Kyklas/projet-plury-4eii-2012/Rapports/MCSE.tex

% !TEX TS-program = pdflatex
% !TEX encoding = UTF-8 Unicode

%%% DOCUMENT DEFINITION
\documentclass[11pt,french]{article} % use larger type; default would be 10pt
\usepackage[utf8]{inputenc} % set input encoding (not needed with XeLaTeX)

%%% PAGE DIMENSIONS
\usepackage{geometry} % to change the page dimensions
\geometry{a4paper} % or letterpaper (US) or a5paper or....
\geometry{margin=1in} % for example, change the margins to 2 inches all round

%%% PACKAGES
\usepackage{graphicx} % support the \includegraphics command and options
\usepackage{booktabs} % for much better looking tables
\usepackage{array} % for better arrays (eg matrices) in maths
\usepackage{paralist} % very flexible & customisable lists (eg. enumerate/itemize, etc.)
\usepackage{verbatim} % adds environment for commenting out blocks of text & for better verbatim
\usepackage{subfig} % make it possible to include more than one captioned figure/table in a single float
\usepackage[frenchb]{babel}
\usepackage{pdflscape}
\usepackage{rotating}

% Package pour schémas MCSE
\usepackage{tikz}
\usetikzlibrary{calc,backgrounds}
\usetikzlibrary{arrows,positioning} 
\usetikzlibrary{decorations,decorations.pathmorphing} 
\usetikzlibrary{shapes,snakes,fit}

% Schémas individuels MCSE
\graphicspath{{../MCSE/}}

%%% HEADERS & FOOTERS
%\usepackage{fancyhdr} % This should be set AFTER setting up the page geometry
%\pagestyle{fancy} % options: empty , plain , fancy

% Rapport projet pluridisciplinaire
% : Xavier Galzin, Stanislas Bertrand, Romain Desille, Frédéric Meslin

\title{Projet pluridisciplinaire : sustentation magnétique}
\author{ Xavier GALZIN, Stan BERTRAND, Romain DESILLE, Fred MESLIN}
\date{30/01/2012}

\begin{document}
\maketitle
\pagebreak

\section*{Introduction}

Dans le cadre du projet pluridisciplinaire, le système étudié est assez complexe et comprend un certain nombre de fonctions parmi lesquelles on peut compter : 

\vspace{0.1cm}

\begin{itemize}
\item{la communication série}
\item{la gestion de la PWM}
\item{la gestion de la conversion analogique-numérique}
\end{itemize}

\vspace{0.3cm}

Afin d'éviter l'écueil fréquent qui consiste à concevoir la solution au même moment que la programmation et à aboutir à des solutions non fonctionnelles qui font finalement perdre du temps, nous allons mener une démarche de conception type Méthodologie et Conception de Systèmes Electroniques. 

\vspace{0.3cm}

Cette démarche s'articulera en deux parties principales. En premier lieu, nous définirons la spécification fonctionnelle qui comprend l'analyse de l'environnement, la délimitation des entrées-sorties du système ainsi que la spécifications fonctionnelle du système. Enfin, nous n'étudierons que la décomposition fonctionnelle de la partie de conception fonctionnelle. 

\pagebreak

\input{MCSE/Styles}
\part{Spécification fonctionnelle}

\setcounter{section}{0}

\section{Analyse de l'environnement}

\paragraph{} Dans cette partie, nous allons expliciter la décomposition en entités que nous avons retenu.
\vspace{0.2in}

\begin{minipage}[t]{9cm}
\hspace{0.2in}
\underline{Convertisseur Analogique-Numérique}
\begin{description}
\item[Sortie :] Sample, information, entier
\item[Sortie :] S\_Available, évènement
\item[Entrée :] S\_Query, évènement
\end{description}

\input{MCSE/Convertisseur.tex}
\end{minipage}
~
\begin{minipage}[t]{8cm}
\hspace{0.2in}
\underline{Pilotage Bobine (PWM)}
\begin{description}
\item[Entrée : ] Out, donnée permanente, entier
\end{description}

\input{MCSE/Pilotage.tex}
\end{minipage}

\begin{minipage}[h]{20cm}
\vspace{-1cm}
\hspace{0.2in}
\underline{Utilisateur}   
\begin{description}
\item[Sortie : ] Rx, donnée permanente, bit
\item[Entrée : ] Tx, donnée permanente, bit
\end{description}

 Pour des raisons de simplicité et d'uniformisation de l'envoi-réception de données, nous avons choisi d'envoyer et de recevoir trois octets à chaque transfert quelque soit la donnée transmise : un octet de commande et deux octets de donnée. Les bits non utilisées seront simplement mis à 0. 

\input{MCSE/Ordinateur.tex}
\vspace{-2cm}
\end{minipage}

\newpage

Les fonctions de Transmission/Réception, sont respectivement representées avec $T_x$ et $R_x$, or les deux péripheriques de communication série sont reliés via un cable croisé. Le $T_x$ de l'utilisateur est donc en realité le $R_x$ du système et inversement.

\begin{minipage}[t, h]{5cm}
\hspace{0.2in}
\underline{Fonction Transmission}
\end{minipage}
~
\begin{minipage}[t, h]{9cm}
\input{MCSE/Transmition.tex}
\end{minipage}

\begin{minipage}[t, h]{5cm}
\hspace{0.2in}
\underline{Fonction Réception}
\end{minipage}
~
\begin{minipage}[t, h]{9cm}
\input{MCSE/Reception.tex}
\end{minipage}

\section{Délimitation des E/S du système}

\input{MCSE/Systeme.tex}

\section{Spécification fonctionnelle du système}

Le système sera décomposé en trois blocs :
\vspace{0.1in}
\begin{description}
\item[Correction - Asservissement : ] Acquisition des données, Correction et Pilotage du PWM.
\item[Horloge : ] Gestion des différents temps et envoi des événements appropriés.
\item[Gestion Communication : ] Gestion de la communication avec l'utilisateur.
\end{description}

\vspace{0.2in}
\underline{Correction - Asservissement}

\begin{center}
\input{MCSE/CorrectionAsservissement.tex}
\end{center}

\vspace{0.2in}
\underline{Horloge}

\begin{minipage}[t, h]{8cm}
\input{MCSE/HorlogueIclk.tex}
\end{minipage}
~
\begin{minipage}[t, h]{8cm}
\input{MCSE/HorlogueTe.tex}
\end{minipage}

\underline{Gestion Communication}
\vspace{0.2in}

La partie Gestion Communication avec l'utilisateur est séparée en trois fonctions. La fonction de \textbf{gestion} lance les fonctions d'\textbf{écriture} ou de \textbf{lecture} suivant la valeur de RW.

%\vspace{0.2in}
%\hspace{0.2in}
%\underline{Modification}
%
%\begin{center}
%\input{MCSE/Modif.tex}
%\end{center}

\vspace{0.2in}
\hspace{0.2in}
\underline{Gestion Communication (Principale)}

\begin{center}
\input{MCSE/Communication.tex}
\end{center}

\pagebreak
\begin{landscape}

\hspace{0.2in}
\underline{Mode Lecture}

\hspace{-0.7in}
\input{MCSE/CommunicationRead.tex}

\vspace{0.5in}

\hspace{0.2in}
\underline{Mode Ecriture}

\hspace{-0.7in}
\input{MCSE/CommunicationWrite.tex}

\end{landscape}

\part{Conception fonctionnelle}

\setcounter{section}{0}

\section{Décomposition fonctionnelle}

\begin{center}
\begin{turn}{90}
\input{MCSE/ConceptFonct.tex}
\end{turn}
\end{center}

\pagebreak

\setcounter{section}{0}

\section*{Conclusion}

Grâce à l'étude type MCSE que nous avons mené, nous avons pu décomposer notre système en fonctions élémentaires. Cela facilitera la programmation en la rendant plus modulaire et donc plus facilement débuggable.  

\vspace{0.2cm}

En outre, en ce qui concerne la communication, nous avons pu envisager les problèmes possibles à l'avance et donc concevoir un protocole robuste permettant de les gérer. Cela sera très certainement bénéfique pour la phase de développement afin d'éviter une majorité des difficultés et de pouvoir résoudre rapidement celles qui subsisteraient.  
\end{document}
