Kyklas/projet-plury-4eii-2012/Rapports/MCSE/ConceptFonct.tex

\tikzset{
VPH/.style={inner sep=0,minimum width=0.4cm,minimum height=0.2cm,
path picture={\draw[-,black] (path picture bounding box.west) -- (path picture bounding box.east);
\draw[-,black] (path picture bounding box.north west) -- (path picture bounding box.south west);
\draw[-,black] (path picture bounding box.north east) -- (path picture bounding box.south east);}},
VPV/.style={inner sep=0,minimum height=0.4cm,minimum width=0.2cm,
path picture={\draw[-,black] (path picture bounding box.north) -- (path picture bounding box.south);
\draw[-,black] (path picture bounding box.north west) -- (path picture bounding box.north east);
\draw[-,black] (path picture bounding box.south west) -- (path picture bounding box.south east);}}}

\shorthandoff{:}
\begin{tikzpicture}[font=\small]

\node[draw,align=center,inner sep=10pt] (CORR) {Correction\\Asservissement};

\foreach \id in {1,...,3}
{
\coordinate (CORR-N\id) at ($(CORR.north)+(\id*0.7cm-1.4cm,0)$);
}

\foreach \id in {1,...,4}
{
\coordinate (CORR-E\id) at ($(CORR.north east)+(0,-\id*0.3cm)$);
}

\node at ($(CORR)+(5,-2.4)$) [draw,align=center,inner sep=10pt] (COMM) {Gestion\\Communication};
\foreach \id in {-1,1}
{
\coordinate (COMM-S\id) at ($(COMM.south)+(\id*0.3cm,0)$);
}
\foreach \id in {1,...,4}
{
\coordinate (COMM-N\id) at ($(COMM.north east)+(-\id*0.7cm,0)$);
}

\foreach \id in {1,...,2}
{
\coordinate (COMM-E\id) at ($(COMM.east)+(0,-\id*0.6cm+0.9cm)$);
}

\node at ($(CORR)+(0,-4)$) [draw,align=center,inner sep=10pt] (CLK) {Clock};

\foreach \id in {-1,1}
{
\coordinate (CLK-E\id) at ($(CLK.east)+(0,\id*0.2cm)$);
}

\node[draw,inner sep=20pt,fit=(CORR) (COMM) (CLK)](SYS) {};

\node at ($(CORR.north)+(0,2.5)$) [ellipse,decoration={bumps,mirror},decorate,draw,align=center] 
(CONV)
{Convertisseur \\ Analogique-Numérique};

\foreach \id in {1,...,3}
{
\coordinate (CONV-S\id) at ($(CONV.south)+(\id*0.7cm-1.4cm,0)$);
}

\node at ($(CORR.west)+(-5,0)$) [ellipse,decoration={bumps,mirror},decorate,align=center,draw] 
(BOB)
{Pilotage Bobine \\ Pulse Width Modulation};

\node at ($(COMM)+(5,0)$) [ellipse,decoration={bumps,mirror},inner sep=0.3cm,decorate,draw]
(USER)
{Utilisateur};

\foreach \id in {1,...,2}
{
\coordinate (USER-W\id) at ($(USER.west)+(0,-\id*0.6cm+0.9cm)$);
}

\path (USER-W1) -- node[VPV,label={[label distance = 0.1cm]above right:Rx}] (mid) {} (COMM-E1);
\draw[->] (USER-W1) -- (mid.center);
\draw[->] (mid.center) -- (COMM-E1);

\path (USER-W2) -- node[VPV,label={[label distance = 0.1cm]above right:Tx}] (mid) {} (COMM-E2);
\draw[<-] (USER-W2) -- (mid.center);
\draw[<-] (mid.center) -- (COMM-E2);

\path (CORR) -- node[VPV,label={[label distance = 0.2cm]above left:Out}] (mid) {} (BOB);
\draw[->] (CORR) -- (mid.center);
\draw[->] (mid.center) -- (BOB);

\path (COMM-N1) |- node[VPV,label={[label distance = 0.1cm,pos=0.6]above left:Consigne},pos=0.6] (mid) {} (CORR-E1);
\draw[->] (COMM-N1) |- (mid.center);
\draw[->] (mid.center) -- (CORR-E1);

\path (COMM-N2) |- node[VPH,label={[label distance = 0.05cm,pos=0.1]above left:Kp},pos=0.1] (mid) {} (CORR-E2);
\draw[->] (COMM-N2) -- (mid.center);
\draw[->] (mid.center) |- (CORR-E2);
\path (COMM-N3) |- node[VPH,label={[label distance = 0.05cm,pos=0.1]above left:Td},pos=0.1] (mid) {} (CORR-E3);
\draw[->] (COMM-N3) -- (mid.center);
\draw[->] (mid.center) |- (CORR-E3);
\path (COMM-N4) |- node[VPH,label={[label distance = 0.1cm,pos=0.1]above left:Nb acquisition},pos=0.1] (mid) {} (CORR-E4);
\draw[->] (COMM-N4) -- (mid.center);
\draw[->] (mid.center) |- (CORR-E4);

\path (COMM-S-1) |- node[VPH,label={[label distance = 0.1cm,pos=0.3] left:Te},pos=0.3] (mid) {} (CLK-E1);
\draw[->] (COMM-S-1) -- (mid.center);
\draw[->] (mid.center) |- (CLK-E1);

\draw[dashed] (CLK) -- node[solid,isosceles triangle,draw,pos=0.5,rotate=90,fill=white,minimum size=3mm,inner sep=0,label={[label distance = 0.2cm,pos=0.5]below:$Te_{clk}$}] {} (CORR);

\draw[dashed] (CLK-E-1) -| node[solid,isosceles triangle,draw,pos=0.3,fill=white,minimum size=3mm,inner sep=0,label={[label distance = 0.2cm,pos=0.3]below:$Te_{clk}$}] {} (COMM-S1);

\draw[dashed] (CONV-S1) -- node[solid,isosceles triangle,draw,pos=0.5,rotate=90,fill=white,minimum size=3mm,inner sep=0,
		label={[label distance = 0.1cm,pos=0.5]above right:S\_Querry}] {} (CORR-N1);

\path (CONV-S2) -- node[VPH,label={[label distance = 0.1cm,pos=0.5,rotate=-90] above:Sample},pos=0.5] (mid) {} (CORR-N2);
\draw[->] (CONV-S2) -- (mid.center);
\draw[->] (mid.center) -- (CORR-N2);

\draw[dashed] (CONV-S3) -- node[solid,isosceles triangle,draw,pos=0.5,rotate=-90,fill=white,minimum size=3mm,inner sep=0,
		label={[label distance = 0.1cm,pos=0.5]above left:S\_available}] {} (CORR-N3);

\end{tikzpicture}
