Kyklas/projet-plury-4eii-2012/Rapports/MCSE/Ordinateur.tex

\vspace{-2cm}
\hspace{-4cm}
\begin{tikzpicture}%[every node/.style={font=\tiny}]

\Etape{T}{}

\draw (T) -- ($(T)+(-4,0)$) node[inner sep=0,outer sep=0] (E3) {};

\TransLink{T1}{Volonté Ecriture}{E3}

\EtapeLink{E1}{$T_{Data}:=Commande$, /Volonté d'envoyer}{T1}

\TransLink{T2}{Fin Transmition}{E1}

\EtapeLink{E2}{$T_{Data}:=Donnee_{[15,8]}$, /Volonté d'envoyer}{T2}

\TransLink{T3}{Fin Transmition}{E2}

\EtapeLink{E2}{$T_{Data}:=Donnee_{[7,0]}$, /Volonté d'envoyer}{T3}

\TransLink{T3}{Fin Transmition}{E2}

\draw[->] (T3) edge [out=-90, in=160,out distance=4cm,in distance=9cm] node[inner sep=0,outer sep=0,minimum width=0cm,pos=0.2] (RET){} (T);

\draw (T) -- ($(T)+(4,0)$) node[inner sep=0,outer sep=0] (E1) {};

\TransLink{T1}{Volonté Lecture}{E1}

\EtapeLink{E1}{$T_{Data}:=Commande$, /Volonté d'envoyer}{T1}

\TransLink{T2}{Fin Transmition}{E1}

\EtapeLink{E2}{Lecture}{T2}

\TransActionLink{T3}{Fin Réception \\ $Donnee_{[15,8]}=R_{Data}$}{E2}

\EtapeLink{E2}{Lecture}{T3}

\TransActionLink{T3}{Fin Réception \\ $Donnee_{[7,0]}=R_{Data}$}{E2}

\draw[->] (T3) edge [out=-90,in=-48,out distance=1cm] (RET.center);

\end{tikzpicture}
\vspace{-2cm}
