Kyklas/projet-plury-4eii-2012/Rapports/MCSE/Modif.tex

\begin{tikzpicture}\shorthandoff{:}

\node[Etape,double,label={[align=left]right:Modif}] (I) {};

\TransActionLink{T1}{$Cmd.AP = 1$\\ }{I}

\node[align=left,anchor=north west,at =(T1.south east),xshift=10pt] {$K_p := SK_p$\\$T_dT_d$\\$T_e := ST_e$\\$Consigne := SConsigne$\\$Nb_{Acq} := SNb_{Acq}$};

\node[Trans,node distance = 1.1cm, align=center,left of=T1,label=left:{$Cmd.AP = 0$}] (T2) {};

\node[Etape,double,below of=I,node distance=4.5cm,label={[align=left]right:Modif End}] (E) {};

\draw[->] (I) edge [in=90,out=200] (T2);
\draw[->] (T2) edge[out=-90] (E);

\draw[->] (T1) edge (E);

\end{tikzpicture}
