Kyklas/projet-plury-4eii-2012/Rapports/MCSE/Styles.tex

\shorthandoff{:}
\newcommand{\Etape}[2]{
\node[Etape,label={right:#2}] (#1) {};
}
\newcommand{\EtapeLink}[3]{
\node[Etape,below of=#3,label={[align=left]right:#2}] (#1) {};
\draw[->] (#3) -- (#1);
}

\newcommand{\EtapeMacroLink}[3]{
\node[Etape,double,below of=#3,label={[align=left]right:#2}] (#1) {};
\draw[->] (#3) -- (#1);
}

\newcommand{\TransLink}[3]{
\node[Trans,align=center,below of=#3] (#1) {};
\node[align=center,anchor=west,at =(#1.east),xshift=10pt] {#2};
\draw[->] (#3) -- (#1);
}
\newcommand{\TransActionLink}[3]{
\node[Trans,align=center,below of=#3] (#1) {};
\node[Line,align=center,anchor=west,at =(#1.east),xshift=10pt] {#2};
\draw[->] (#3) -- (#1);
}

%	\tikzset{every node/.style={font=\small, node distance =  0.6cm}}
	\tikzset{Etape/.style={draw,black,minimum size=0.6cm,inner sep=0pt,circle,font=\tiny}}
	\tikzset{Trans/.style={draw,black,minimum width=0.6cm,minimum height=0.0cm,inner sep=0pt,outer sep=0pt,rectangle,font=\tiny}}
	
	%\tikzset{Line/.style={path picture={\draw[black] (path picture bounding box.north west) -- (path picture bounding box.north east);}}}
	\tikzset{Line/.style={path picture={\draw[black] (path picture bounding box.west) -- (path picture bounding box.east);}}}
