Kyklas/projet-plury-4eii-2012/Automatique/Constantes.tex

\hspace{1mm} \\ 
\hspace{1mm}\textcolor{green}{\% Paramètres du Système }\\ 
\hspace{1mm} \\ 
\hspace{1mm}\textcolor{green}{\% Modèle Electrique de la Bobine }\\ 
\hspace{1mm}R=2.24; \textcolor{green}{\%Ohm }\\ 
\hspace{1mm}L=1.49e-2; \textcolor{green}{\%H }\\ 
\hspace{1mm} \\ 
\hspace{1mm}\textcolor{green}{\% Modèle d'interaction mécanique de la bobine }\\ 
\hspace{1mm}m=0.1414; \textcolor{green}{\%Kg }\\ 
\hspace{1mm}ki=0.446; \textcolor{green}{\%N.A-1 }\\ 
\hspace{1mm}kx=131.54; \textcolor{green}{\%N.m-1 }\\ 
\hspace{1mm} \\ 
\hspace{1mm}\textcolor{green}{\% Modèle capteur effet Hall }\\ 
\hspace{1mm}Kc\_Hall=36.5;  \\ 
\hspace{1mm} \\
