Kyklas/projet-plury-4eii-2012/Rapports/MCSE/Transmition.tex

\begin{tikzpicture}[every node/.style={font=\footnotesize, node distance =  0.7cm}]
\Etape{I}{$T_x:=Bit_{Stop}$}
\TransLink{T1}{Volonté d'envoyer}{I}
\EtapeLink{S}{$T_x:=Bit_{Start}$}{T1}
\TransActionLink{T2}{$\uparrow$ I$_{clk}$ \\ $i:=8$}{S}
\EtapeLink{D}{\emph{Bit de donnée}}{T2}
%\tikzstyle{every label}={draw,red,font=\tiny}

\node[Trans,node distance = 1cm,left of=D] (T) {};
\node[Line,align=center,anchor=east,at =(T.west),xshift=-10pt] (V) {$\uparrow$ I$_{clk}$ $\cdot$ $i>0$\\[1em]$T_x:=T_{Data}[i]$, $i$-\,- };
\draw[->] (D) edge [out=225,in=-90] (T);
\draw[->] (T) edge [out=90,in=135] (D);

\TransLink{T3}{$\uparrow$ I$_{clk}$ $\cdot$ $i=0$}{D}
\EtapeLink{S}{$T_x:=Bit_{Stop}$}{T3}
\TransActionLink{T4}{$\uparrow$ I$_{clk}$ \\ /Fin Transmission}{S}

\draw[-] (T4) edge [out=-90,in=-90] ($(V.west)-(10pt,0)$);
\draw[->] ($(V.west)-(10pt,0)$) edge [out=90] (I);
\end{tikzpicture}
