Kyklas/projet-plury-4eii-2012/Rapports/MCSE/CommunicationWrite.tex

\vspace{-1cm}
\begin{tikzpicture}[every node/.style={font=\footnotesize, node distance =  0.9cm}]
\shorthandoff{:}

\node[Etape,double,label=right:Mode Ecriture] (I) {};
%\Etape{I}{Mode Ecriture}
\TransActionLink{T}{Fin Réception \\ $Donnee_{[15,8]} = R_{Data} $ }{I}
\EtapeLink{I2}{Réception deuxieme octet}{T}

\TransActionLink{T}{Fin Réception \\ $Donnee_{[7,0]} = R_{Data} $ }{I2}
\EtapeLink{I2}{}{T}

\node[Etape,double,below of=I2,node distance=2.5cm,label={[align=left]below right:Mode Ecriture End}] (MODIF) {};
%\TransLink{T21}{1}{MODIF}
%\EtapeLink{E22}{Attente\\Commande}{T21}

\draw (I2) -- ($(I2)+(-11,0)$) node[inner sep=0,outer sep=0] (E10) {};
\TransLink{T10}{$Cmd.P_{[3..0]} = 0 (Aucun)$\\$ + $\\$P_{[3..0]} > 5 (Aucun)$}{E10}

\draw[->] (T10) |- (MODIF);

%\EtapeMacroLink{E11}{Modif}{T10}
%\TransLink{T11}{1}{E11}
%\EtapeLink{E12}{Attente\\Commande}{T11}

\draw (I2) -- ($(I2)+(-6,0)$) node[inner sep=0,outer sep=0] (E20) {};
\TransActionLink{T20}{$Cmd.P_{[3..0]} = 1 $ $(K_p)$ \\ $SK_p$ := $Donnee$ }{E20}
\draw[->] (T20) |- (MODIF);
%\EtapeMacroLink{E21}{Modif}{T20}
%\TransLink{T21}{1}{E21}
%\EtapeLink{E22}{Attente\\Commande}{T21}

\draw (I2) -- ($(I2)+(-1.7,0)$) node[inner sep=0,outer sep=0] (E30) {};
\TransActionLink{T30}{$Cmd.P_{[3..0]} = 2 $ $(T_d$) \\ $ST_d$ := $Donnee$}{E30}
\draw[->] (T30) |- (MODIF);
%\EtapeLink{E31}{}{T30}
%\TransActionLink{T31}{Fin Réception\\$ST_d$ := $R_{Data}$}{E31}
%\EtapeLink{E32}{Attente\\Commande}{T31}
%\TransLink{T32}{/Modif}{E32}
%\EtapeLink{E33}{Attente\\Commande}{T32}

\draw (I2) -- ($(I2)+(+2.6,0)$) node[inner sep=0,outer sep=0] (E40) {};
\TransActionLink{T40}{$Cmd.P_{[3..0]} = 3 $ $(T_e)$ \\$ST_e$ := $Donnee$}{E40}
\draw[->] (T40) |- (MODIF);
%\EtapeLink{E41}{}{T40}
%\TransActionLink{T41}{Fin Réception\\$ST_e$ := $R_{Data}$}{E41}
%\EtapeLink{E42}{Attente\\Commande}{T41}
%\TransLink{T42}{/Modif}{E42}
%\EtapeLink{E43}{Attente\\Commande}{T42}

\draw (I2) -- ($(I2)+(+6.9,0)$) node[inner sep=0,outer sep=0] (E50) {};
\TransActionLink{T50}{$Cmd.P_{[3..0]} = 4 $ $(Consigne)$\\$SConsigne$ := $Donnee_{[9,0]}$}{E50}
\draw[->] (T50) |- (MODIF);
%\EtapeLink{E51}{}{T50}
%\TransActionLink{T51}{Fin Réception\\$SConsigne$ := $R_{Data}$}{E51}
%\EtapeLink{E52}{Attente\\Commande}{T51}
%\TransLink{T52}{/Modif}{E52}
%\EtapeLink{E53}{Attente\\Commande}{T52}

\draw (I2) -- ($(I2)+(+12,0)$) node[inner sep=0,outer sep=0] (E60) {};
\TransActionLink{T60}{$Cmd.P_{[3..0]} = 5 $ $(Nb_{Acq})$\\$SNb_{Acq}$ := $Donnee_{[7,0]}$}{E60}
\draw[->] (T60) |- (MODIF);
%\EtapeLink{E61}{}{T60}
%\TransActionLink{T61}{Fin Réception\\$SNb_{Acq}$ := $R_{Data}$}{E61}
%\EtapeLink{E62}{Attente\\Commande}{T61}
%\TransLink{T62}{/Modif}{E62}
%\EtapeLink{E63}{Attente\\Commande}{T62}
\end{tikzpicture}
