Kyklas/projet-plury-4eii-2012/Rapports/Automatique/SchemaBlocNum.tex

\begin{tikzpicture}\shorthandoff{:}
\sbEntree{Vxc}
\sbComp{Comp}{Vxc}
	\sbRelier[$Vx_C$]{Vxc}{Comp}
\sbBloc{C}{$K_{p}$}{Comp}
	\sbRelier[$\epsilon_x$]{Comp}{C}
\sbBlocL{B}{$BOZ$}{C}	
\sbBlocL{E}{$Sys_{Elec + M\acute{e}ca}$}{B}
\sbBlocL{H}{$K_{Hall}$}{E} 
\sbDecaleNoeudx[3]{H}{Ec}
\node[font=\tiny,label={[font=\tiny]below:$T_e$}] at(Ec)  {};
\draw (H) -- (Ec);
\draw (Ec.north west) -- (Ec.east);

\sbSortie[3]{Vxr}{Ec} 
	\sbRelier{Ec}{Vxr}
	\sbNomLien[0.8]{Vxr}{$Vx_R$} 
\sbDecaleNoeudy{E}{A}
\sbBlocr[0]{A}{$H_{correcteur}$}{A}
\sbRelieryx{Ec-Vxr}{A}
\sbRelierxy{A}{Comp}

\node[draw,dotted,inner sep=8pt,fit=(B) (Ec),label={[font=\small]above:$H_{syst\grave{e}me}$}] {};

\end{tikzpicture}
