Kyklas/projet-plury-4eii-2012/Carte/PCB/descriptif des versions de la puissance 2.txt

puissance2 :   ++ respecte la taille de la carte prévue initialement
               -- des connexions passent entre les pattes du pont en H

puissance2_2 : ++ pas de connexions qui passent entre les pattes du pont en H
               -- agrandissement de la carte (léger) en x et en y

puissance2_3 : ++ pas de connexions qui passent entre les pattes du pont en H, pas d'agrandissement requis
               -- piste de masse longue et torteuse pour relier Vref->C2->Masse
