Kyklas/projet-plury-4eii-2012/Rapports/Presentation.odp

## Projet Pluridisciplinaire


## Plan

- Objectif de la réalisation
  - Etude Analogique
  - Etude Numérique
- Réalisation des cartes
  - Conditionnement et correction analogique
  - Micro-contrôleur
  - Liaison USB
  - Gestion de la puissance
- Résultats de la lévitation
- IHM & communication
- Gimmicks

## Stabilisation Analogique

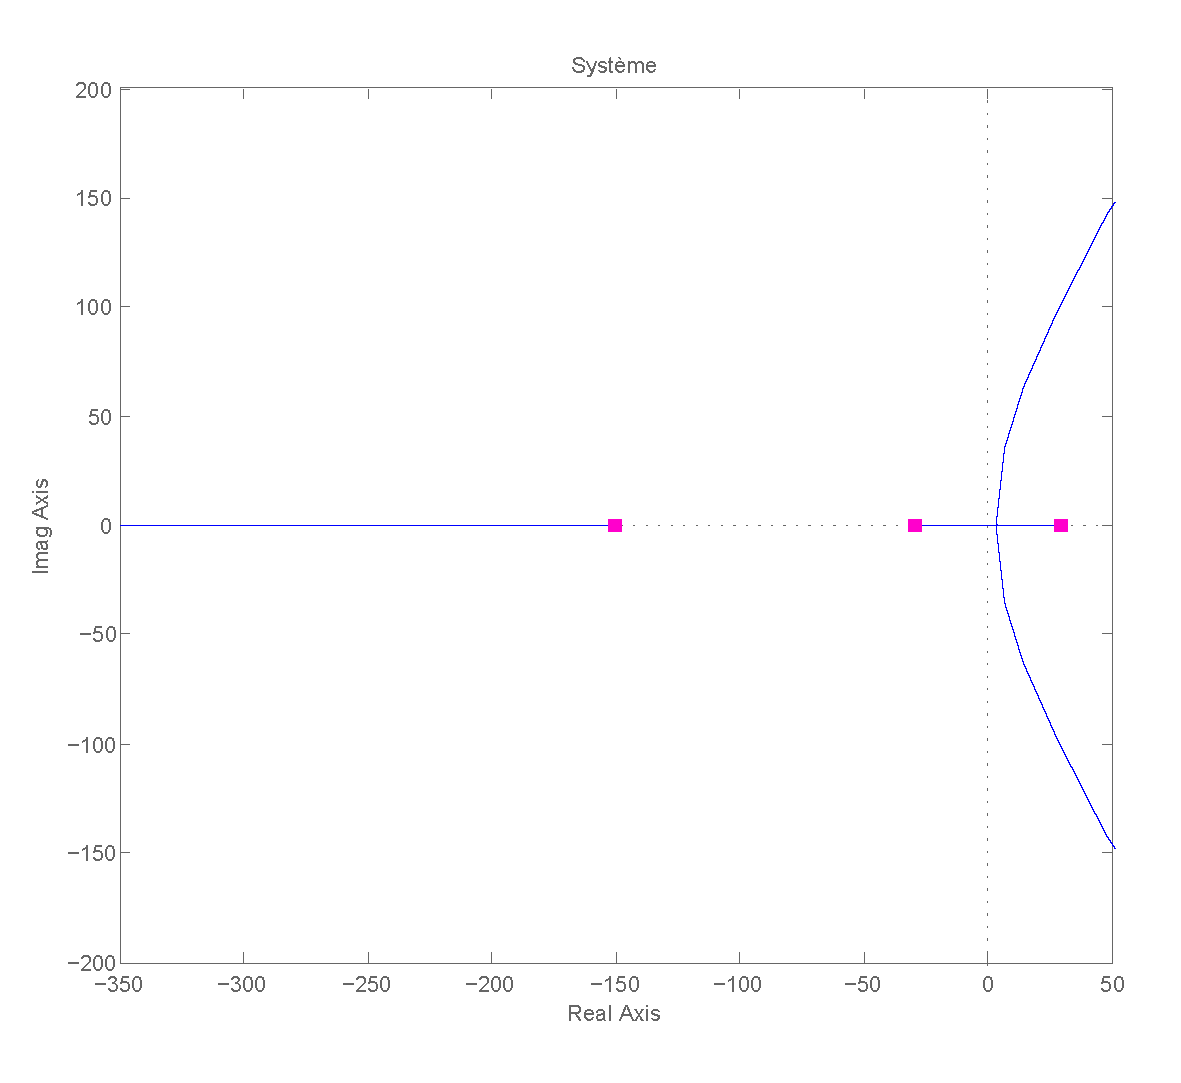
[picture p33: figure]
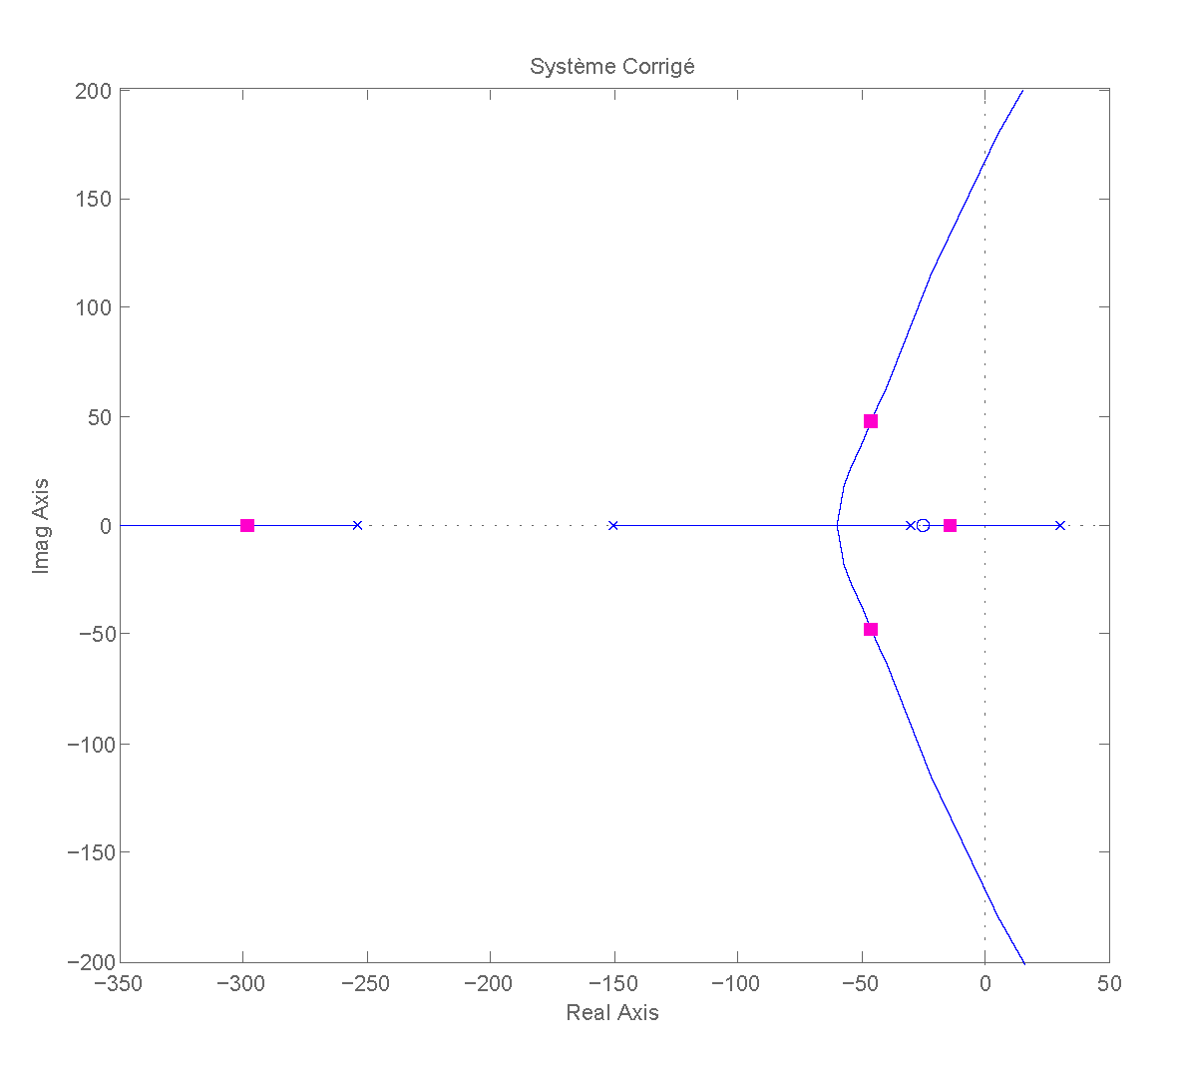
[picture p34: figure]

- Système naturellement instable
- Correction du système par un avance de phase (1 Pôle et 1 Zéro)
  - Position du zéro importante, avant le premier pôle négatif
  - Gain minimum nécessaire : 20

## Stabilisation Numérique

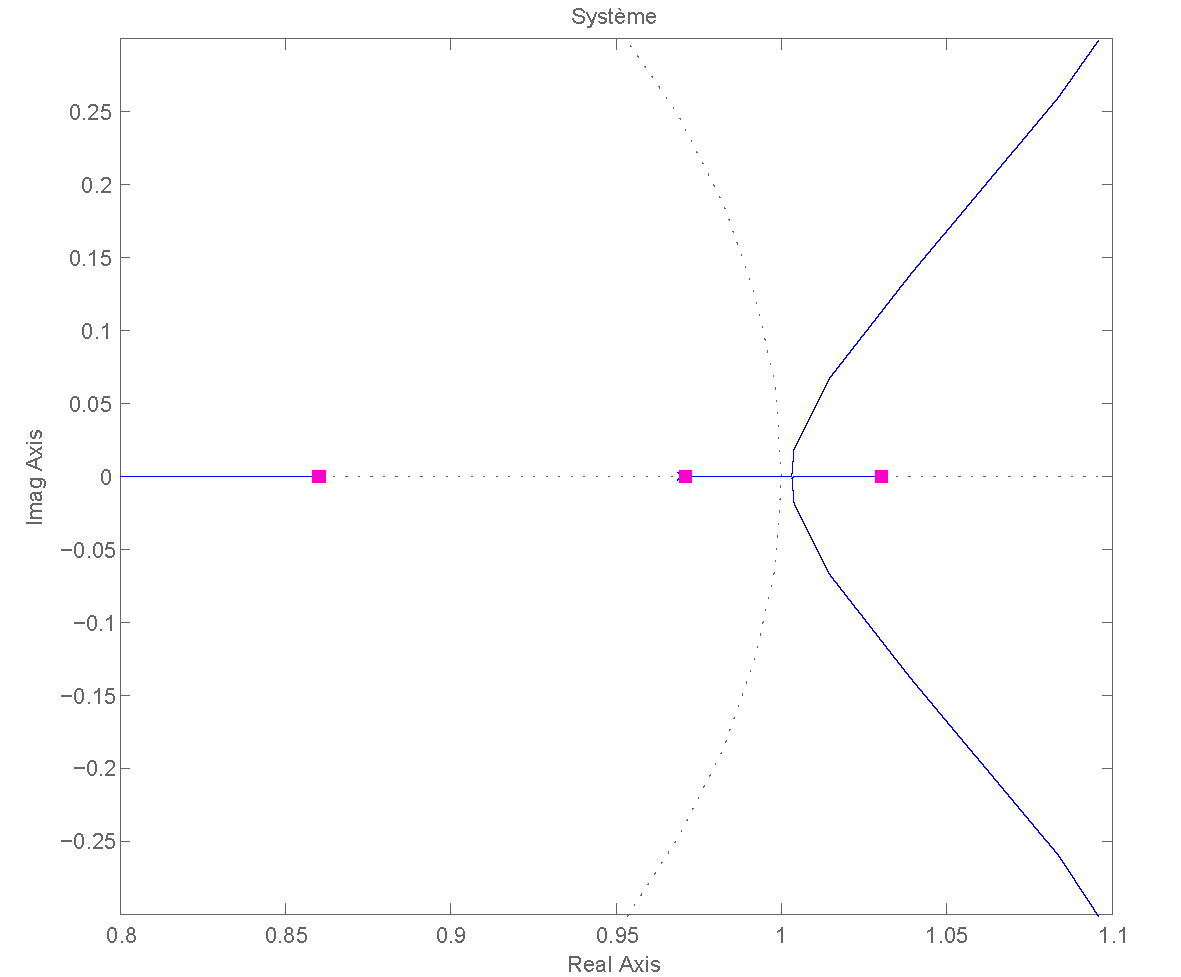
[picture p35: figure]

- Correction du système par un avance de phase (1 Pôle et 1 Zéro)
  - Position du zéro importante, avant le premier pôle négatif
  - Gain minimum nécessaire : 18.5
  - Période d’actualisation : 1 ms

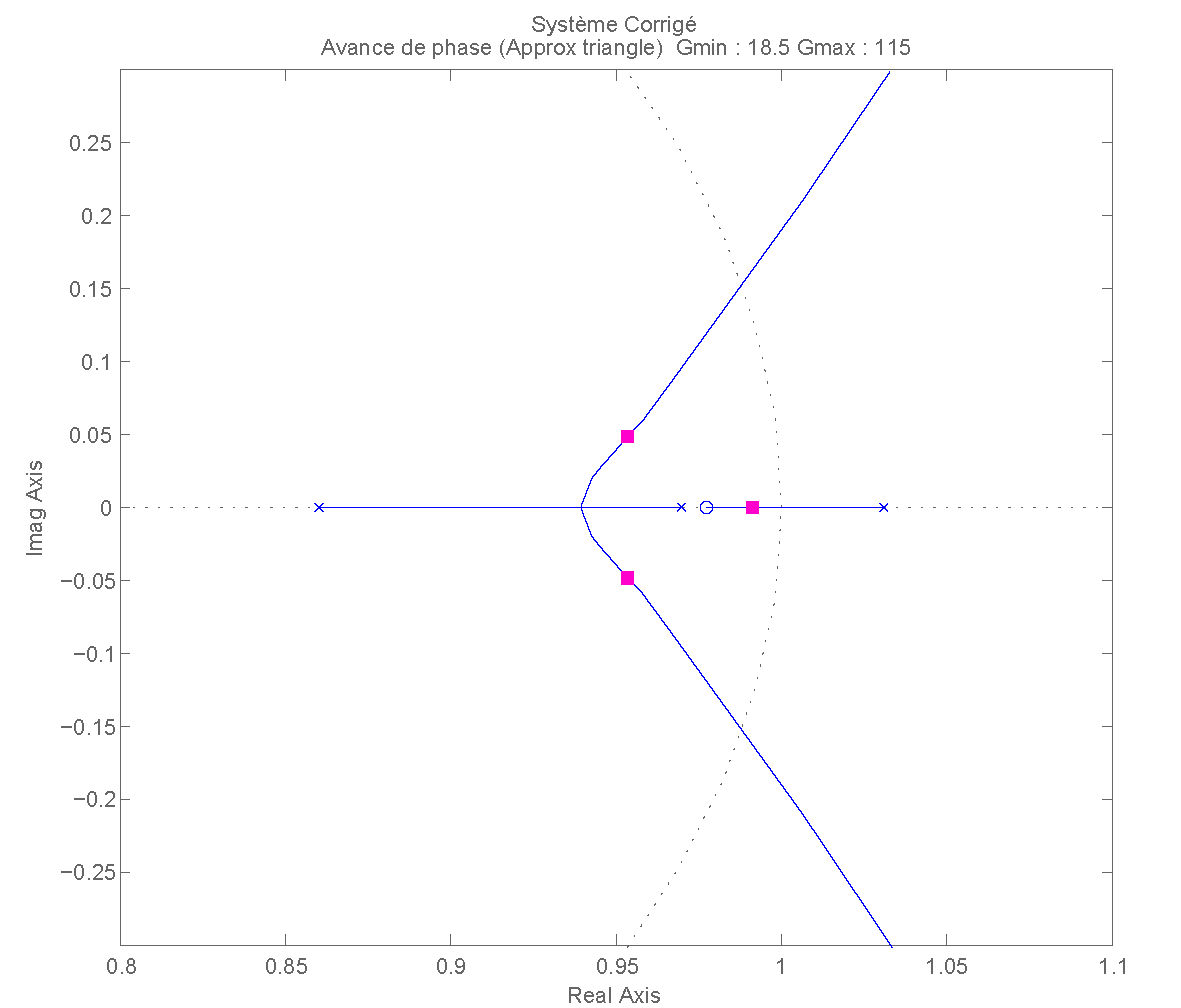
[picture p36: figure]

## Réalisation de la carte Carte mère projet

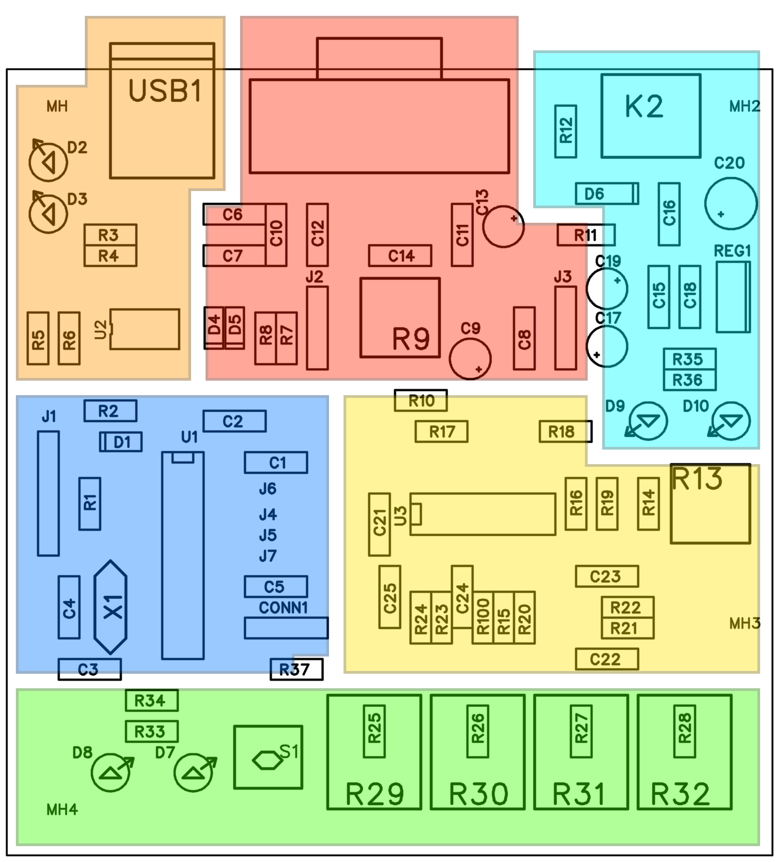
[picture p37: figure]

Interface de
puissance

Alimentation
régulée

Liaison série

Micro-contrôleur

Correcteur
analogique

IHM

## Conditionnement et correction analogique

- Amplificateur d'instrumentation (LM324 - 3 AOPs)
- Correcteur à avance de phase (LM324 - 1 AOPs)


- Forte impédance d'entrée
- Fort rejection du mode commun
- Gain règlable par une résistance
- Adapté pour gains élevés

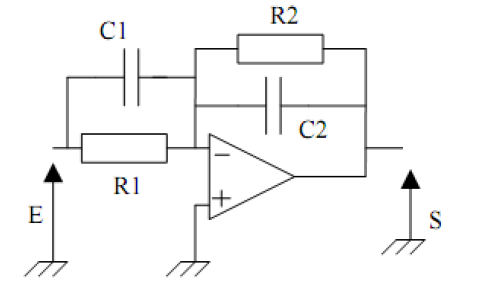
[picture p38: figure]

H(s) = {{R_2} over {R_1}} times {{1 + R_1*C_1*s} over {1 + R_2*C_2*s}}

## Micro-contrôleur

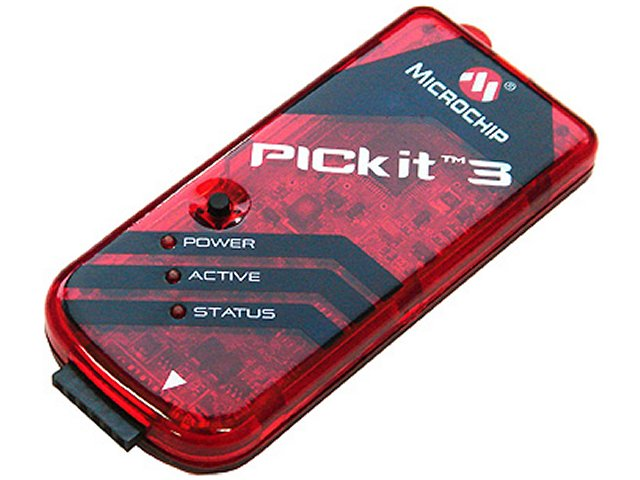
[picture p39: figure]

Sonde de programmation PICKit3

- Microcontrôleur PIC 24FV32KA301 de Microchip
- Architecture 16-bits 32 MHz
- Mémoire programme : 4 ko
- Mémoire données : 2 ko
- Tension de travail : 1.8 to 5.5
- 2-UART, 2-SPI, 2-I2C

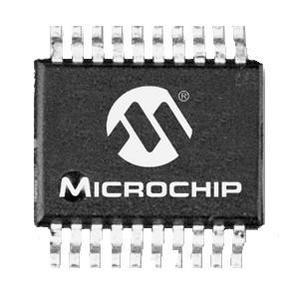
[picture p40: figure]

- 1-A/D 16x12-bit @ 100 ksps
- 3-modules PWM 16 bits
- 5-timers 16 bits
- Multiplicateur hardware
- Semi-diviseur hardware

## Conditionnement et correction analogique


Architecture du FTDI232R

- Contrôleur FT232R de FTDI
- Contrôleur USB 2.0 vers RS232
- De 300 à 3 Mbauds
- Niveaux compatibles TTL
- Périphérique standard COM
- Configuration automatique

## Gestion de la puissance


Ancien pont en fusion

- Pont L6203 de ST- Microelectronics


- Alimentation : 48 V max
- Courant de pointe : 5 A max
- Courant de travail : 4 A
- RDSon : 0.3 Ω @ 25 °C
- Compatible niveaux TTL
- Fréquence : 100 KHz max
- Protection thermique

## Lévitation analogique

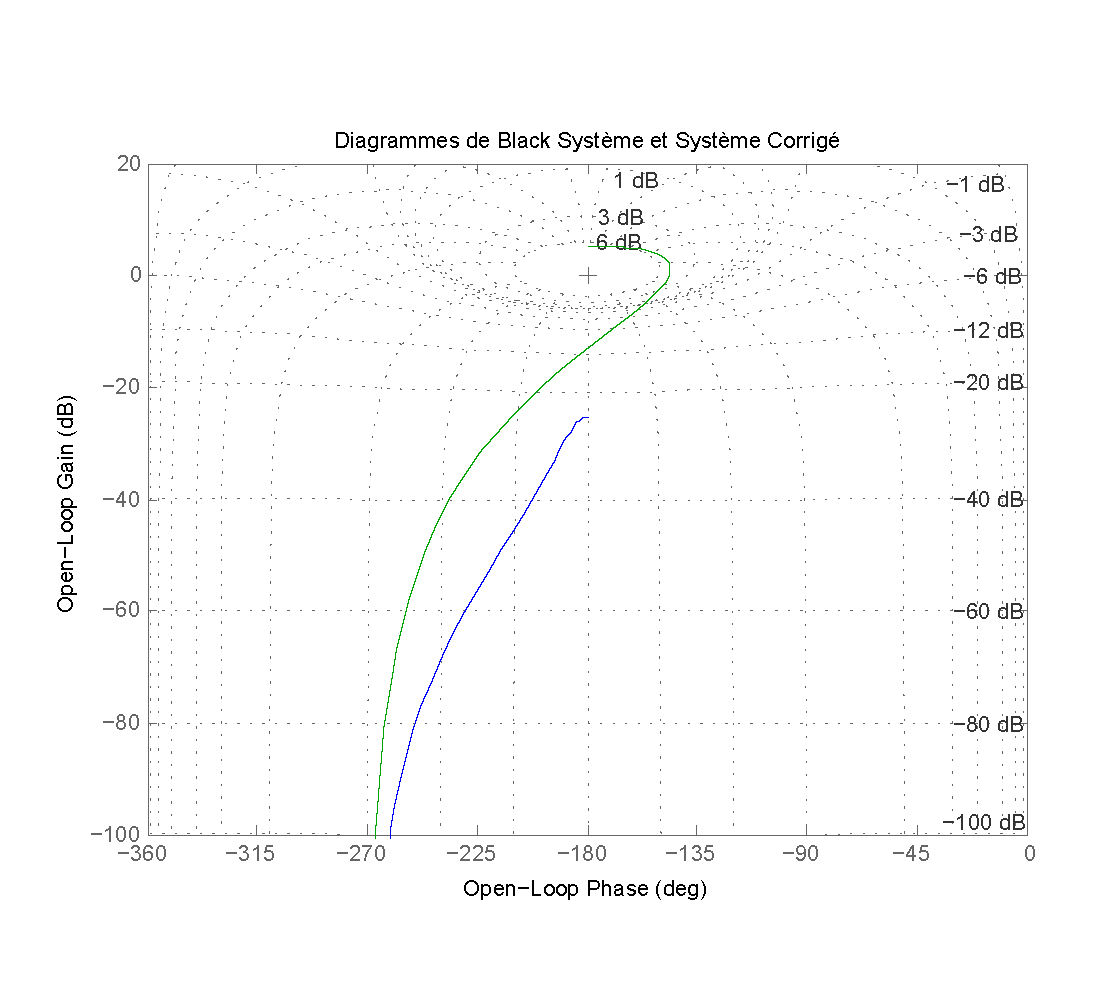
[picture p41: figure]

- Le mobile lévite avec de légères oscillations
- Gain de boucle présent : 33.6

## Lévitation numérique

Première correction fonctionnelle

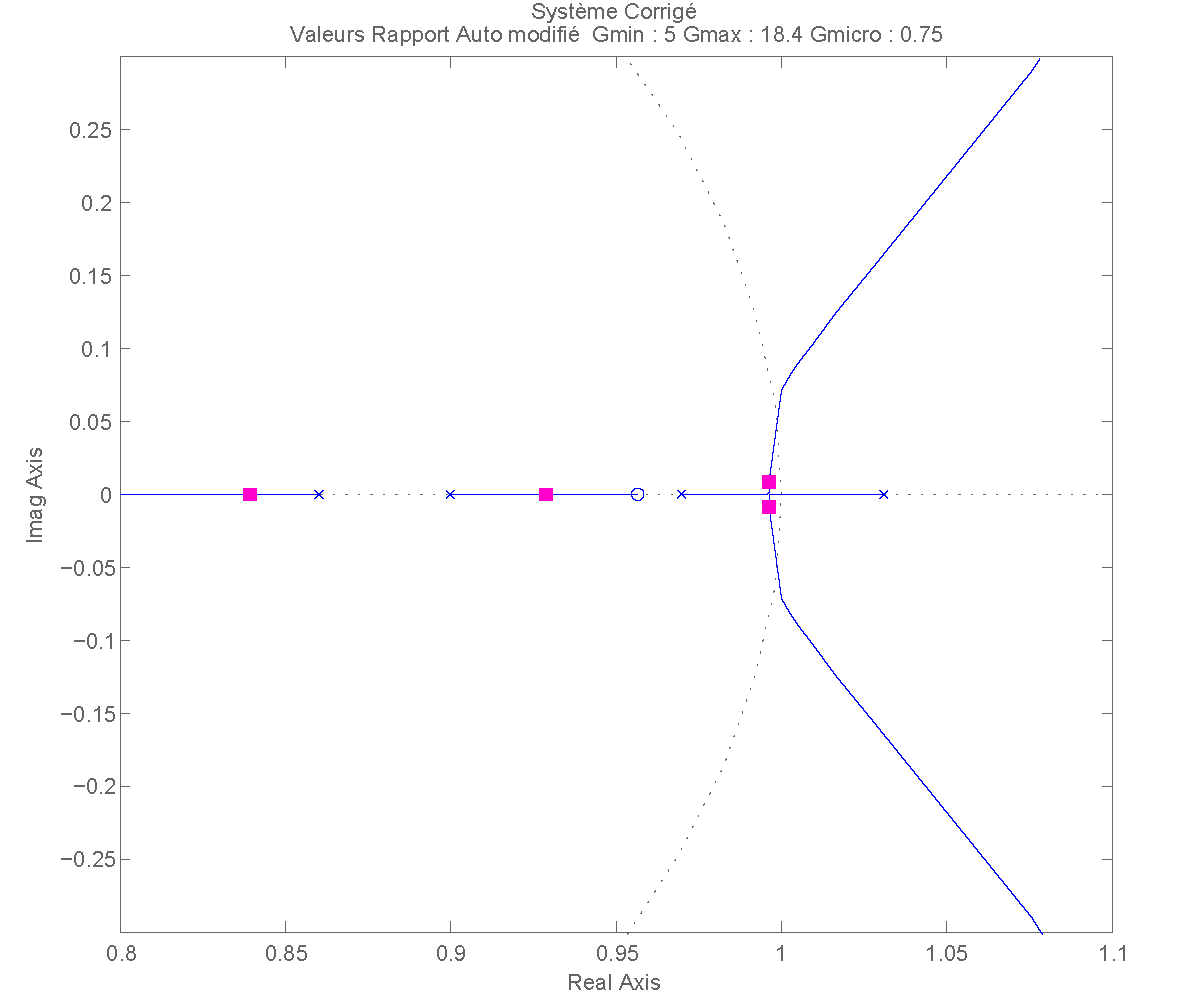
[picture p42: figure]

- Zone de stabilité très faible
- Zéro du correcteur après le premier pôle négatif
- Gain minimum nécessaire faible : 5
- Le mobile lévite avec des oscillations rapides et de faibles amplitudes

## Lévitation numérique 2

Correction fonctionnelle améliorée

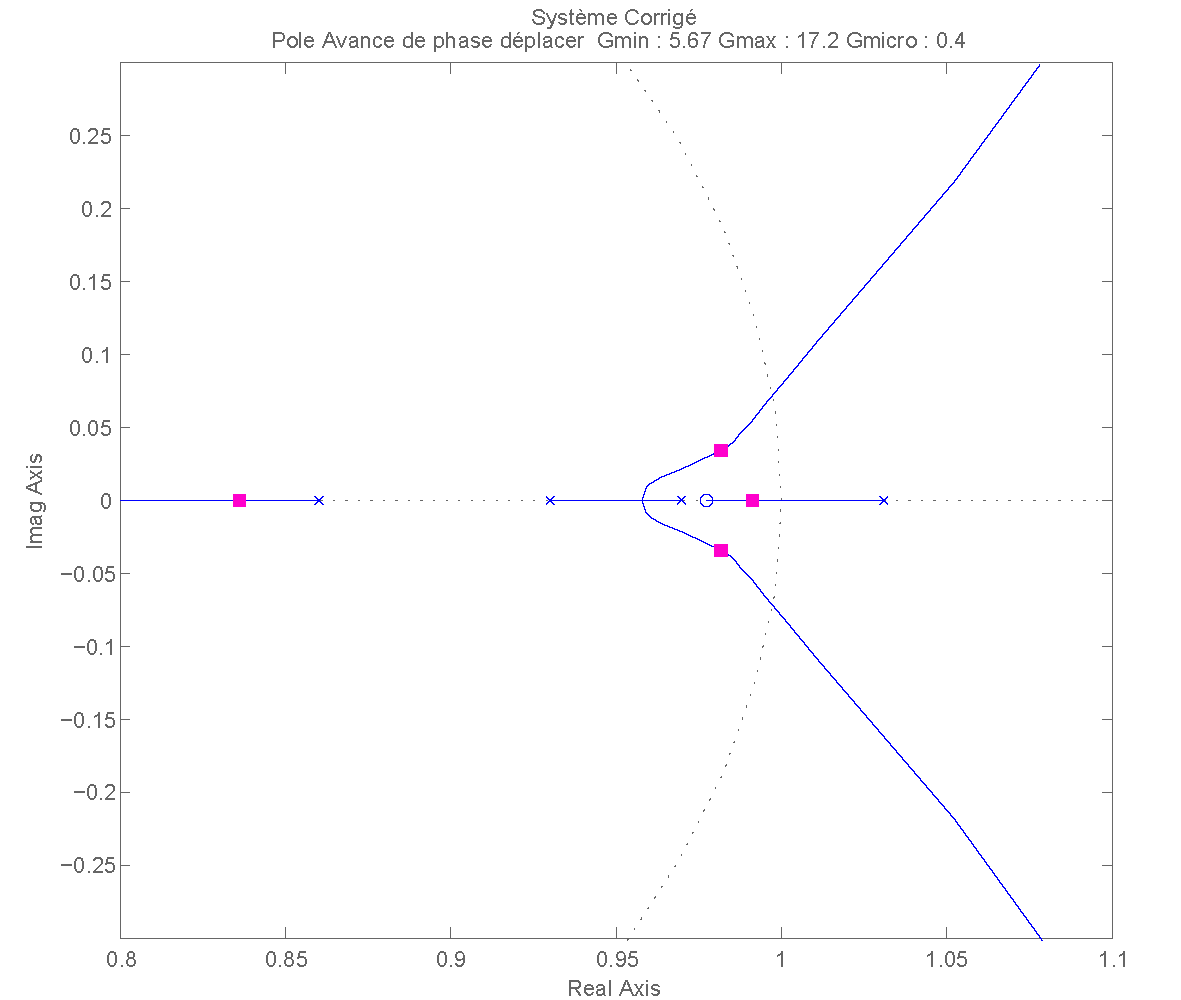
[picture p43: figure]

- Modification du correcteur théorique
- Zone de stabilité améliorée
- Gain minimum nécessaire faible : 5,67
- Le mobile lévite avec de légères oscillations

Difficulté d’utiliser le gain souhaité en numérique, tests à poursuivre …

## Protocole de communication

- Trames de commande :
- Trames de données :

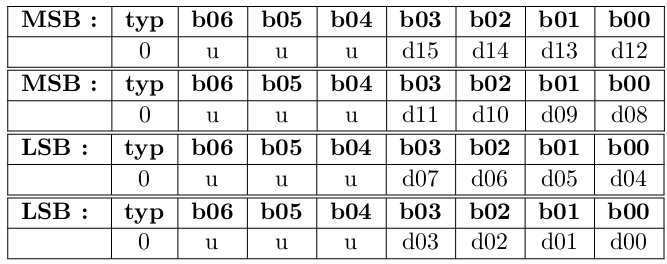
[picture p44: figure]

## Interface homme - machine

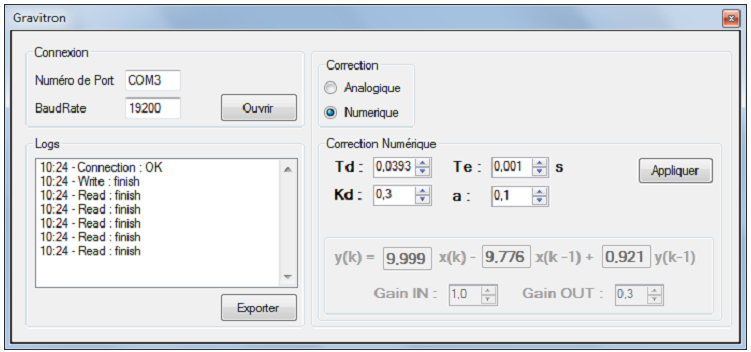
[picture p45: figure]

Vue de l'interface de contrôle réalisée en C#

## Gimmicks


Un air bien connu !

- Acquisition de mesures, archivage et export CSV
- A la fermeture de l’application :
  - Pas de chute du mobile
  - La bobine chante !

## Conclusion

- Des améliorations sont possibles :
  - Une correction non linéaire
  - Une IHM plus perfectionnée
  - Une connectivité à un réseau domotique
  - Possibilité de piloter la consigne numériquement
- Toujours plus de Gimmicks !
