Kyklas/projet-plury-4eii-2012/Rapports/SolutionNumerique/Systeme.pdf

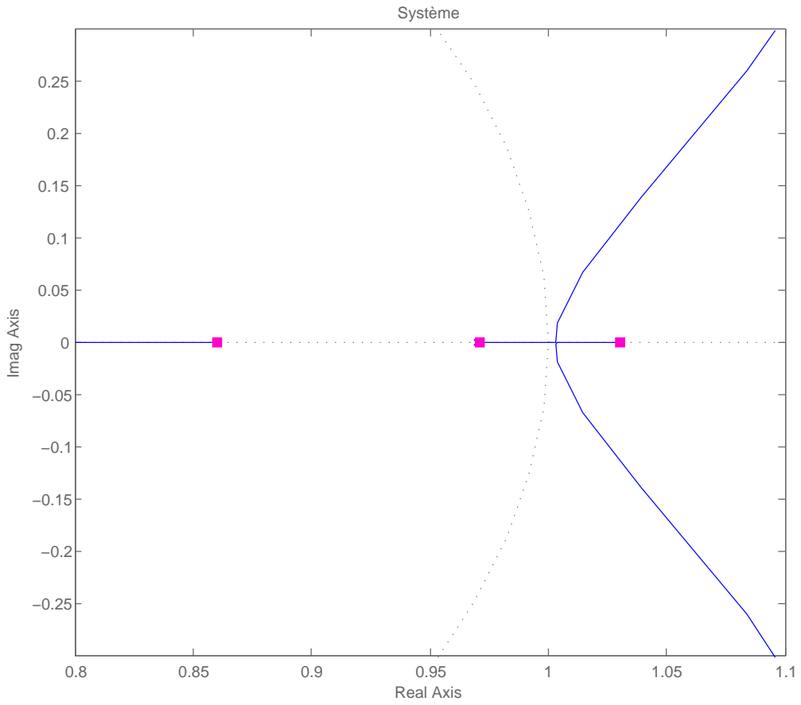
[picture p55: figure]
Système; Real Axis; Imag Axis
