Kyklas/projet-plury-4eii-2012/Rapports/SolutionNumerique/SystemeCorrigeThorique.pdf

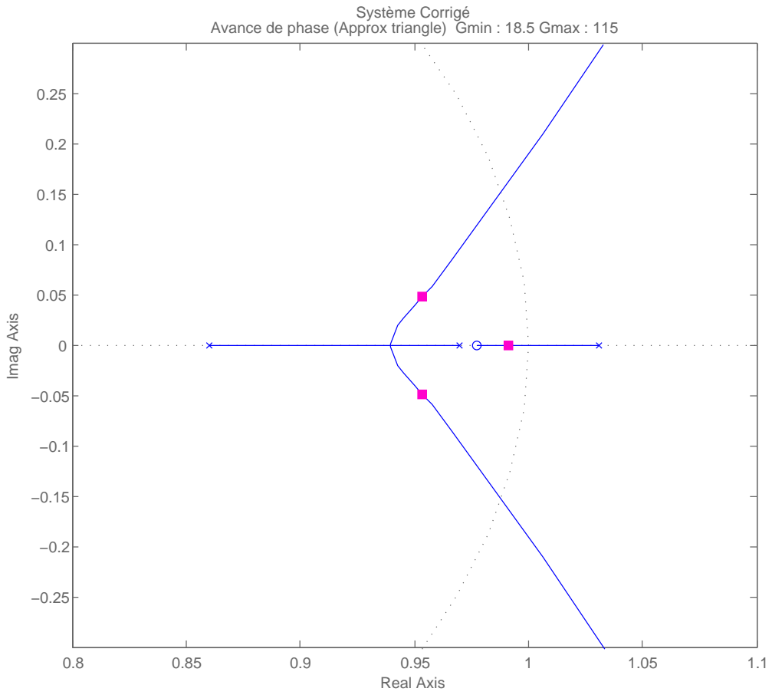
[picture p56: figure]
Système Corrigé; Real Axis; Imag Axis

Avance de phase (Approx triangle) Gmin : 18.5 Gmax : 115
