Kyklas/projet-plury-4eii-2012/Rapports/SolutionAnalogique/BodeAvPhase.pdf

05

10

15

20

Magnitude (dB)

System: Cor_av
Frequency (rad/sec): 101
Magnitude (dB): 10

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
System: Cor_av
Frequency (rad/sec): 101
Phase (deg): 54.9
Phase (deg)

Bode Diagram

Frequency (rad/sec)
