Kyklas/projet-plury-4eii-2012/Automatique/RL_Sys_AvPh_K27.pdf

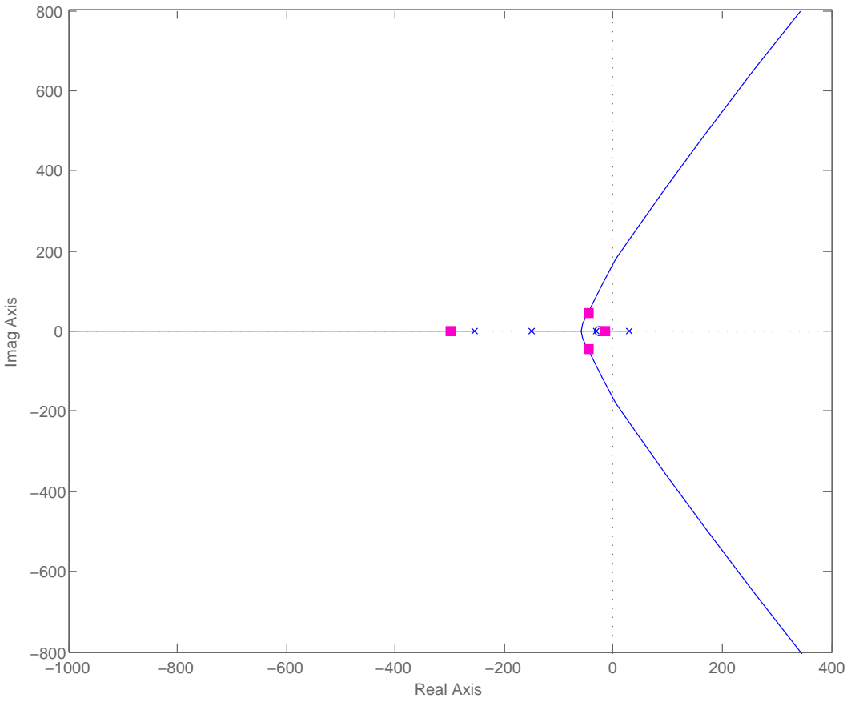
[picture p57: figure]
Real Axis; Imag Axis
