Kyklas/projet-plury-4eii-2012/Automatique/RLN_Sys_AvPh_K27.pdf

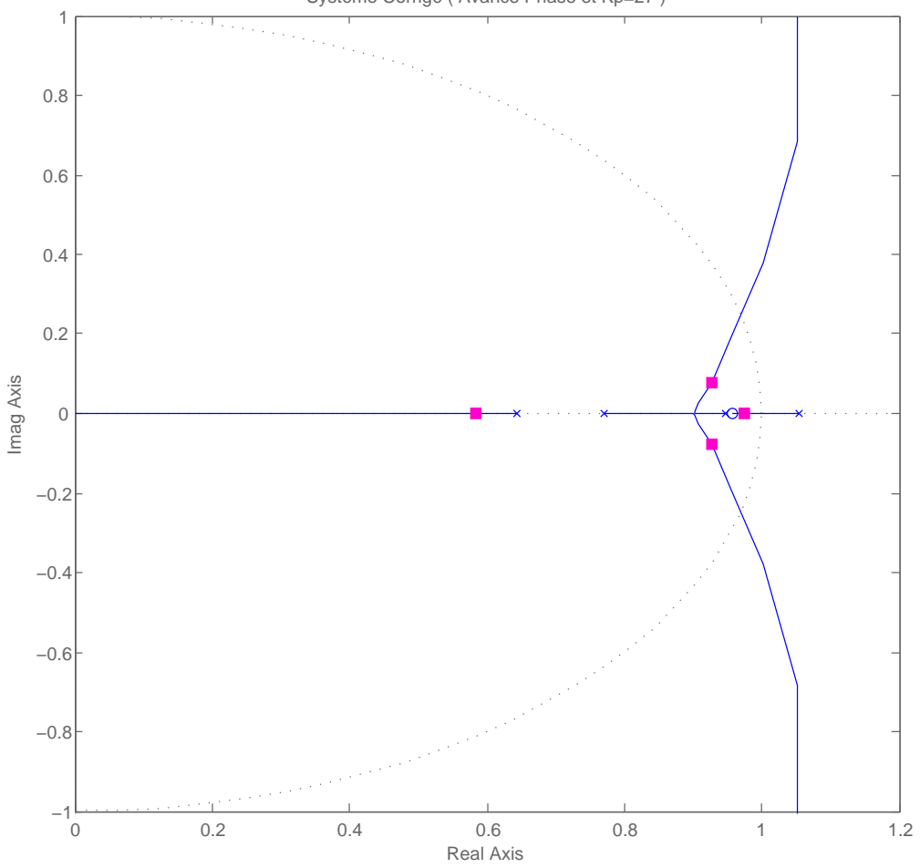
[picture p58: figure]
Real Axis; Imag Axis

Système Corrigé ( Avance Phase et Kp=27 )
