Kyklas/projet-plury-4eii-2012/Automatique/RLN_Sys_Seul.pdf

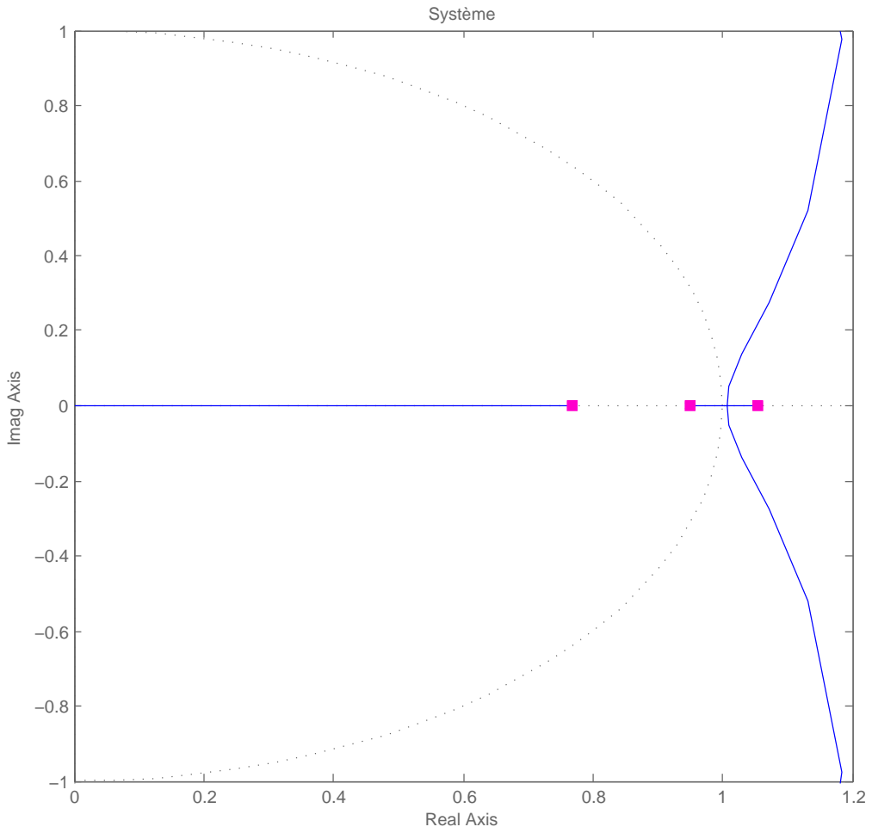
[picture p59: figure]
Système; Real Axis; Imag Axis
