Kyklas/projet-plury-4eii-2012/Carte/Schematique/Support-Cours-Commande-Analogique-Master-Electrotechnique10.pdf

Université Aboubekr Belkaid Tlemcen Faculté de Technologie
Département de Génie Electrique et Electronique

## GEE

Module Commande Analogique.

### Par A.Meghebbar

### Sommaire :

Rappels.
Synthèse des lois de commande par approche fréquentielle classique. Régulateurs PI-PID.
Structures particulières de commande.
Commande dans l’espace d’état.

Chapitre1 Synthèse des lois de commande par approche fréquentielle.

### Cahier des charges d’un asservissement/régulation :

En règle générale, le cahier des charges d’une boucle de régulation impose, en boucle fermée,

### quatre performances : - la précision, matérialisée par la valeur de l’erreur de position p

ε ( | → 0 p
ε | ou la plus
faible possible) ; ainsi que celle de l’erreur de vitesse,

### - La rapidité, matérialisée par une valeur maximale du temps de réponse ou du temps

de montée,
- la marge de stabilité, matérialisée par la valeur de la marge de phase,

### - la limitation du dépassement, ce qui se traduit par une valeur optimale du

coefficient d’amortissement.

### Rôle du correcteur :

Pour assurer une compatibilité entre les critères contradictoires de stabilité et de précision et

### améliorer les performances du système asservi ,on introduit des dispositifs de correction constitués par des réseaux de transmissions passifs ou actifs(structure câblée).Ces

correcteurs ont pour but de délivrer un signal de commande ,noté u(t) au système de manière à préserver les exigences de précision et de stabilité à priori incompatibles ;li sera l’élément intelligent du système.

### Principe général de la correction d’un système :

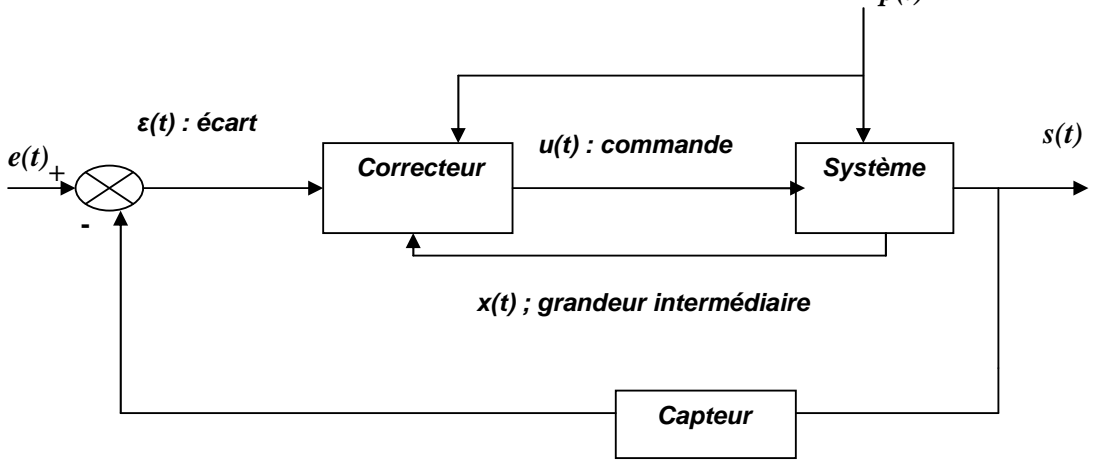
[picture p60: figure]
Correcteur; Capteur; Système; x(t) ; grandeur intermédiaire; u(t) : commande; ε(t) : écart

### Figure 1.1 Principe général de la correction

u(t) = f (ε (t), x(t), p(t)ete(t)) : Selon la nature de cette fonction, on distingue différents types de correction. : série, parallèle et par anticipation.

### Correction série :

Le correcteur C(p) est introduit dans la chaîne directe en amont du système, son rôle essentiel consiste à modifier les performances du système initial, suivant le cahier de charges. Il agit simultanément sur les précisions statique et dynamique, sur la rapidité et sur la stabilité.

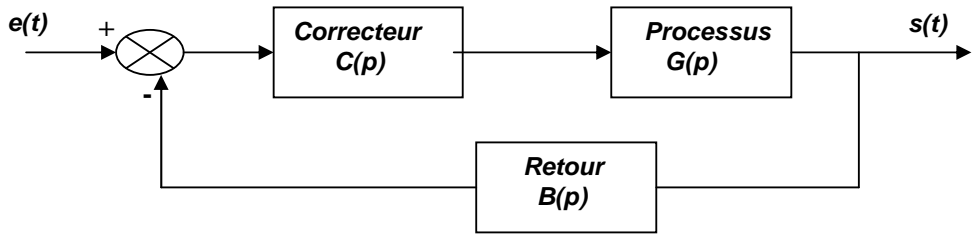
[picture p61: figure]
Correcteur C(p); Retour B(p); Processus G(p)

Figure 1.2 Correction série.

### Dans ce cas la commande u(t) = f(ε), on distingue alors trois fonctions :

### - La loi de commande proportionnelle ou action proportionnelle notée P :

u(t) = Kε (t) → Fonction de transfert du correcteur C(p) = K.

### - Action intégrale, notée I :

= ∫

## t dt →

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
ε | Fonction de transfert du correcteur
T p

C p

i

1
( ) = .

### - Action dérivée, notée D :

= →
dt

d t

## u t Td

( )
( )

ε

### Fonction de transfert du correcteurC p T p = d

( ) .

p(t)

Un correcteur série réalise plus ou moins parfaitement des combinaisons de ces trois actions

### En première approximation on peut dire que l’action P augmente la bande passante et par

conséquent la rapidité et la précision dynamique ; l’action I annule l’erreur statique mais entraîne un effet déstabilisant enfin l’action D par un apport de phase complémentaire, tend à stabiliser le système.

### Correction parallèle :

La correction parallèle ne permet pas l’introduction d’une intégration ; le correcteur C(p) se greffe en parallèle sur un élément fixe de la chaîne et agit essentiellement sur la stabilité et la rapidité.

### Correction par anticipation : Le correcteur C(p) appelé aussi compensateur élimine théoriquement l’influence des

perturbations p(t).

### Exemple : Les effets de la perturbation p(t) sont compensées par C ( p)

comp

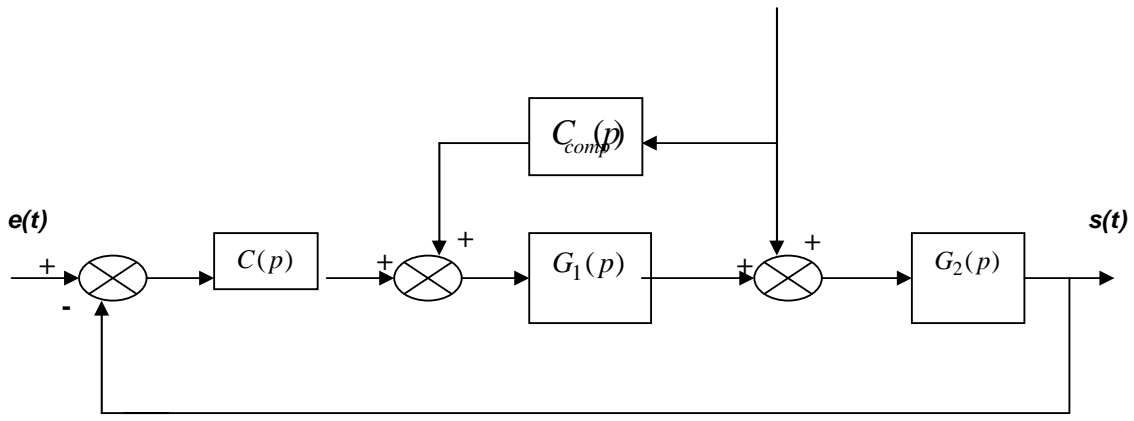
[picture p62: figure]
C (p) comp

Figure 1.3 Compensateur :
( )

1
( )

1

. | G p
C | p comp | = −

Correction série.

Principe de correction et structure des correcteurs :

### 1. Correcteur proportionnel :

Le correcteur proportionnel est un simple amplificateur de gain réglable, C(p) = K.
Si K > 1, on améliore la rapidité et la précision du système en boucle fermée mais on diminue la stabilité et on accroit son dépassement.

### - Action du correcteur :

p(t)

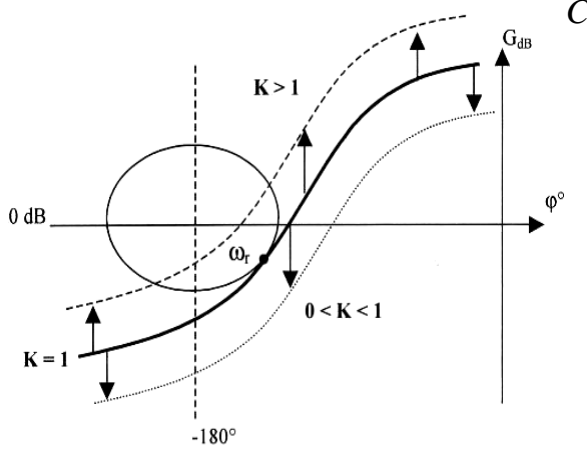
[picture p63: figure]

Figure 1.4 Action du correcteur, lieu de Black.

Ce correcteur équivaut à une translation de la courbe dans le plan de Black et de la courbe du module dans le plan de Bode.

### - Circuit électrique :

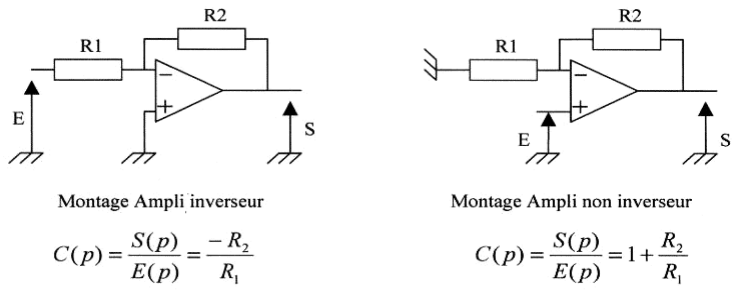
[picture p64: figure]

Figure 1.5 Circuit électrique du correcteur proportionnel.

### 2. Correcteur proportionnel et intégral :

### - Fonction de transfert du correcteur proportionnel et intégral :

)

1
1(
p

# CdB K

τ

= +

### - Lieu de transfert du correcteur proportionnel et intégral :

## dB C( p)

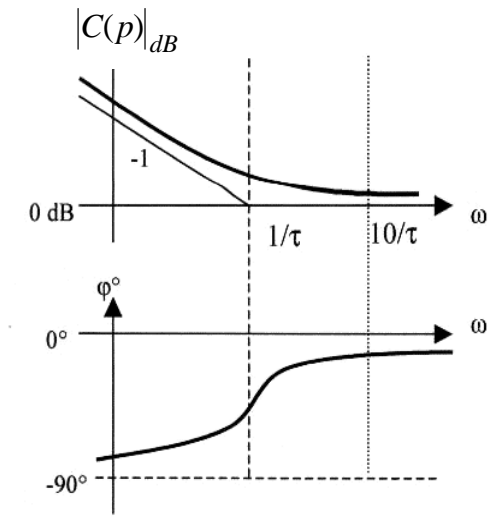
[picture p65: figure]
aTp; avec a > 1. )

Figure 1..6 Lieu de transfert du correcteur proportionnel et intégral.

### - Action du correcteur :

Ce correcteur introduit un pôle à l’origine. L’action de ce correcteur se fait sur les basses fréquences. La présence d’un intégrateur annule l’erreur statique, mais il ralentit le système et

### le déstabilise s’il est mal placé. Il n’influe pratiquement plus la phase pour les hautes

fréquences | )

10 (
τ

ω f .

- Mise en place : (Méthode du pôle dominant).
1. Exprimer la fonction de transfert en boucle ouverte,

### 2. Supprimer le pôle dominant

min

1
p

### τ = − = constante de temps la plus grande (le pôle

### dominant correspond à la plus grande constante de temps du système, donc au pôle dominant

car c’est lui qui limite la rapidité du système),

3. Déterminer K pour avoir une marge de phase suffisante (ou celle imposée par le cahier de charge).

### - Circuit électrique :

1

2

R

R

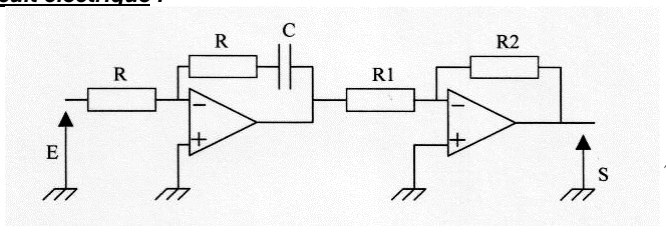
[picture p66: figure]

K

R C
=

τ =

Figure 1.7 Circuit électrique du correcteur proportionnel et intégral.

3. Correcteur à retard de phase ;

### On utilise généralement le correcteur à retard de phase de fonction de transfert :

b p

p
C p | K
1 | .

1 .
( )
τ

τ
+

+
= | avec b >1

### - Lieu de transfert du correcteur à retard de phase :

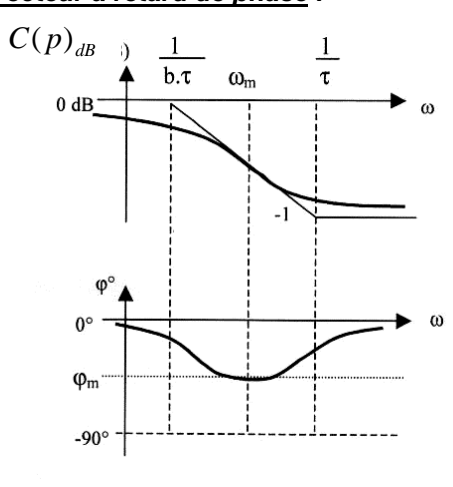
[picture p67: figure]

Figure 1.8 Lieu de transfert du correcteur à retard de phase.

### Avec les relations :

b

m
τ

ω

1
= | et
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
### sinϕ

### Action du correcteur :

Agit en basses fréquences, il permet de réduire l’erreur statique, il ralentit le système (diminue la bande passante), et le déstabilise s’il est mal placé (τ petit).

### Si ω co

τ

p

1

### (la pulsation de coupure en boucle ouverte), on augmente la marge de phase en

conservant un bon gain en basses fréquences, mais on a une diminution de la bande passante,

### dans ce cas, l’effet du correcteur a la forme suivante (lieu de Black):

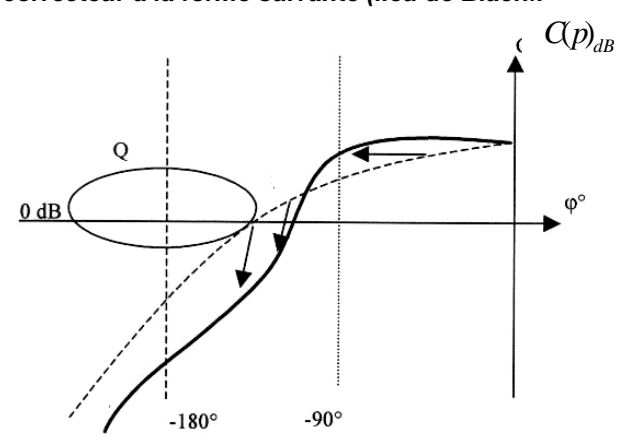
[picture p68: figure]

Figure 1.9 Effet du correcteur à retard de phase (lieu de Black).

### - Circuit électrique :

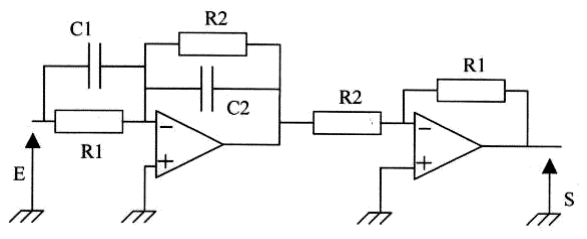
[picture p69: figure]

## R C p

## R C p

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
= | avec R2C2 f R1C1

Figure 1.10 Circuit électrique du correcteur à retard de phase.

4. Correcteur proportionnel et dérivée / Correcteur à avance de phase.

### - Fonction de transfert du correcteur proportionnel et dérivée :

C( p) = K 1( +τp).Le gain de ce correcteur est infini pour les hautes fréquences.

### Ceci est donc physiquement irréalisable, on l’approxime par :

p

p

## C p K

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
### avec τ très petit devant d

τ .

### - Lieu de transfert du correcteur proportionnel et dérivée :

## dB C( p)

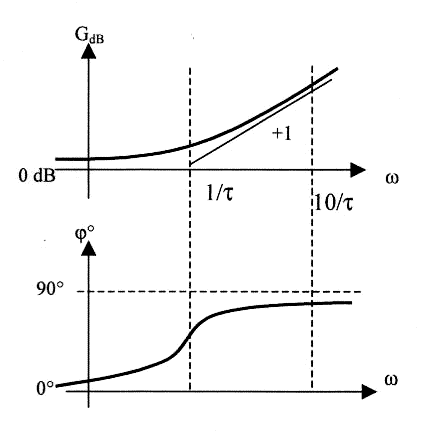
[picture p70: figure]

Figure 1.11 Lieu de transfert du correcteur proportionnel et dérivée(Bode).

### - Action du correcteur:

L’action de ce correcteur se fait sur les hautes fréquences.
Son effet est stabilisant et à tendance à augmenter la rapidité. On remarque aussi, sur son lieu

de Bode, que ce correcteur induit un gain infini en hautes fréquences et qu’à.
τ

10

### , le gain

apporté est de 20dB et la phase apportée est quasiment de 90°.

### Pour être efficace, ce correcteur doit vérifier : ωR

τ

p

1

### c'est-à-dire l’effet doit se produire

suffisamment tôt.

### Il y a donc augmentation de la marge de phase, de la marge de gain, de la pulsation de

résonnance et de la bande passante.
De plus, en augmentant K, on augmente la stabilité et la précision du système.

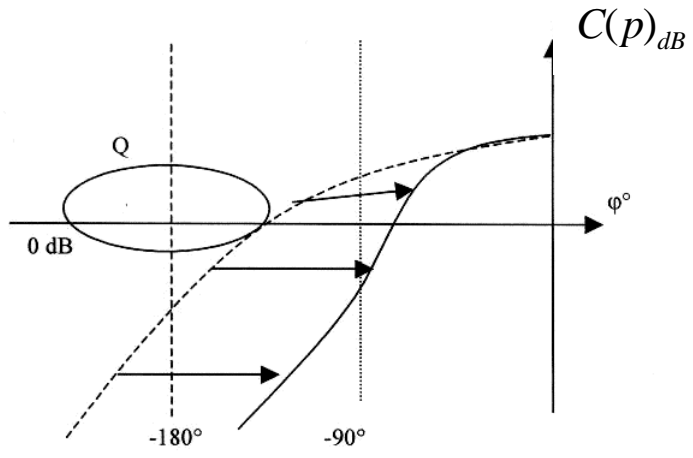
[picture p71: figure]

Figure 1.12 Effet du correcteur proportionnel et dérivée (lieu de Black).

### - Circuit électrique :

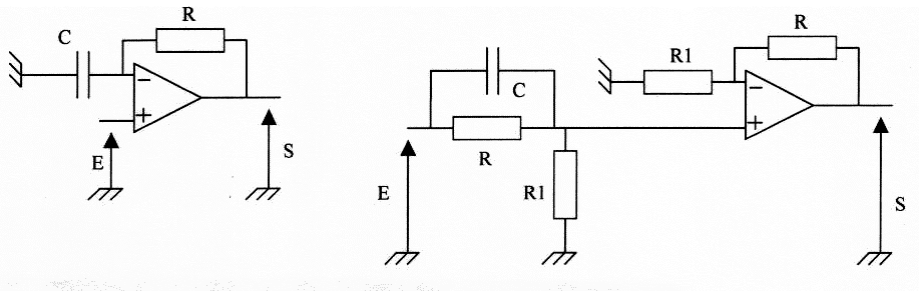
[picture p72: figure]

# C( p) = K 1( +τp)

p
R R

## RR C

## RCp C p

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
Figure 1.13 Circuit électrique du correcteur proportionnel et dérivée.

D’une manière générale, on utilise le correcteur à avance de phase qui a un effet semblable au correcteur proportionnel et dérivée dans une importante bande de fréquences.
- Fonction de transfert du correcteur à avance de phase.

Tp

## aTp C p K

+

+
=
1

1
( ) | avec a > 1.
- Lieu de transfert du correcteur à avance de phase.

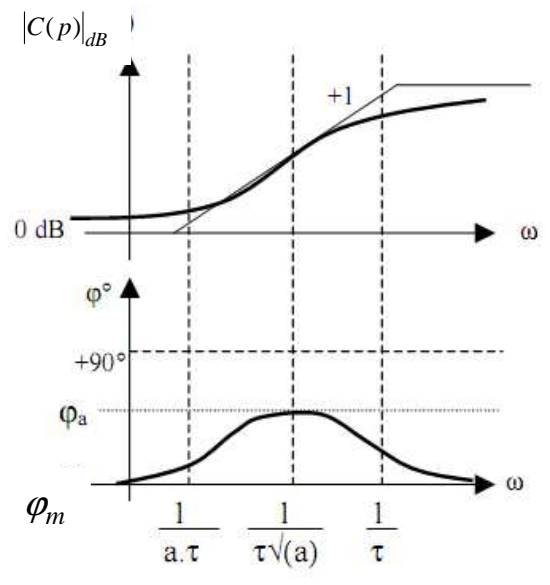
[picture p73: figure]

Figure 1.14 Lieu de transfert du correcteur à avance de phase (Bode).

Ce correcteur permet d’augmenter la rapidité du système et apporte une avance de phase qui

### est maximum à la pulsationωm :

T a

m

1
ω = | et | 1
| | 1

## sin

+

−
=
a

a
ϕ m

Ou :
a

a
m | arctgaT | arctgT | arctg
| | | 2
| | | 1
( )

−
ϕ ω = | ω − | ω ≈ | (lieu de Bode)

### On constate, pour un réglage avec ωR voisin de ω m et tel que

τ

ω
τ

1

1
p R p
a

### ; on a une

action stabilisante autour de la pulsation de résonnance qui permet d’accroitre alors le gain K du système.

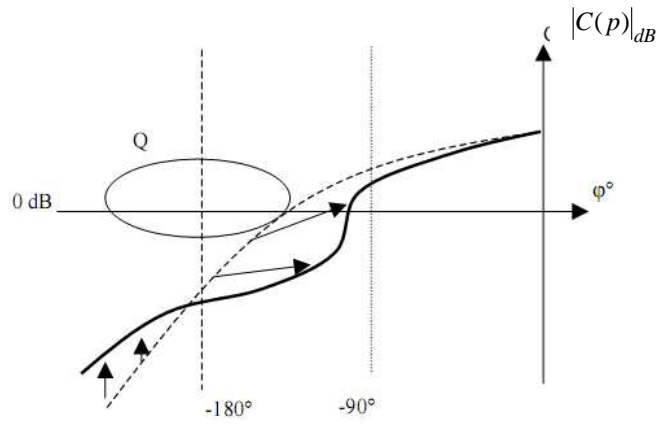
[picture p74: figure]

Figure 1.15 Effet du correcteur à avance de phase (lieu de Black).

### - Circuit électrique :

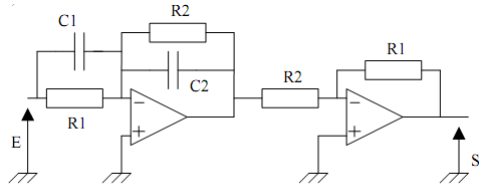
[picture p75: figure]

## R C P

## R C p

C p
1 | .
1 | .
( )
| 2 2

1 1
+

+
= | avec R2C2 p R1C1

Figure 1.16 Circuit électrique du correcteur à avance de phase.

### 5. Correcteur Proportionnel-Intégral et Dérivée :

### - Fonction de transfert du correcteur (Mixte):

- + | +
= | + | + | =
T P

## T p T T p T p K

T p

## C p K

I

i i d
d
i

2
1
)

1
( ) 1(

Ce correcteur est essentiellement théorique ; en pratique, on traite la partie action dérivée par un avance de phase. Le filtrage n’intervient alors que sur les hautes fréquences.

### Les racines du numérateur de C(p) sont réelles si :

) 0

4
4 . | 1(
2 | 2
∆ = − | = | − | =

i

d
i | i d | i
T

T
T | T T T
D’où la condition : | 4 i
d

T
T ≤

### C(p) s’écrit alors :

p

p p
C p
τ

1( τ )(1 τ )
( )

+ 1 + 2 =

= ± −

i

d
T

T

et réels | 4
1 | 1
2

;
1 | 2 | 2,1

τ
τ τ | τ
Avec 2 | 1
τ pτ | pτ = Ti

### Lieu de transfert du correcteur :

### PID mixte dérivée pure

### PID mixte dérivée filtrée

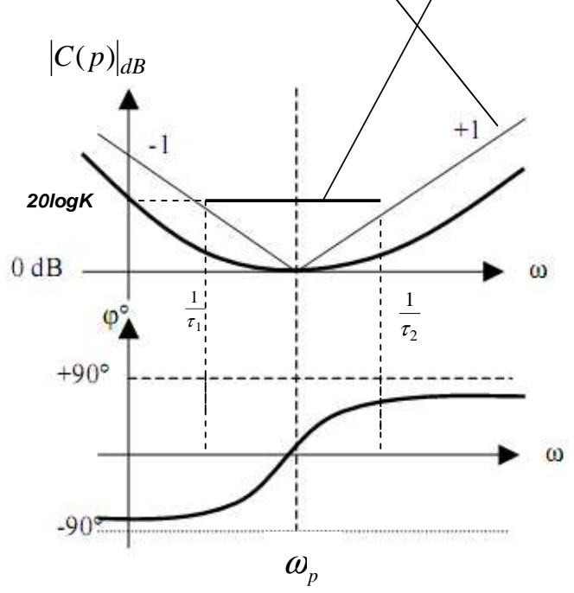
[picture p76: figure]
20logK

### Figure 1.17 Lieu de transfert du correcteur PID (Bode)

Pour | ( | ) | 0
2
: | ( | ) = | = | 1 | + | 2 | − =

π
ω ωp | ωp

# τ ωp

τ ωp Arg C j | arctg | arctg

Soit encore : | 1 | 2
2
1 2
1 | 2 | π

# τ τ ω

# τ ω τ ω

=
−

+

p

p | p

## arctg

Condition réalisée si : 1 | 0

2
−τ 1
τ 2ω p = d’où | etC j | K
TT

P
i d
p = | ( | ) | =

1
ω | ω | .

Ce point particulier du lieu de transfert est appelé point de pivot, les actions intégrales et dérivées non aucune influence.

### - Action du correcteur:

L’action de ce correcteur se fait sur toutes les fréquences. Son effet est stabilisant, il annule l’erreur statique, il contribue à augmenter la rapidité.

### - Synthèse du PID dans le plan de Black :

Conditions de réglage satisfaisant : | R

d

R
i | T

et
T
p ω | p ω
1 | 1

### On constate, dans le lieu de Black, l’augmentation de la précision statique due à

l’intégration ; de plus, l’avance de phase permet d’accroitre le gain K et par conséquent, la pulsation de résonance et la pulsation de coupure.

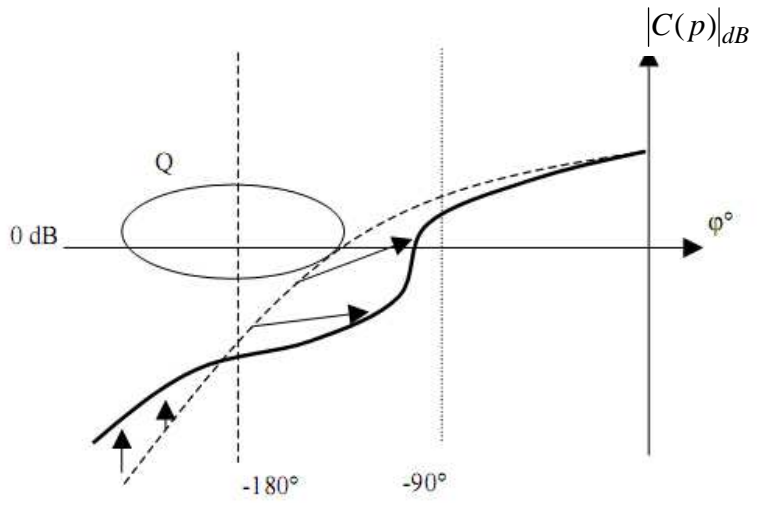
[picture p77: figure]

Figure 1.18 Effet du correcteur PID (lieu de Black).

### - Circuit électrique :

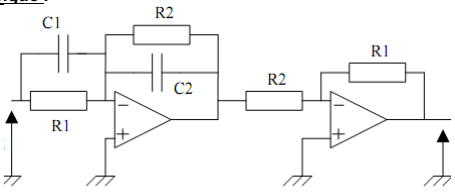
[picture p78: figure]

Figure 1.19 Circuit électrique du PID.

### 6. Correcteur avance et retard de phase :

### Ce réseau est plus proche des réalisations physiques des PID. Sa fonction de transfert

s’écrit : | ; | 1
1 .
1 1 | .
( ) | a f
| p

a p
T p

## C p K

i

+

+
= +
τ

τ

### En basses fréquences, ce correcteur à action de type proportionnelle et intégrale

permettant ainsi d’avoir une bonne précision statique.

### En hautes fréquences, le comportement se rapproche de celui du système à avance de

phase combinant ainsi les intérêts des deux autres types de régulation.

Chapitre 2 : | Les modèles d’état.

La notion de systèmes dynamiques montre que la modélisation la plus riche est celle qui utilise la notion d’état puisqu’elle représente un ensemble de variables a priori plus grand que celui constitué par les entrées et sorties. Cette représentation d’état est un outil puissant permettant de modéliser le fonctionnement de systèmes linéaires ou non, en temps continu ou en temps discret et qui possède en outre l’avantage de conserver la représentation temporelle des phénomènes et se prête bien au développement des programmes de calculateurs qui permettent l’analyse ou la synthèse des systèmes dynamiques.
Les variables d’état représentent à chaque instant, l’ensemble minimal d’informations nécessaires pour déterminer l’évolution ultérieure d’un système ; est se fait essentiellement dans le domaine temporel.
- Etat d’un système et variable d’état.

Considérons le système représenté sur la figure 2.1.Ce système est composé d’une cascade d’éléments différents et la commande automatique d’un tel système peut très bien aller beaucoup plus loin que la seule ambition de réguler le signal de sortie.
Un certain nombre de signaux, que l’on peut qualifiés d’internes au système apparaissent
nettement sur le schéma notés | , ,
1 | 2

## x x et 3

x .

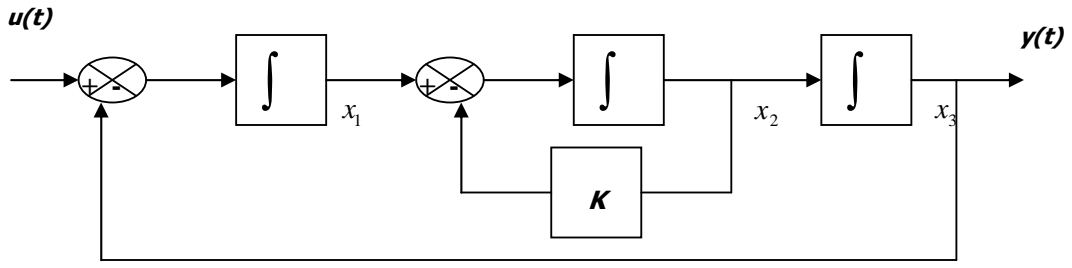
[picture p79: figure]

Figure 2.1 Exemple de représentation d’état d’un système continu.

Ces variables internes choisies sont appelées variables d’état du système. La commande du système ne se réduit donc pas au simple asservissement du signal de sortie mais peut donc être considéré
comme la maîtrise simultanée de l’évolution des trois signaux | , ,
1 | 2

## x x et

3

x .On dit que l’ensemble

de ces trois signaux forme le vecteur d’état et la modélisation va permettre d’envisager la commande de cet état grâce au signal d’entrée.
A partir de la figure 2.1, on calcule la dérivée de chaque variable d’état :
3 | 2
2 | 1 | 2
1 | 3
x | x
x | x Kx

## x u y u x

=

= −

= − = −

&

&

&
⇒ | . ( )
0

0

1

0 | 1 | 0
1 | | 0
0 | 0 | 1

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
Qui s’écrit : x& = Ax + Bu(t)

Comme | 3
y(t) = x , on écrit : | ( | )

=

3

2

1
( ) | 0 0 | .1
x

x

x
y t

On exprime donc l’évolution du système, modélisée par un vecteur constitué de dérivées premières des composantes du vecteur d’état, en fonction du vecteur d’état x du système.
Dans le cas général le système peut avoir plusieurs entrées et plusieurs sorties. Soit n le nombre de variables d’état, m le nombre d’entrées et p le nombre de sorties.
Dans ces conditions, l’équation d’état d’un système LTI sous forme canonique s’écrit :
( ) | ( ) | ( )
( ) | ( ) | ( )
y t | Cx t Du t
x t | Ax t Bu t
= | +
& | = | +
n | p | m

x∈ R , y ∈ R ,u ∈ R .

La première équation s’appelle l’équation de commande ; la seconde, équation d’observation. A (n x n) est la matrice d’état,
B (n x m) est la matrice d’entrée,
C (p x n) est la matrice de sortie,
D (p x m) est le transfert direct (ou couplage) entrée/sortie.
Le vecteur d’état x représente en pratique, la mémoire du système, et la connaissance des conditions initiales est nécessaire pour prévoir son évolution future.

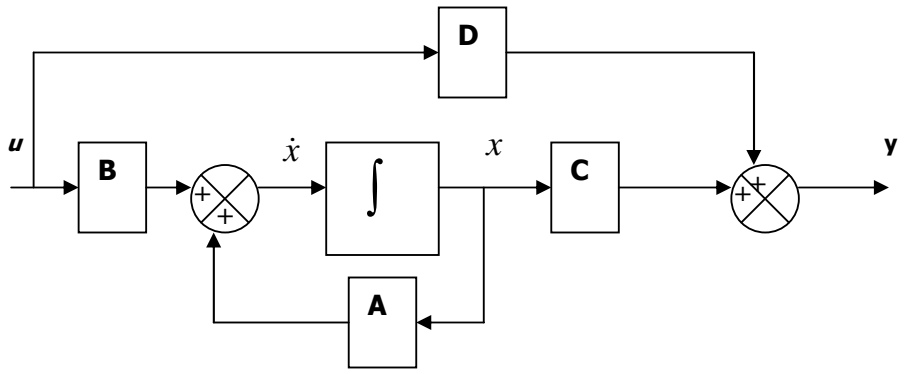
[picture p80: figure]

Figure 2.2 Schéma standard pour la forme canonique

Il est rare que la sortie soit directement liée à son entrée. On a donc très souvent D = 0.

- Gain statique :
Le point d’équilibre pour une entrée u(t) = u∞ est donnée par x&∞ = 0 ; soit :
= Ax∞ + Bu∞ 0 | & | .

Si la matrice A est inversible, c’est-à-dire s’in n’y a pas de valeurs propres nulles ou pas de pôles nuls dans la fonction de transfert, alors :

0

1

1

( ) =

−

∞ ∞

−
∞
= − | =
= − | =
K | CA B G p p
y | CA Bu | Ku

K est le gain statique.
- Gain dynamique :
Lorsque le système contient une ou plusieurs actions intégrales, ce n’est plus la sortie qui tend vers

une constante pour une entrée nulle mais sa dérivée ou sa dérivée

ième
n .Le rapport entre la valeur finale de cette dérivée et l’entrée est appelé le gain dynamique.
- Représentations équivalentes.

Les systèmes dont le fonctionnement est décrit par des équations différentielles ou des équations de récurrences linéaires à coefficients constants sont appelés systèmes LTI pour les systèmes Linéaires à Temps Invariant. Les matrices A, B, C et D sont donc des matrices à coefficients constants.
- Représentation classique :

Ce mode de représentation est déduit directement de l’équation différentielle (cas continu) ou de l’équation de récurrence (cas discret).
Exemple : système masse-ressort-amortisseur.
L’équation différentielle du second ordre s’écrit :
( ) | ( )
( ) | ( )

2

2

## kl t f t

dt

## dl t

b
dt

## d tl

m | + | + | =

m, b, k et l sont respectivement la masse, le coefficient d’amortissement, la constante de raideur du ressort et l’élongation.

Conditions initiales : | 0
| | ( )
)0( | 0 | v
| | dt

## dl t

l | = et | =

On écrit l’équation précédente sous forme différentielle du premier ordre :

1 | 2 | 0
2 | 1 | 2

2

2 | 2
1 | 1 | 2
)0( | 0 | )0(

( )

1
( ) ( )

( )
( )

( )
( )

( )

( )
( ) ( ) | ( ) | ( )
x | etx | v

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
## d tl

x t
dt

## dl t

x t

x t
dt

## dl t

x t | tl | y t | x t
= | =
= | → | = | = − | − | +
= | = | → | = | =

&

&

Un tel système se met alors sous la forme d’équation d’état dite classique :

( ) [ ] 1 0 ( )

1 ( )

0
( )

0 1
( )
y t | x t

u t
m

x t
m

b
m

## x t k

=

+

− | −
& | =

u(t) = f(t) et D = 0

### - Représentation modale :

Ce mode de représentation permet d’avoir la matrice d’état ou matrice d’évolution A sous forme de matrice de Jordan (cas des pôles multiples) ou diagonale (cas des pôles simples).
Exemple : Cas des pôles simples :
Pour la transmittance :

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
= | =
U p | p | p | p | p

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
Y p | ;

On pose :

( ) | ( ) | ( )
( ) | 2 ( ) | ( )
2

( )
( )
( ) | ( ) | ( )
1

( )
( )
1 | 2
2 | 2 | 2
1 | 1 | 1
ety t | x t x t
x t | x t u t
p

U p
X p

## x t x t u t

p

U p
X p
= | −
→ | = − | +
+

=

→ | = − | +
+

=

&

&

D’où l’écriture modale :

( ) [ | ] 1 | 1 ( )

( )
1

1
( )
0 2

1 0
( )
y t | x t
x t | x t | u t
= | −
+
−

−
& =

Les variables x sont des variables canoniques puisque A est diagonale. Les pôles αi simples

déterminent les modes

t
i e

α
du système.

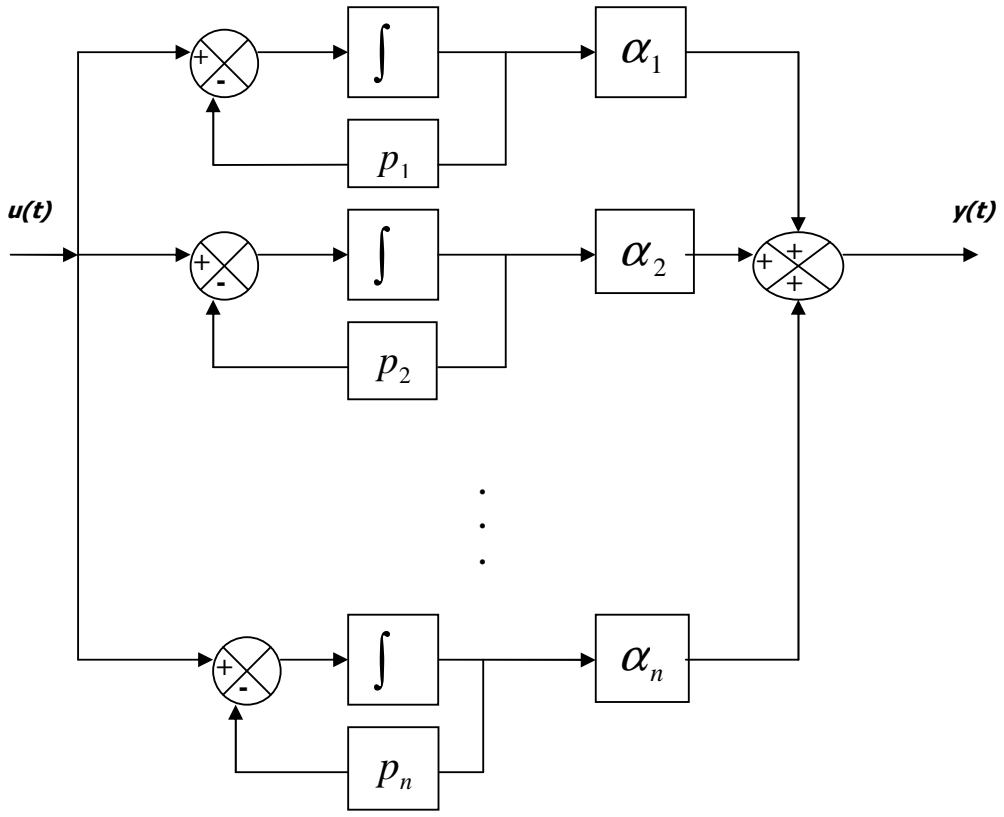
[picture p81: figure]

Figure 2.3 Représentation d’état du système continu sous forme modale.

Dans le cas d’un système du second ordre :

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
# ωn ωn

ξ
+ +

=

Les pôles complexes conjugués sont non décomposables ; on utilise alors la représentation d’état suivante :

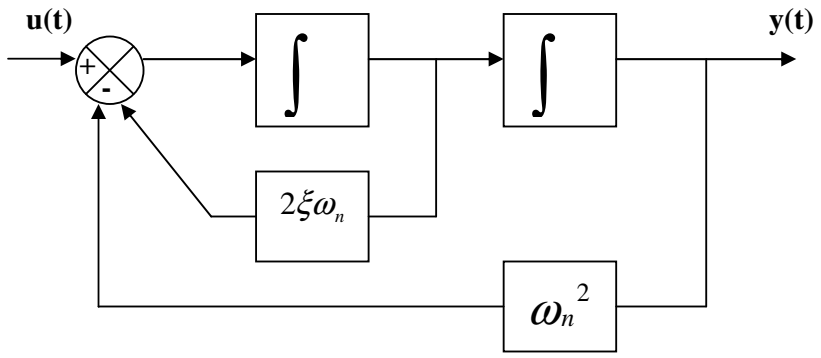
[picture p82: figure]
2ξωn

Figure 2.4 Représentation d’état d’un bloc du second ordre non décomposable.

- Représentation compagne commandable.

La fonction de transfert n’est factorisée, et s’écrit :

1 | 0

1
1

1 0

1
1

... ( )
a p a p | a p a
b p | b p | b p b
G p | n
| n

n
n

m
m

m
m
+ | + + | +
+ | + + | +
= | −

−

−
−
, avec n ≥ m.
Pour | =1 n a | (on divise le numérateur et le dénominateur par
n a ), divisons le numérateur et le

dénominateur par n, on obtient :

( )

( )
1 | ...

... ( )

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

m n
m | =
+ | + + | +
+ | + + | +
= | − | − + | −

−

− − | − + | −
−

−

On peut alors écrire :
. ( ) ( ) ( )
( )

( )
( ) | N p | R p N p
D p

U p
Y p = | =
n | n
n
a p | a p | a p

U p
R p | − | − + | −
+ − | + + | +

=

0

1
1

1
1
1 | ...

( )
( )

Soit :
( [1) | ... | ] ( ) 0
1
1
1 R p | a 1 p | a p | a p | U p
n | n
+ n | + + | + | =
− | − + | −
−

( )

1 | 1

1
( ) | ( ) | 0

1
1 | 1 | R p
p

a
p

a
p
R p | E p | a
n | n
| | n

+
+ +
= −

−

−

Si on pose :
,

( )
,..., ( )

( )
, ( )

( )
( ) n | n 1 | 2 | 1 | n
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
X p = | − | = | =
On obtient : | ( ) | ( ) [ | ( ) ... | ( ) | ( )] 1 | 1 | 2 | 0 | 1 R p | E p | a X p | a X p a X p = | − n− | n | + + | +

On peut alors choisir les
i

x comme composantes du vecteur d’état, d’où la représentation d’état :

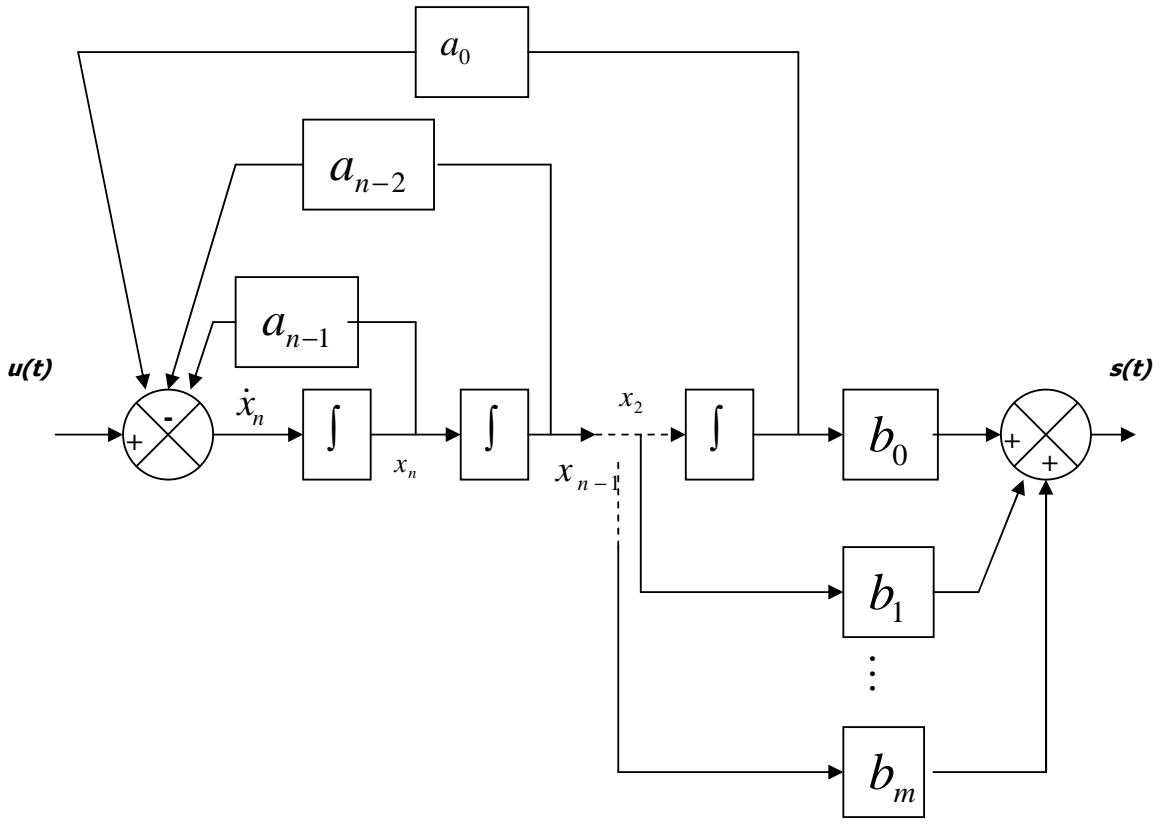
[picture p83: figure]

Figure 2.5 Représentation d’état compagne commandable.

Le signal de sortie s’écrit alors :
( ) [ | ... | ] ( ) 0
1
1

1
Y p | b p | b 1 p | b p | b p R p
m n | n | n
| | m

m n
m
− − | − + | −
−

−
= | + | + + | +

D’où :
( ) | ( ) | ( ) ... | ( ) | ( ) Y p = bm X m+1 p + bm−1X m p + + b1X2 p + b0X1 p .

Les équations d’état se déduisent naturellement de cette représentation :

0 1 | 1 2 | 1
0 1 | 1 2

1

2 | 3
1 | 2
( ) | ...
... | ( )

+

−

= | + | + +
= − | − | − − | +

=

=

=

m m

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

x x

&

&

M

&

&

D’où :

( ) [ | ] ... | 0 ... 0 ( )

( )

1

0

0

0

( )

0 | 0 | ... 0 | 1
| | | 0
0 | 1 | 0
0 | 1 | 0 ... | 0

( )

0

0 | 1 | 1
y t | b | b | x t
x t | u t
a | a | a

x t

m

n
=

+

− | − | −

=

−

M | M | O O | M

M O

&

Cette forme de représentation est appelée forme compagne commandable car la matrice de commande du système contient, en une seule ligne, l’ensemble des coefficients du dénominateur de la fonction de transfert. Elle est dite commandable, bien que seule la variable
n

x soit directement

affectée par le signal d’entrée, toutes les variables d’état s’en trouvent influencées par intégrations successives.
Si un système est commandable, alors on peut le mettre sous forme compagne commandable.
- Représentation compagne observable.
La forme de G(p) déjà transformée s’écrit :

( )

( )
1 | ...

... ( )

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

m n
m | =
+ | + + | +
+ | + + | +
= | − | − + | −

−

− − | − + | −
−

−

On peut ensuite écrire :
( ) | [ | ... | ] ( ) [ | ... | ] ( ) 0
1
1

1
0 | 1

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

m n
m

n
n
− − | − + | −
−
− | − | −
= − − | + + | + | + | + + | +

D’où :

| | | | | ( )

1

1
( )
1 | 1

1
( ) | 0 | 0
| 1
1 | 1 | U p p

b
p

## S p b

p

a
p

a
p
S p | a
n m | n

m

n | n

n

+ +
+

+
+ +
=
− | −

−

Et la représentation d’état suivante :

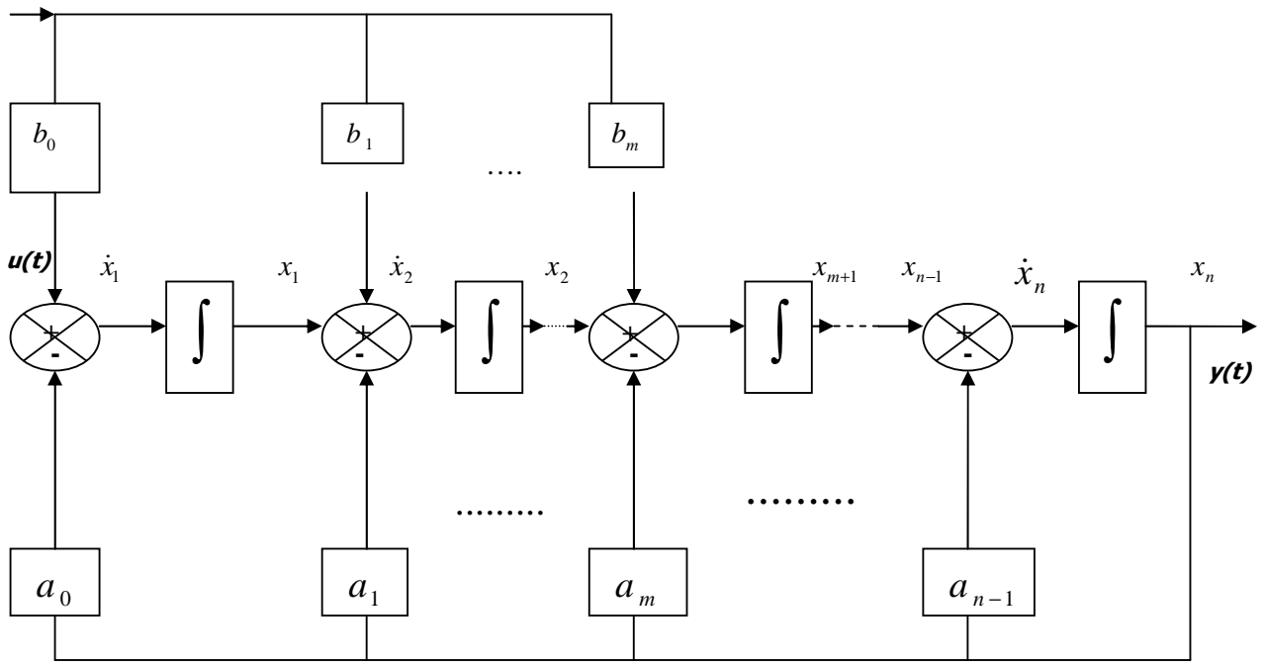
[picture p84: figure]

Figure 2.6 Représentation d’état compagne observable.

Les équations se déduisent directement de cette représentation :

n

n | n | n | n
m | m | m n | m
| | n

n

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

=

= | −
= − | +
= − | +
= − | +
− | −

−

( )

( )

( )

( )

1 | 1

1

2 | 1 | 1 | 1
1 | 0 | 0

&

M

&

&

&

D’où :

( ) [ | ] 0 ... 0 1 ( )

( )

0

0

( )

0 ... 0 0 1

0 ... 0 1 0

0 1 0 ... 0

1 0 ... ... 0

0 | 0

( )

0

1

0

y t | x t

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
M | O O O O | M M
&

u(t)

Cette représentation est appelée forme compagne observable car, outre le fait que la matrice de commande du système contient ,en une seule colonne, l’ensemble des coefficients du dénominateur de la fonction de transfert, on remarque que la sortie de ce système est égale à n

x qui ,par

intégrations successives ,est bien influencée par toutes les variables d’état. Si un système est complètement observable, alors on peut le mettre sous forme compagne observable.

- Résolution des équations d’état. Matrice de transition d’état.

Résoudre les équations d’état consiste à déterminer l’expression du vecteur d’état x(t) en fonction du temps.
La solution générale de l’équation : x& = Ax + Bu est donnée par la théorie des équations
différentielles : | ∫
− | −
= | + | τ τ

τ
x t | e | x t | e | Bu d
A t t | A t
( ) | | ( ) | | ( )
( | )
| | 0
( | ) 0

Cette expression est la somme de la solution de l’équation correspondant au régime libre(ou
autonome), soit | ( )
0
( | ) 0 e | x t

A t−t
et de la solution correspondant au régime forcé(ou commandé).

L’opérateur

A(t)
e est appelé matrice de transition d’état, notéeφ(t), elle décrit la transition en

régime libre de ( )0

x t à x(t).

!
2!

( )

2 2
= | = + + | + + | +
n
A t | A t
t | e | I At

n n
At φ | ; I représente la matrice carrée identité de

dimension n.

La sortie est donnée par : y(t) = Cx(t) + Du(t).

Calcul de la matrice de transition :

- Utilisation de la transformée de Laplace.

Passage aux transformée de Laplace de x& = Ax + Bu → pX ( p) − X )0( = AX ( p) + BU( p)

## Soit : ( pI − A)X ( p) = x )0( + BU( p)

D’où : | ( ) ( | ) | )0( | ( | ) | ( )
1 | 1 X p | pI A x | pI A BU p
− | −
= | − | + | −

Il en résulte

1
( ) ( )

−
φ p = pI − A ; la transformée de Laplace inverse donneφ(t).
- Méthode de diagonalisation.
Diagonalisation de la matrice d’état A :

=
n | n | nn n

n

a | a | a
a | a | a
a | a | a

A

1 | 2
21 | 22 | 2
11 | 12 | 1
Les vecteurs propres et les valeurs propres de cette matrice sont définis par : | ( ) | ( ) i | i | i A v = λ v

Les vecteurs non nuls ( )
i

v sont les vecteurs propres de A ; les λ i sont ses valeurs propres qui sont les racines de l’équation caractéristique de la matrice A définie par :
det(λI − A) = 0 .

Si on appelle ∆ la matrice diagonale formée des valeurs propres de la matrice A et M la matrice

modale formée des vecteurs propres, on a :

∆ =
λn

λ

λ

0 ... 0

0 0 ... 0

0 0 ... 0 ... 0

2

1
et | [( ) ( ) ... ( )] 1 | 2 | n M = v | v | v

Dans ces conditions :

# −1 A = M∆M

Par conséquent :

1
0 | ... 0
0 | ... ... 0
0 | 0 ... 0 ... 0

2

1

−

= | M

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
- Equation d’état et fonction de transfert.

Le système étant décrit par :

## y Cx

## x Ax Bu

=

& = +

D = 0

Passage aux transformée de Laplace :
( ) | ( )
( ) | ( ) | ( )
Y p | CX p
pX p | Ax p Bu p
=
= | +
( ) ( | ) | ( )
1

## X p pI A BU p

−
= | − | .Conditions initiales nulles.
D’où la fonction de transfert : | C( | ) pI A B
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
= | = | −
Si y = C x(t) + D u(t) ; alors : | C( | ) pI A B D
U p

Y p
G p = | = | − | +

−1
( )

( )
( )
- Commandabilité d’un système.

Le concept de commandabilité a été introduit par Kalman ; et son critère est le plus utilisé. Un système est commandable s’il est possible, quel que soit l’intervalle [ ] 1 2
t ,t et quelque soit l’état 2

x
, de déterminer un signal de commande u(t) sur [ ] 1 2 t ,t qui amène le système de n’importe quel

état
1 | 1
x(t ) = x vers l’état voulu | 2 | 2

x(t ) = x .

Critère de Kalman :
Un système est commandable si et seulement si la matrice de commandabilité, défini par :
C | [B AB A B | A B]
n
AB
2 | 1

−
= | est de rang n.

La paire A, B est complètement commandable si et seulement si, cette matrice de commandabilité est régulière, autrement dit si son déterminant n’est pas nul.
On parle aussi d’accessibilité ; un système est dit accessible, s’il est possible de déterminer un signal d’entrée u(t) sur l’intervalle [ ] 1 2
t ,t de manière à amener le système d’un état 1 1

## x(t ) = x vers

l’état
2 | 2

x(t ) = x .

- Observabilité d’un système.

Un système est dit observable à un instant 1

t , si la connaissance du signal d’entrée et du signal de sortie sur un intervalle de temps [ ] 1 2
t ,t permet de calculer l’état du système à l’instant
1

t .

Critère d’observabilité :
Le système :
( ) | ( ) | ( )
( ) | ( ) | ( )
y t | Cx t Du t
x t | Ax t Bu t
= | +
& | = | +

est observable si et seulement si la matrice d’observabilité définie par :

=

−1

2

# n CA

CA

CA

C

C

est de rang n.
La paire A, C est complètement observable si et seulement si, cette matrice d’observabilité est régulière, autrement dit si son déterminant n’est pas nul.
- Stabilité

En représentation d’état, pour analyser la stabilité d’un système linéaire invariant, deux solutions sont possibles.
- La première consiste à déterminer l’équation caractéristique dont l’expression est donnée par :
det( pI − A) = 0 , (Cas continu)

et puis, conclure sur la stabilité (Routh-Hurwitz, Jury).

- La seconde repose sur la méthode de Lyaponov et résulte du théorème suivant : Si deux matrices symétriques définies positives P et Q vérifient l’équation de Lyaponov

stationnaire : A P PA Q

T

+ = − , alors le système x&(t) = Ax(t) est asymptotiquement stable au

sens de Lyaponov. Inversement, si le système x&(t) = Ax(t) est asymptotiquement stable au sens

de Lyaponov, alors pour toute matriceQ symétrique et définie-positive, l’équation de Lyaponov a

une solution unique P symétrique-positive.

Méthode de test de la stabilité :

### 1. Prendre une matriceQ quelconque symétrique et définie-positive.(on prendQ = I pour

simplifier les calculs).

### 2. Résoudre l’équation de Lyaponov A P PA Q

T

+ = − , puis déduire P .

3. Tester si la matrice P obtenue est symétrique définie-positive et conclure sur la stabilité. Dans le cas discret l’équation de Lyaponov s’écrit : A PA P Q

T

− = −

Chapitre 3 Analyse et Synthèse des systèmes continus dans l’espace d’état.

- Stabilité
En représentation d’état, pour analyser la stabilité d’un système linéaire invariant, deux solutions sont possibles.
- La première consiste à déterminer l’équation caractéristique dont l’expression est donnée par :
det( pI − A) = 0 ,

et puis, conclure sur la stabilité (Routh-Hurwitz).

- La seconde repose sur la méthode de Lyaponov et résulte du théorème suivant :
Si deux matrices symétriques définies positives P et Q vérifient l’équation de Lyaponov

stationnaire : A P PA Q

T

+ = − , alors le système x&(t) = Ax(t) est asymptotiquement

stable au sens de Lyaponov. Inversement, si le système x&(t) = Ax(t) est

asymptotiquement stable au sens de Lyaponov, alors pour toute matriceQ symétrique et définie-positive, l’équation de Lyaponov a une solution unique P symétrique-positive.

Méthode de test de la stabilité :

### 1. Prendre une matriceQ quelconque symétrique et définie-positive.(on

prendQ = I pour simplifier les calculs).

### 2. Résoudre l’équation de Lyaponov A P PA Q

T

+ = − , puis déduire P .

### 3. Tester si la matrice P obtenue est symétrique définie-positive et conclure sur la

stabilité.

- Commande dans l’espace d’état.

Le système invariant est décrit par une représentation d’état linéaire à temps continu :

=

= ′

= | + | + ′
( ) | ( )
( ) | ( )
( ) | ( ) | ( ) | ( )

## z t Cx t

## y t C x t

x& t | Ax t | Bu t | B v t

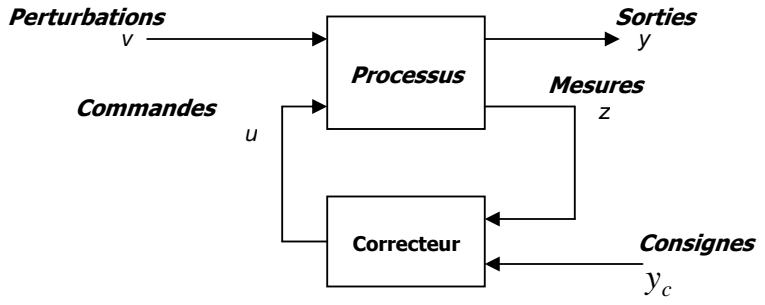
[picture p85: figure]
Processus; Correcteur; Perturbations; Sorties; Commandes; Mesures z; Consignes

Objectif : à partir des mesures z, le correcteur doit générer des commandes u qui permettent d’asservir les sorties y sur des signaux de consignes c

y , en rejetant le mieux

possible les perturbations v.
Les signaux z, y, v, u sont à priori des vecteurs (cas multi variable).
La synthèse de la commande s’effectue en trois étapes, qui sont relativement indépendantes :
- la synthèse par retour d’état

- la synthèse d’un observateur
- l’association du retour d’état et de l’observateur
- Commande par retour d’état

Le retour d’état est actuellement l’outil de base de l’automatique ; il fournit une procédure systématique et garantie permettant d’assurer au moins la stabilisation de n’importe quel système linéaire invariant.
En pratique, la commande par retour d’état suppose que toutes les variables d’état sont accessibles (mesurables).
Cas continu :

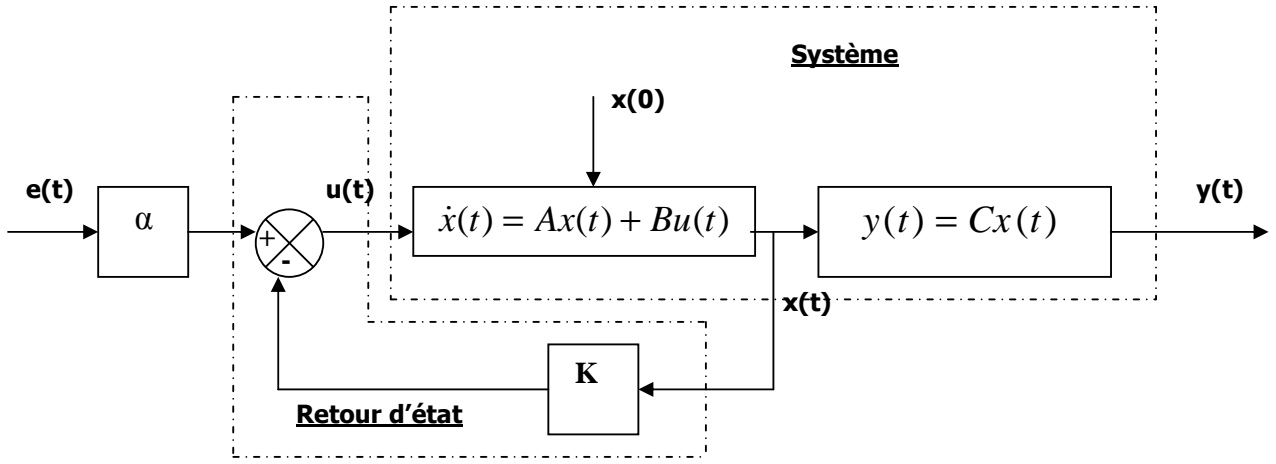
[picture p86: figure]
Système; Retour d’état

Structure de commande par retour d’état(formulation continue).

On utilise l’état x(t) du système pour construire le signal de commande u(t) par un bouclage de la forme :
( | )

= | − | = | −

n

n
x

x

x

u t | e t | Kx t | e t | k k | k
M

2

1

1 | 2
( ) α. ( ) | ( ) α. ( ) | ...

α est un gain de pré bouclage.

Le but de la conception cette commande par retour d’état consiste à déterminer le vecteur ligne K (vecteur de gain) de façon à satisfaire des spécifications qui reposent sur un placement des valeurs propres en boucle fermée (performances dynamiques) ou sur un placement de structure (fonction de transfert en boucle fermée ou équation d’état). On peut aussi obtenir ces gains matriciels de bouclage en utilisant les principes de
commande optimale.
Cette commande par retour d’état impose que le système (A, B) est commandable.

Fonction de transfert en boucle fermée (placement de structure) : Le système en boucle ouverte est régi par :

( ) | ( )
( ) | ( ) | ( )
y t | Cx t
x t | Ax t Bu t
=
& | = | +

On a alors :
x&(t) = Ax(t) + B(α e(. t) − Kx(t)),

Soit :
x&(t) = [A− BK]x(t) + Bα e(. t) ,

Passage aux transformées de Laplace :
( ) [ | ] | ( )
1
X p | pI A BK BαE p
| −
= | − + | ,

D’où la fonction de transfert en boucle fermée :
| C[ | ] pI A BK Bα
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
= | = | − + | .

Dans le cas d’un placement de pôles pour un système commandable, on identifie le dénominateur de la fonction de transfert en boucle fermée tenant compte du retour d’état avec le dénominateur de la fonction de transfert obtenue à partir du cahier de charges. Exemple :

Considérons le système défini par : |
− −

− −
=
1 | 3
2 | 2
A | et |
−

=
2

1
B .

Le système est commandable ; on souhaite placer ce système dans une boucle à retour
d’état avec un vecteur de gain | [ | ] 1 | 2 K = k k ,de manière à obtenir une marge de phase

égale à 60° et un temps de montée de 3s.
Ces performances correspondent à une fonction de transfert du second ordre caractérisée
par un facteur d’amortissement ζ = 0.6 et une pulsation propre | rd s n ω =1 / , autrement

dit possédant un dénominateur D(p) tel que :
1 | 2.1 | 1

2
( )

2
2

2
= | + | + = p + p +
p | p
D p
n ωn

ξ
ω

On identifie le dénominateur de la fonction de transfert en boucle fermée tenant compte du retour d’état à D(p) :
det[ | ] | 2.1 | 1
2

# pI − A+ BK = p + p +

Soit :

5( | 2 ) | 4( | ) | 2.1 | 1
( | 2 | )( | 3 2 ) 1( 2 )(2 | ) | 2.1 | 1
2.1 | 1
| 1 2 | | 3 2
| 2 | | 2

2
1 | 2 | 1

2

2
1 | 2 | 2 | 1

2

2 | 2
1 | 1
+ + − | + + = + | +
+ + | + − | − − | + = + | +
| | = + | +
− | + −
+ + | +
p | k | k p | k | p | p
p | k p | k | k | k | p | p
p | p
k | p | k
p | k | k

D’où :

=

= −
⇒

+ − =

+ =
4.0

3
5 | 2 | 2.1
4 | 1

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
Le vecteur de gain qui assure au système les performances voulues en boucle fermée est donc :
K = [−3 4.0 ].

Points sur la commande par retour d’état :

- La commande par retour d’état nécessite la connaissance du vecteur d’état (accessibilité à la mesure),
- Dans le cas contraire, on fait appel à un observateur d’état, c’est un système dédié dont la fonction consiste à reconstruire le vecteur d’état à partir des mesures accessibles sur les entrées et les sorties du système (deux cas sont a considérés : système non bruité et système présentant des bruits sur les mesures ou sur les commandes),
- Le retour d’état peut avoir également comme objectif de découpler l’effet des entrées sur les sorties (cas des systèmes multivariables).Les méthodes de découplage conduisent souvent à des retours d’état dynamiques, par opposition à ceux envisagés ici, dits retour d’état statique.
- Observateurs et estimateurs d’état

Lorsque toutes les variables d’état ne sont pas mesurables mais le système est complètement observable ; il est alors possible de reconstruire le vecteur d’état à un instant donné à partir de la connaissance du signal de sortie et du signal d’entrée du système sur un intervalle de temps précédent ; on utilise pour ce faire un observateur d’état. Si le système n’est pas complètement observable, il est nécessaire d’estimer le vecteur d’état au moyen d’un estimateur d’état.

L’idée est de fabriquer une simulation du système et d’y ajouter une entrée supplémentaire fonction de l’écart entre la sortie (mesurée) du système et la sortie (calculée) de la simulation de manière à assurer la convergence de l’état estimé vers l’état réel du système.
Cas continu :
On considère le système dont le modèle d’état est donné par :
( ) | ( )
( ) | ( ) | ( )
y t | Cx t
x t | Ax t Bu t
=
& | = | +

,

On note par xˆ(t)l’estimé de x(t) à l’instant t ;

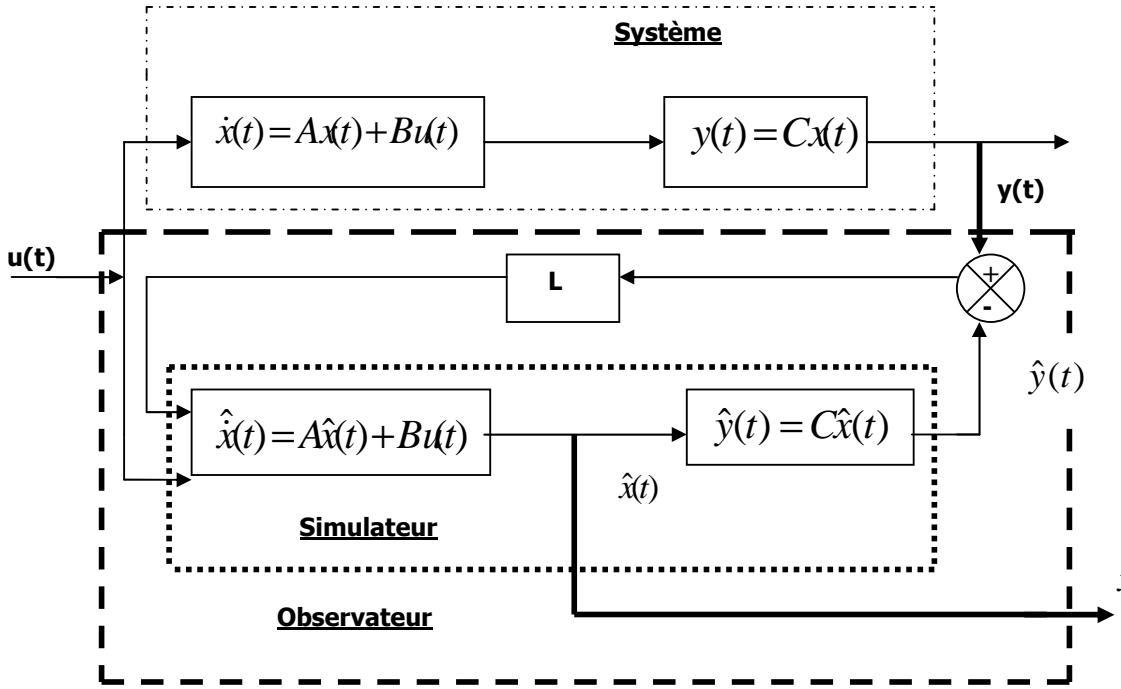
[picture p87: figure]
& tx )( =Axt)( +But)(; ˆ& tx = txA +But; yˆ t)( =Cxˆ t)(; Système; Observateur; Simulateur

Observateur (formulation continue).

Mise en équations :
On définit l’erreur d’estimation ε(t) par :
ε (t) = x(t) − xˆ(t) ;

Lorsque x(t) = xˆ(t), on peut admettre que les états sont les mêmes et l’état

xˆ(t) reconstruit, représente le vecteur d’état x(t) inconnu.

L’objectif consiste donc à faire converger ce vecteur vers un vecteur constant le plus faible possible (idéalement vers 0) et, ce le plus rapidement possible.
La structure de l’observateur est de la forme :
[ | ]
ˆ( ) | ˆ( )
( ) | ˆ( ) | ( ) | ( ) ˆ( )

ˆ
y t | Cx t
x t | Ax t | Bu t | L y t | y t
=
& | = | + | + | −

,

où apparait le terme correctif en fonction de l’erreur de reconstruction de la sortie, y(t) − yˆ(t) , et le gain de correction L, appelé gain de l’observateur est à déterminer.

Cette structure peut être écrite sous la forme :
( ) ( | )ˆ( ) | ( ) | ( )
ˆx& t = A − LC x t + Bu t + Ly t .

Si on considère l’erreur d’estimation :
ε (t) = x(t) − xˆ(t),

On obtient :
( ) ( )ˆ( )
ˆε& t = A − LC ε t ,

# xˆ(t)

Ce qui conduit à l’évolution de l’erreur d’estimation à partir de la condition
initiale ε )0( = x )0( − xˆ )0( , qui est non nulle de façon générale parce que l’état est à

priori inaccessible :
[ | ]
( ) | ).0(
ˆ | ( | .)
ε | ε

### A LC t

t e

−
& =

Pour que l’observateur soit utilisable il est nécessaire que cette erreur tende vers 0 lorsque t augmente. Lorsque cette propriété est satisfaite l’observateur est dit asymptotique, mais il est évident que c’est une propriété nécessaire au fonctionnement correct de l’observateur .En conséquences il faudra choisir L telle que les valeurs propres de la matrice (A - LC) soient toutes à parties réelles strictement négatives.
En pratique on choisit une dynamique d’erreur plus rapide que celle du processus.

Utilisation de l’observateur en boucle fermée pour la commande par retour d’état (régulateur-observateur):

La loi de commande s’écrit alors :
u(t) =αe(t) − Kx(t), et D ≠ 0 .

Comme l’état n’est pas accessible, la commande réellement mis en œuvre devient :
u(t) =αe(t) − Kxˆ(t),

Equations d’état en boucle fermée :

( )
ˆ( ) 0

( )
( ) 0

ˆ

( )
e t

B
x t

x t

## A LC

## A BK BK

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
[ | ] | ( )
ˆ( )

( )
( ) | D e t
x t

x t
y t | C DK DK |

+ α
= −

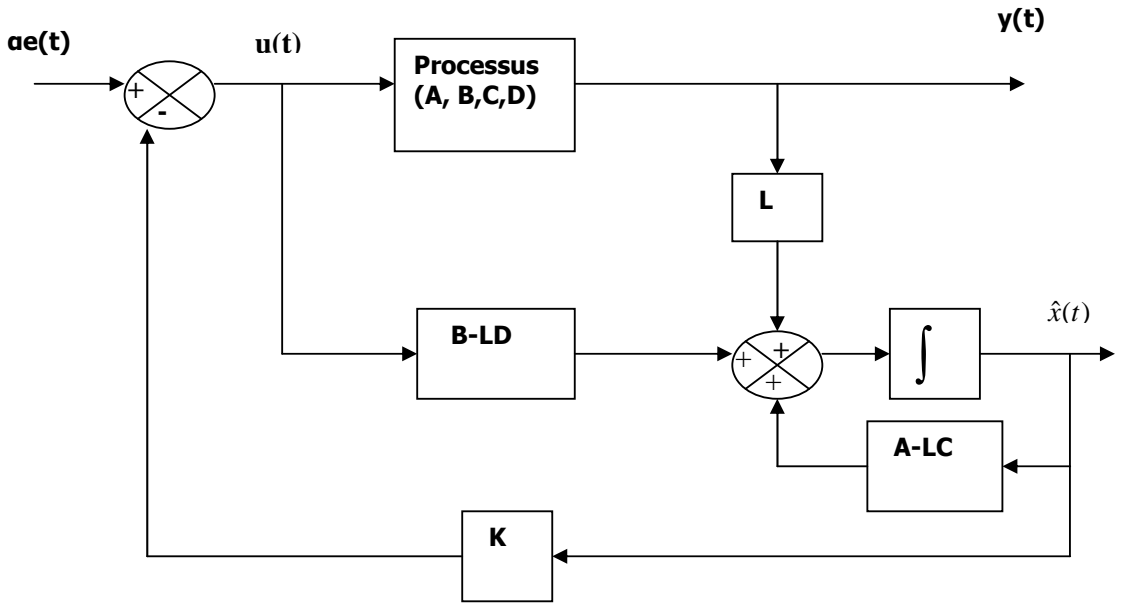
[picture p88: figure]
Processus (A, B,C,D)

Commande par régulateur-observateur (formulation continue).

Les dynamiques du système commandé par un régulateur-observateur en boucle fermée c'est-à-dire les valeurs propres de la matrice :

−

−

## A LC

## A BK BK

0

Sont construites de la réunion de celles désirées en boucle fermée et celles de l’observateur. Ainsi on peut régler de façon indépendante le problème de la régulation et le problème de régulation c’est le principe de séparation.

* Fonction de transfert en boucle fermée :
[ | ] |
− +
− + | −
= | + −

−
0 | 0
( ) | .

1
α
α

B

## pI A LC

pI A BK | BK
F p | D | C DK DK

* Détermination du gain de l’observateur :
Il s’agit de déterminer L soit directement, soit par la formule de Bass et Gura qui permet la construction d’un algorithme.

Le gain de l’observateur est fixé d’après le choix des valeurs propres de la matrice A-LC :
det( | ) det( | )
T | T T
pI − A+ LC = | pI − A +C L ,

On note :
∑
| − =
= | − = +

1

0

## ( ) det( )

n

i

i
i

n

a p | pI A | p | a p et aˆ( p)le polynôme représentant les

dynamiques désirées pour l’observateur :
ˆ( ) | ( | ) | ˆ ,
| | | 1
1 | 0
∏ | ∑ −
= | =
= | − = +

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
a p | p λ p | a p

Où les λi
sont les valeurs propres désirées pour A-LC. Cas mono sortie (L = 1).

Calcul direct :
∑

−

=

− + = +

1

0

1

det( | ) | ( ,..., ) ,

n

i

| | i
i | n

n
pI A LC | p | f l | l p
Où les | ( ,..., )
i 1 | n
f l | l sont n formes linéaires en les inconnues | n

l ,...,l
1

, c’est à dire que l’on
peut écrire, pour i = 0,…, n-1, | ( ,..., ) | . f
i

l
1

l

n = FiL Les n égalités :
0,..., | ,1 ( ,..., ) ˆ ,
i 1 | n | i
i = | n − f l | l = a
Conduisent à : FL = aˆ,

Où :

| | ,

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
On obtient donc le gain par :

## L F aˆ

−1
= .

Remarques sur les observateurs :

Quel que soit le type d’observateur choisi, le principe de séparation énoncé dans le cas continu, reste valable : commande par retour d’état et observateur peuvent être déterminés séparément.
Comme dans le cas continu, deux approches existent pour le choix du gain du reconstructeur d’état, l’une basée sur la notion de placement de pôles, l’autre basée sur la minimisation d’un critère quadratique associé.
Dans le cas des systèmes discrets, il existe un choix particulièrement intéressant, qui consiste à déterminer L tel que la matrice A− LC soit nilpotente, c’est-à-dire que toutes ses valeurs propres soient nulles. En effet, dans ce cas on obtient un observateur à réponse pile où l’erreur est exactement nulle au bout de max{ν i}pas où les ν i
sont les
indices d’observabilité.
Notons la différence avec un observateur asymptotique où l’erreur tend vers 0.
- Exemple de synthèse de régulateur.
- Commande linéaire quadratique à temps continu:

On parle de commande linéaire quadratique : LQ ou LQR (pour Linear Quadratic Regulator).
Le système est linéaire et la commande est quadratique.
La commande optimale est un retour d’état.

On considère un système linéaire :

0

)0(

( ) | ( )
( ) | ( ) | ( )
x | x
y t | Cx t
x t | Ax t Bu t

=

=

& | = | +

où les matrices A, B sont respectivement de dimension (n x m) et (n x m),
n | m

## x∈ R ,u ∈ R

et le critère quadratique à horizon fini :
( | ) ∫
= | +

T
T | T
J | x Qx u Ru dt

0

2

1

où
R est une matrice symétrique définie positive de dimension (m x m),

q

T Q = Cq C est une matrice symétrique semi-définie positive de dimension (n x m).

Les matrices Q et R ont un rôle de pondération sur l’état et la commande.
L’objectif est la détermination de la commande par retour d’état u(t) (qui assure la stabilité du système tout en modérant la dépense d’énergie), en minimisant le critère de performance J .

La méthode :
Par application directe du principe du minimum, l’Hamiltonien s’écrit :
H | x u | ( | ) Ax Bu | (x Qx u Ru)
T | T | T
= | + | + | +
2

1
(λ, , ) λ

et le système Hamiltonien comme :

1 0 =

= − −
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
λ | λ

λ

# avec

# A Qx

x

H

# Ax Bu H

x

T &

&

La condition de minimum H par rapport à la commande u s’exprime par :
λ
T

# u R B

u

H | 1
0
| −
= ⇔ = −
∂

∂

Le système hamiltonien devient linéaire :

## A Qx

x

H

## Ax BR B

H
x

T

T

= − −
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
λ | λ

λ
λ

&

&

1

avec les conditions initiales et finales : | )0( | ( ) 0 x | = x0

etλ T = (conditions de

transversalité).
La solution est unique (système linéaire).
λ s’écrit sous la forme : λ(t) = P(t)x(t) avec P(t) une matrice symétrique, alors :

## Px Px& λ

& = & +

A l’aide du système hamiltonien, on parvient à :
A Px Qx x PAx PBR B Px T | −1 T
− | − = + | −

Et comme la relation est vraie∀x , on obtient l’équation de Riccati différentielle :

# P A P PA PBR B P Q

T | T
− = | + | − | +

−1 &

la condition de transversalité à l’instant final donne P(T) = 0 .

alors :
- si le couple (A,B) est stabilisable,
- et le couple (C A) q
| | | , est détectable,

la résolution de cette équation fournit alors la commande par retour d’état :
( ) | ( ) | ( ) ( ). ¹
u t | Kx t | R B P t x t
− | T
= − | | = −

où P(t) est une matrice solution de l’équation de Riccati différentielle.

Choix des pondérations :

Q et R représentent des poids sur les états et la commande respectivement. Ils sont les paramètres les plus importants dans le problème LQR et leur détermination n’est pas évidente, d’où la nécessité d’un grand nombre d’itération pour aboutir à un système stable avec une bonne précision.

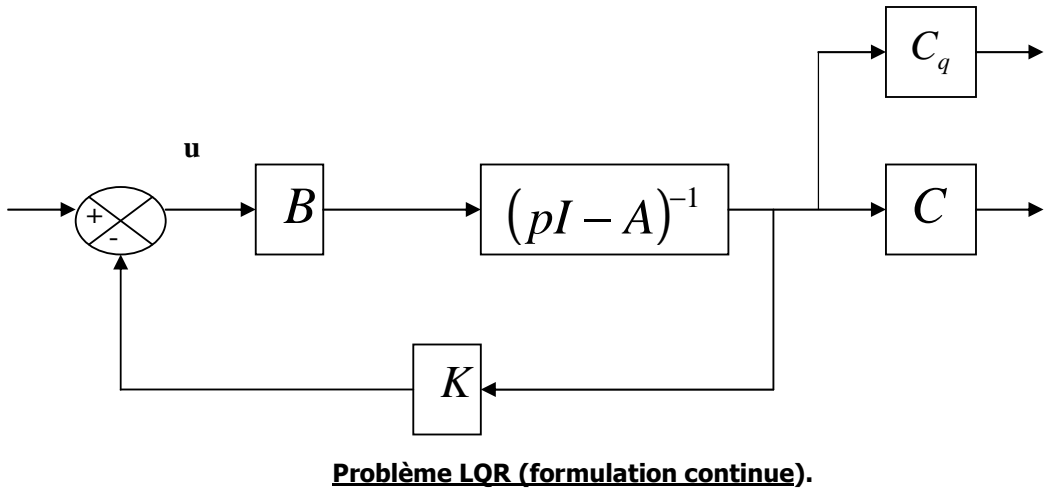
[picture p89: figure]
Problème LQR (formulation continue).

z :sortie
commandée

y :sortie
mesurée

Chapitre 2. | Synthèse par placement de pôles. Structure RST.

### Ces correcteurs permettent de réaliser un asservissement d’un processus possédant des

zéros instables. La structure est plus complexe, néanmoins ces régulateurs sont plus souples. Le calcul de ces correcteurs peut se faire automatiquement par un logiciel.

### Le régulateur RST est fondé sur une décomposition suivant trois polynômes conduisant à la structure de commande :

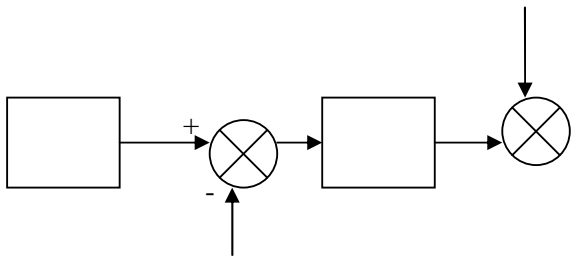
[picture p90: figure]

Structure de commande RST.

La synthèse du correcteur consiste à découpler les comportements dynamiques vis-à-vis de la consigne et des perturbations éventuelles. Elle s’effectue ici par approche de type placement de pôles ; les critères ont pour objectif d’obtenir des fonctions de transfert en boucle fermée (suivant le modèle) permettant de satisfaire un cahier de charges vis-à-vis de la consigne et des perturbations.

### Le modèle à atteindre :

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
D’après la structure RST de ce régulateur, la fonction de transfert en boucle fermée vérifie :

( ) ( ) ( ) ( )

( ) ( )
( )

## A p R p B p S p

## T p B p

F p
+

=

### Calculer le régulateur c’est établir les polynômes R( p), S( p),T( p) en fonction des polynômes A( p), B( p), A ( p) m

## et B ( p) m

### La loi de commande est issue de la structure de l’asservissement :

R( p)U ( p) T( p)Y ( p) S( p)Y( p) = | c | −

( )

( )
( )
A p

B p
G p = | ; Le numérateur B( p) donne les zéros du processus.

### B( p) contient les zéros stables et instables. Ce polynôme peut donc se scinder en deux parties :

1 0

1
1 B ( p) b p | b p | ... b p b

m
m

m

S | = m | + | + + | +

−
−

### Et l’autre contenant les zéros instables :

( ) | ( | )( | )... Bi p = K p − p0 p − p1

### On peut ainsi inclure dans cette dernière partie les zéros dont la norme est proche de 1

B( p) B ( p).B ( p) ⇒ | = i | S

Si on rapproche F( p) deG( p), il parait assez naturel de penser que F( p) ne pourra jamais compenser les retards intrinsèques àG( p) et qui sont manifestés par la différence des degrés des polynômes B( p) et A( p).Le modèle F( p) doit tenir compte de ce fait et on doit avoir :
deg ré(A ( p)) deg ré(B ( p)) deg ré(A( p)) deg ré(B( p)) m | − | m | ≥ | −

### Comme B ( p) i

### constitue une partie non compensée de B( p), on doit le retrouver dans B ( p) m

:

( ) ( ) ( )

' Bm p = Bi p Bm p .

### Le polynôme R( p)intervient au dénominateur dans la boucle de régulation. Son degré doit

être suffisant pour assurer la causalité du correcteur. Les polynômes S( p) etT( p) sont de degré au plus égal à celui de R( p).

### - R( p) compense les zéros compensables du processus, contenus dans B ( p) s

.Il

### assure en outre la présence des intégrations nécessaires pour assurer la précision. On a donc :

R( p) =

R′(z) est un polynôme dont le coefficient du terme de plus haut degré est 1.

### - Le polynômeT(z) assure le couplage du système à son entrée de commande, il fournit donc les zéros nécessaires pour obtenir le numérateur du modèle Bm(z) dont une partie est déjà fournie par la partie non compensable du processus. On choisit donc :

Le degré de ( ) 0A z n’est pas arbitraire. Il permet la synthèse de R(z) etT(z)On doit avoir :

### - Le polynôme S(z), tout comme R(z) , est solution d’une équation polynomiale dans laquelle on a remplacé les polynômes :

### Il vient :

### Après simplifications ) R′(z et S(z) doivent vérifier :

### Équation polynomiale (équation Diophantine) connue sous d’identité de Bézout admet une solution unique pour R′(z) et S(z), si leurs degrés sont convenables :

1 | 0

1
1 A( p) a p | a p | ... a p a

n
n

n

= n | + | + + | +

−
−

1 0

1
1 B( p) b p | b p | ... b p b

m
m

m

= m | + | + + | +

−
−
| | 1 | 0

1
1 R( p) r p | r p | ... r p r

n
n

n
nt
= | + | + + | +

−
−

1 0

1
1 S( p) s p | s p | ... s p s

n
n

n

= n | + | + + | +

−
−

1 0

1
1 T( p) t p | t p | ... t p t

n
n

n

= n | + | + + | +

−
−
