Kyklas/projet-plury-4eii-2012/Rapports/prix carte.xlsx

Composants | Prix /1000 | Prix /1 | Nombre | Total /1000 | Total /1
Résistances | 0.02 | 0.05 | 39 | 0.78 | 1.95
Condensateurs | 0.1 | 0.15 | 25 | 2.5 | 3.75
1N4148 | 0.015 | 0.064 | 4 | 0.06 | 0.256
REGU 7805 | 0.22 | 0.48 | 1 | 0.22 | 0.48
Quartz8Meg | 0.36 | 0.66 | 1 | 0.36 | 0.66
LED | 0.05 | 0.1 | 6 | 0.3 | 0.6
DB9 | 0.76 | 1.16 | 1 | 0.76 | 1.16
ALIMJACK | 0.58 | 0.85 | 1 | 0.58 | 0.85
FT232 | 3.01 | 3.78 | 1 | 3.01 | 3.78
JUMPER | 0.05 | 0.1 | 4 | 0.2 | 0.4
LM324 | 0.3 | 0.61 | 1 | 0.3 | 0.61
PIC24FV… | 2.54 | 3.91 | 1 | 2.54 | 3.91
Potentiomètre | 0.73 | 1.06 | 4 | 2.92 | 4.24
Fusible 3A | 0.172 | 0.27 | 1 | 0.172 | 0.27
Fusible 0,1A | 0.26 | 0.42 | 1 | 0.26 | 0.42
Switch | 0.5 | 0.75 | 1 | 0.5 | 0.75
USB B | 0.49 | 0.67 | 1 | 0.49 | 0.67
Connecteur4 | 0.152 | 0.3 | 3 | 0.456 | 0.9
Connecteur6 | 0.21 | 0.5 | 1 | 0.21 | 0.5
Pont en H | 2.5 | 5.52 | 1 | 2.5 | 5.52
R0,1, 2W | 0.3 | 0.8 | 1 | 0.3 | 0.8
TOTAL Composants |  |  |  | 19.418 | 32.476
Routage et carte |  |  |  | 8 | 12
TOTAL Solution |  |  |  | 27.418 | 44.476
