Kyklas/projet-plury-4eii-2012/Carte/pickit2-icsp.gif

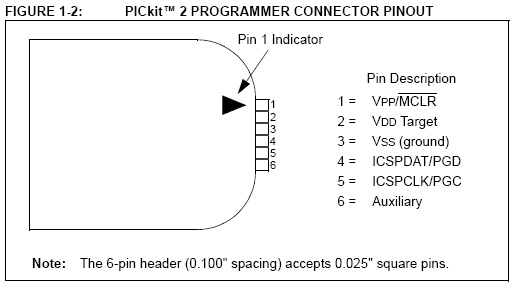
Carte/pickit2-icsp.gif
