Kyklas/projet-plury-4eii-2012/Photos/110CANON/IMG_0002.JPG

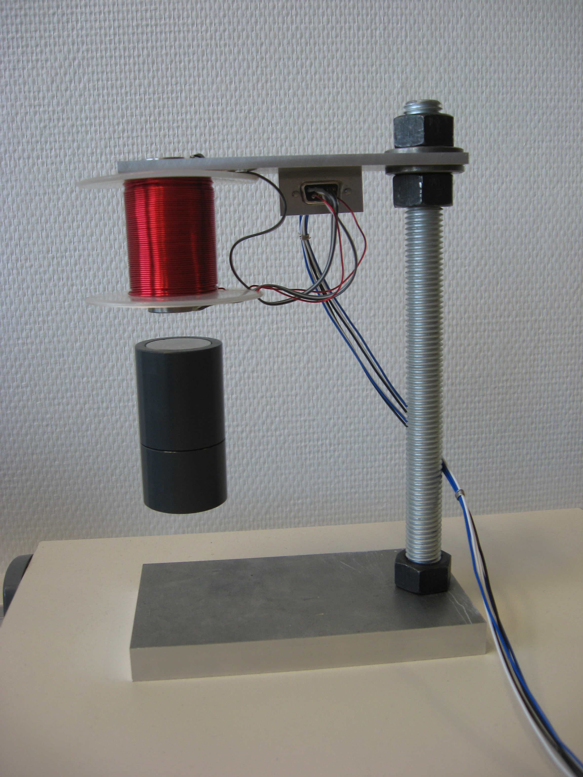
Photos/110CANON/IMG_0002.JPG
