Kyklas/projet-plury-4eii-2012/Photos/110CANON/IMG_0004.JPG

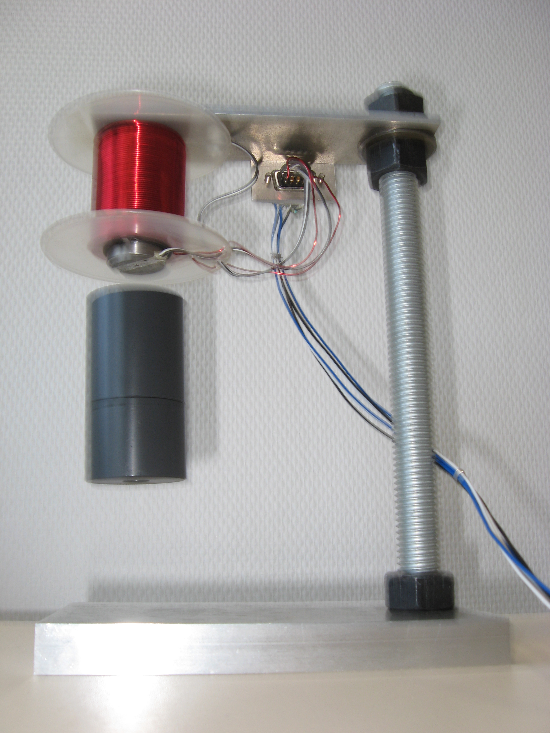
Photos/110CANON/IMG_0004.JPG
