Kyklas/projet-plury-4eii-2012/Photos/Carte1.jpg

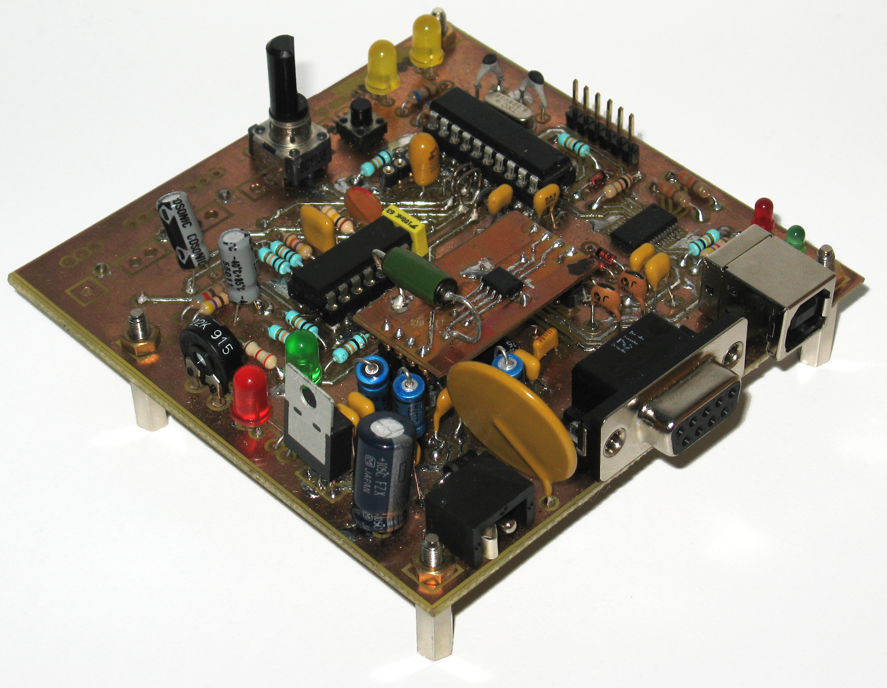
Photos/Carte1.jpg
