Kyklas/projet-plury-4eii-2012/Photos/Carte2.jpg

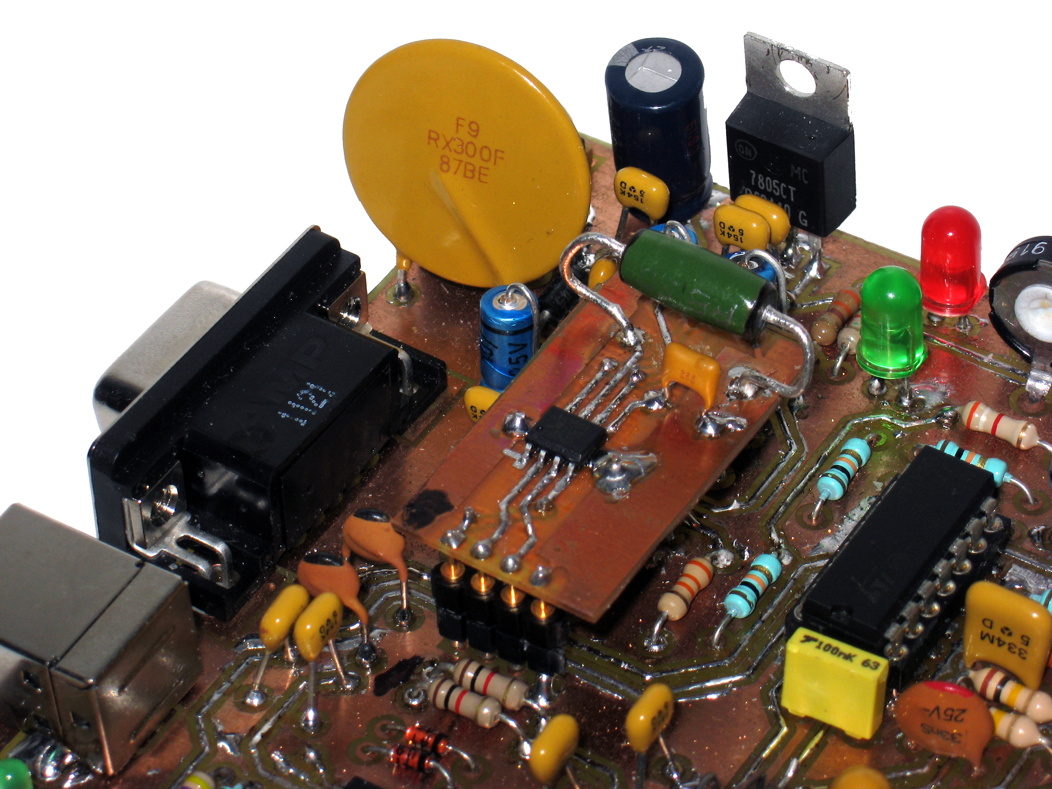
Photos/Carte2.jpg
