Kyklas/projet-plury-4eii-2012/Photos/Carte3.jpg

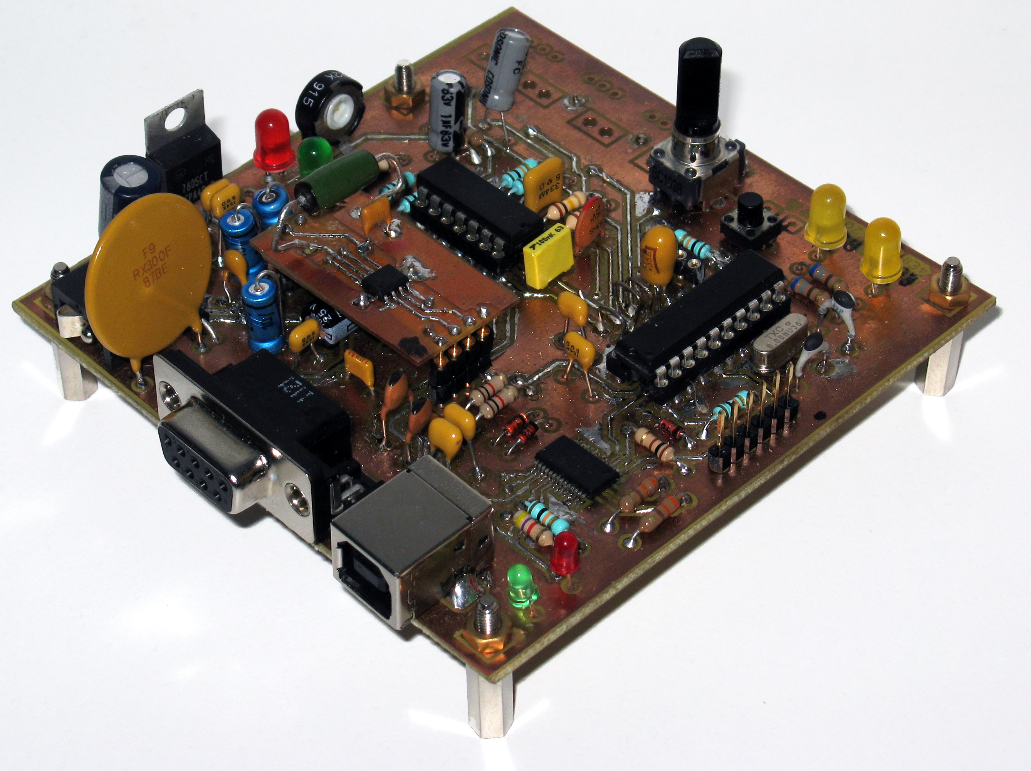
Photos/Carte3.jpg
