Kyklas/projet-plury-4eii-2012/Photos/CarteFront.png

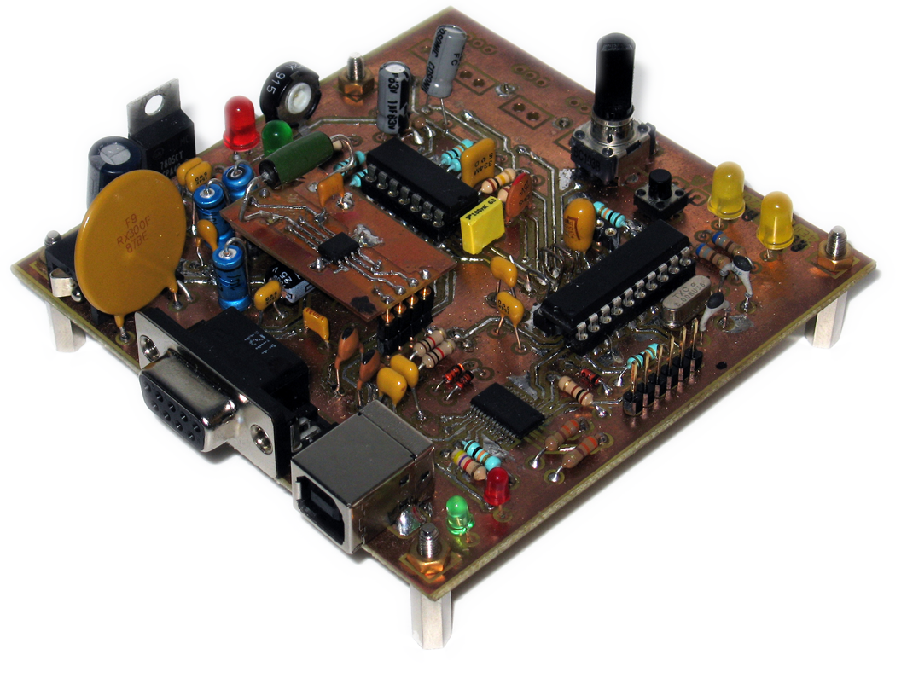
Photos/CarteFront.png
