Kyklas/projet-plury-4eii-2012/Photos/DSC00032.jpg

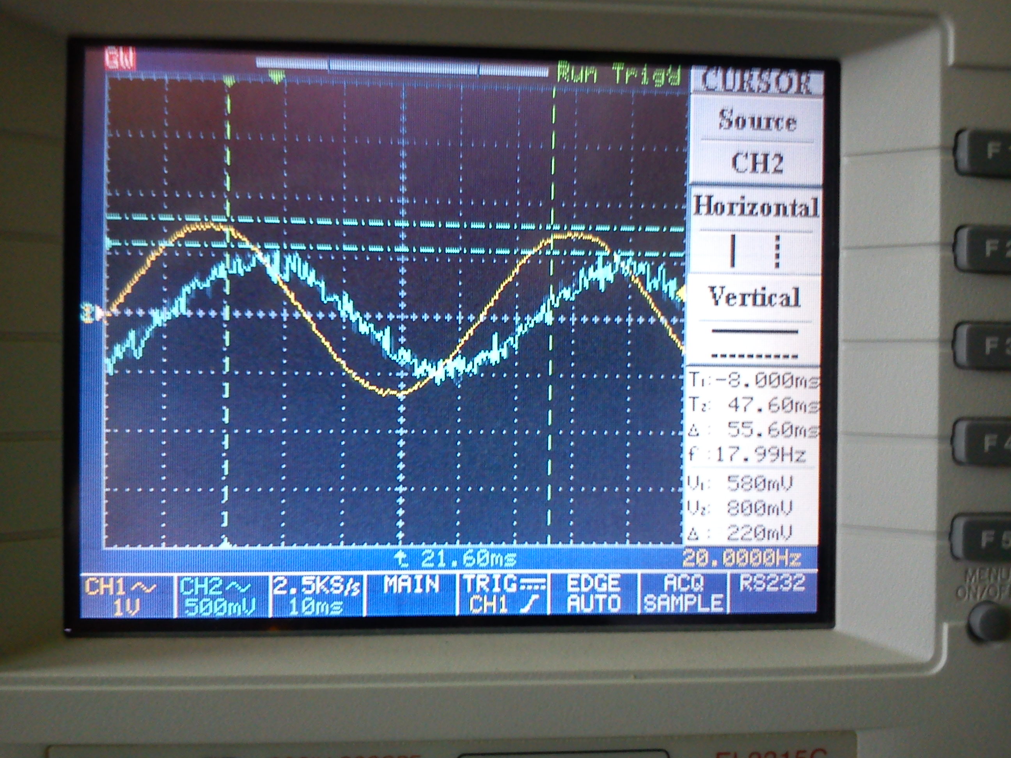
Photos/DSC00032.jpg
