Kyklas/projet-plury-4eii-2012/Photos/IR000015.IS2.PNG

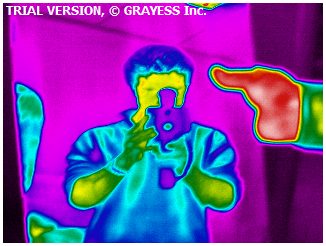
Photos/IR000015.IS2.PNG
