Kyklas/projet-plury-4eii-2012/Rapports/Schéma Fonctionelle.bmp

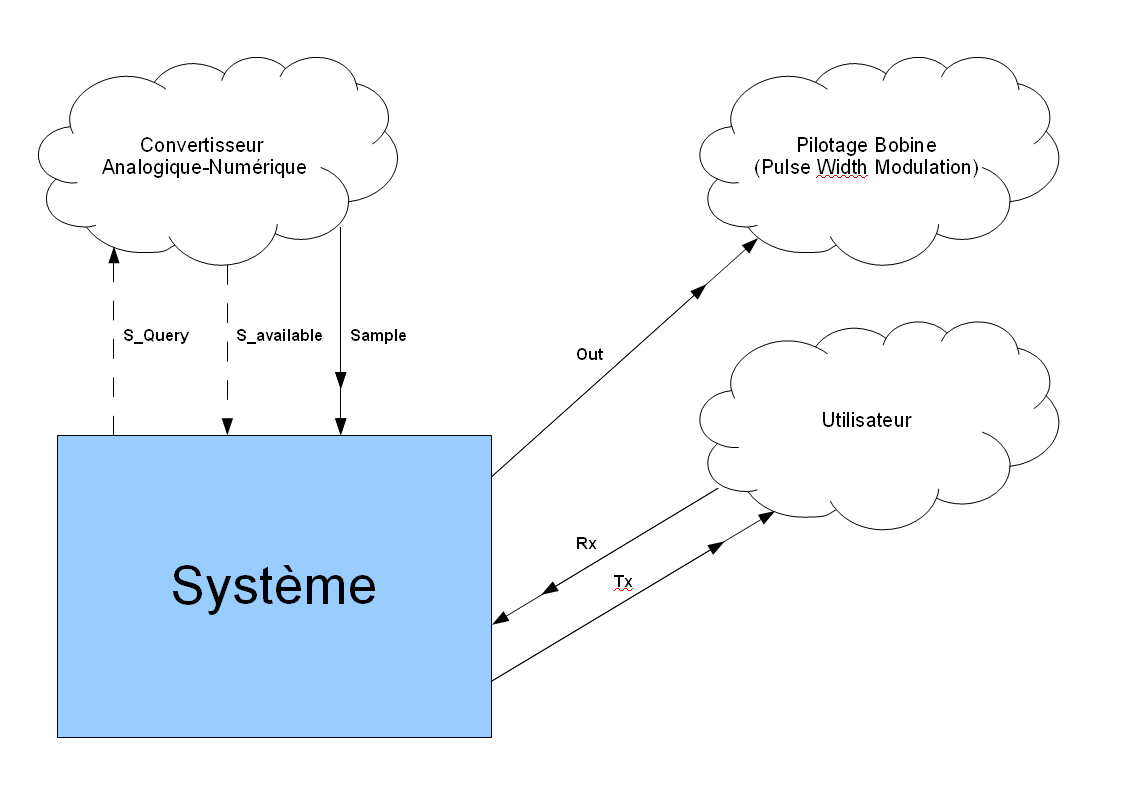
Rapports/Schéma Fonctionelle.bmp
