Kyklas/projet-plury-4eii-2012/Rapports/SolutionAnalogique/aphmat.png

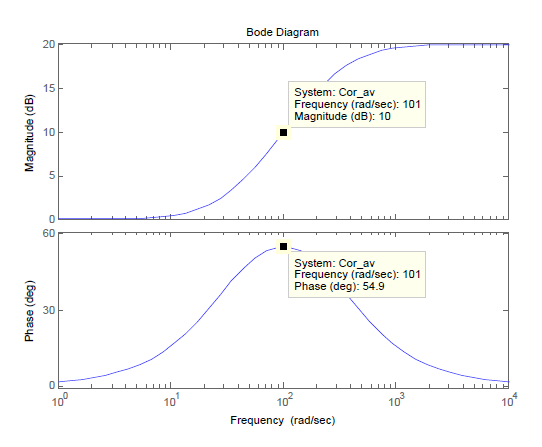
Rapports/SolutionAnalogique/aphmat.png
