Kyklas/projet-plury-4eii-2012/Rapports/SolutionAnalogique/capteur_effet_hall.jpg

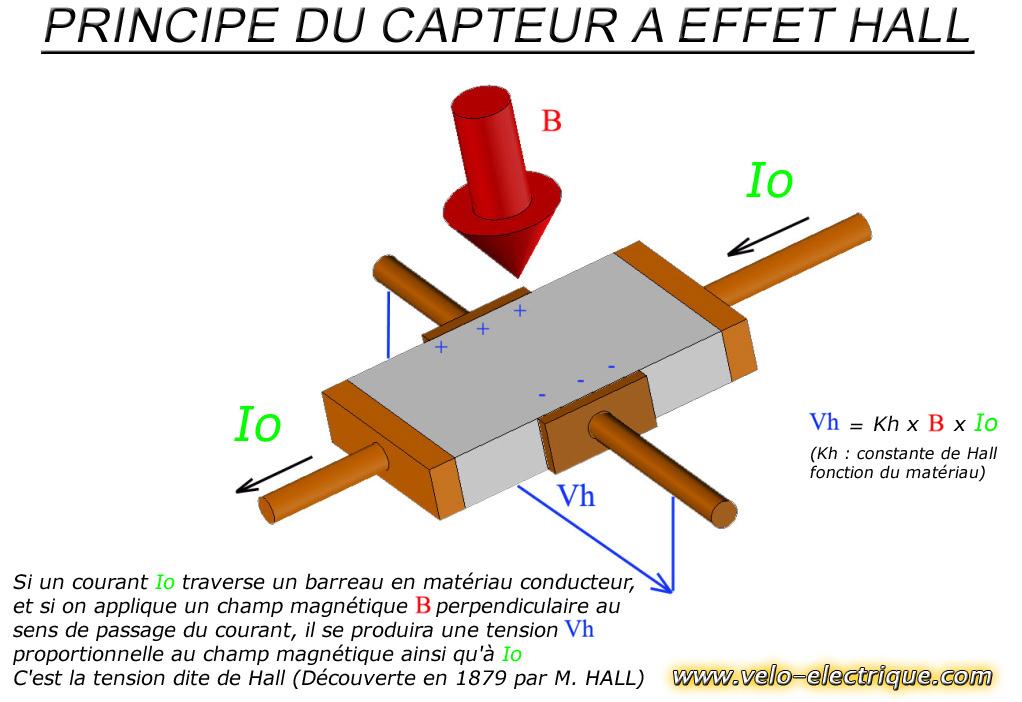
Rapports/SolutionAnalogique/capteur_effet_hall.jpg
