Kyklas/projet-plury-4eii-2012/Rapports/SolutionAnalogique/Dissipation.png

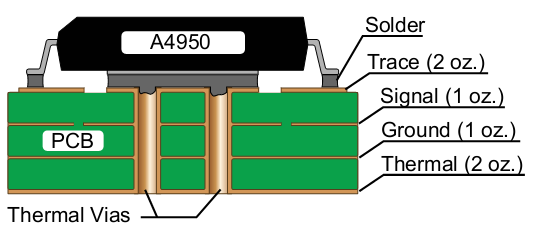
Rapports/SolutionAnalogique/Dissipation.png
