Kyklas/projet-plury-4eii-2012/Rapports/SolutionAnalogique/simuAvph.png

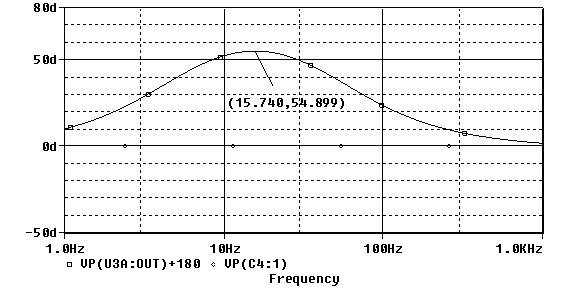
Rapports/SolutionAnalogique/simuAvph.png
