Kyklas/projet-plury-4eii-2012/(list of files, cad)

Other CAD files:
Rapports/SolutionAnalogique/EffetHall.skp
