Kyklas/projet-plury-4eii-2012/Rapports/SolutionNumerique/TestNumerique1.png

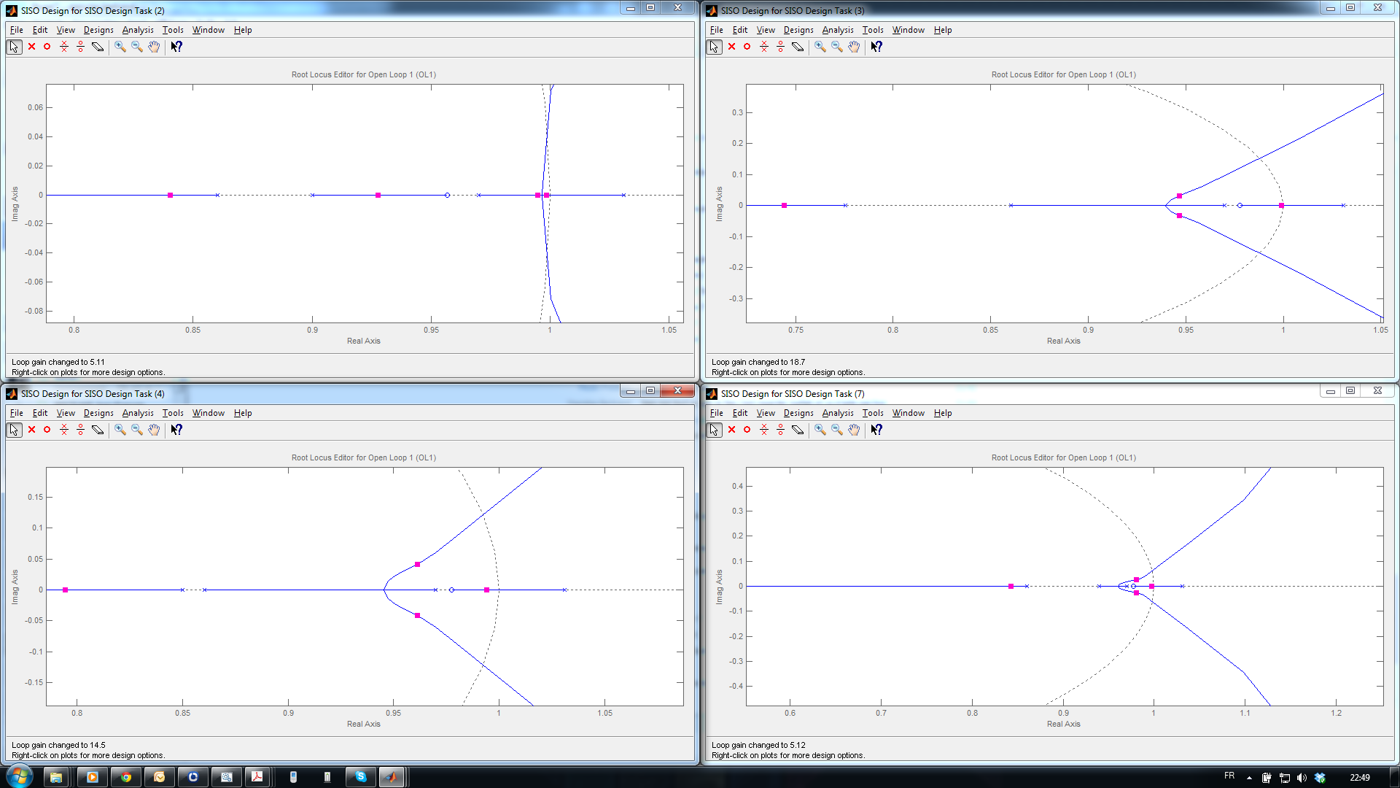
Rapports/SolutionNumerique/TestNumerique1.png
