Kyklas/projet-plury-4eii-2012/Rapports/SolutionNumerique/TestNumerique2.png

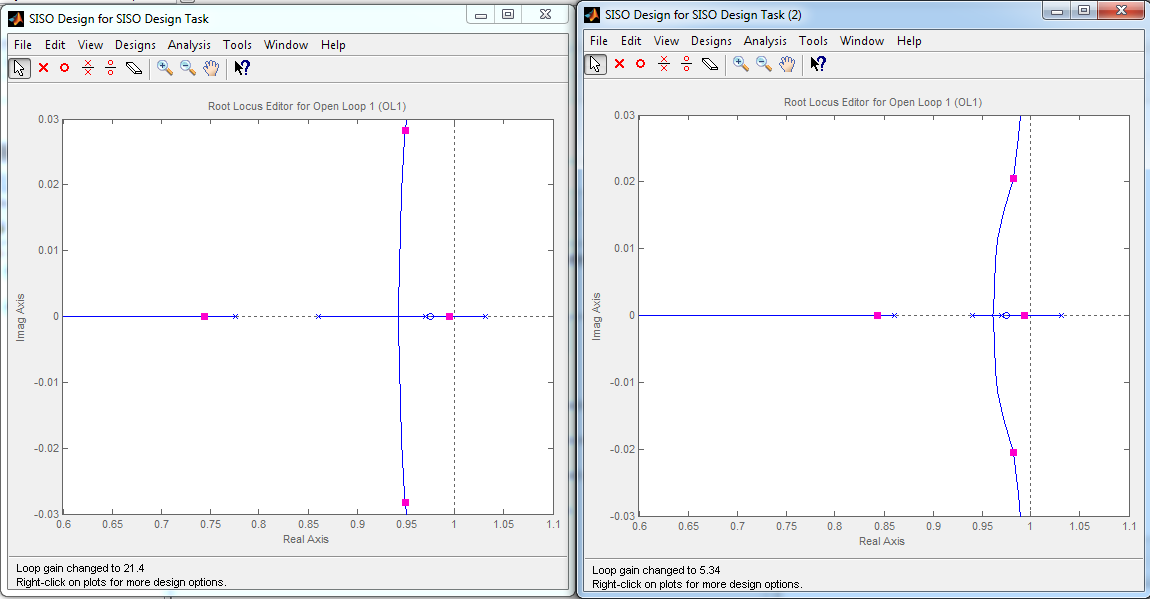
Rapports/SolutionNumerique/TestNumerique2.png
