Kyklas/projet-plury-4eii-2012/Rapports/SolutionAnalogique/Ponts.pdf

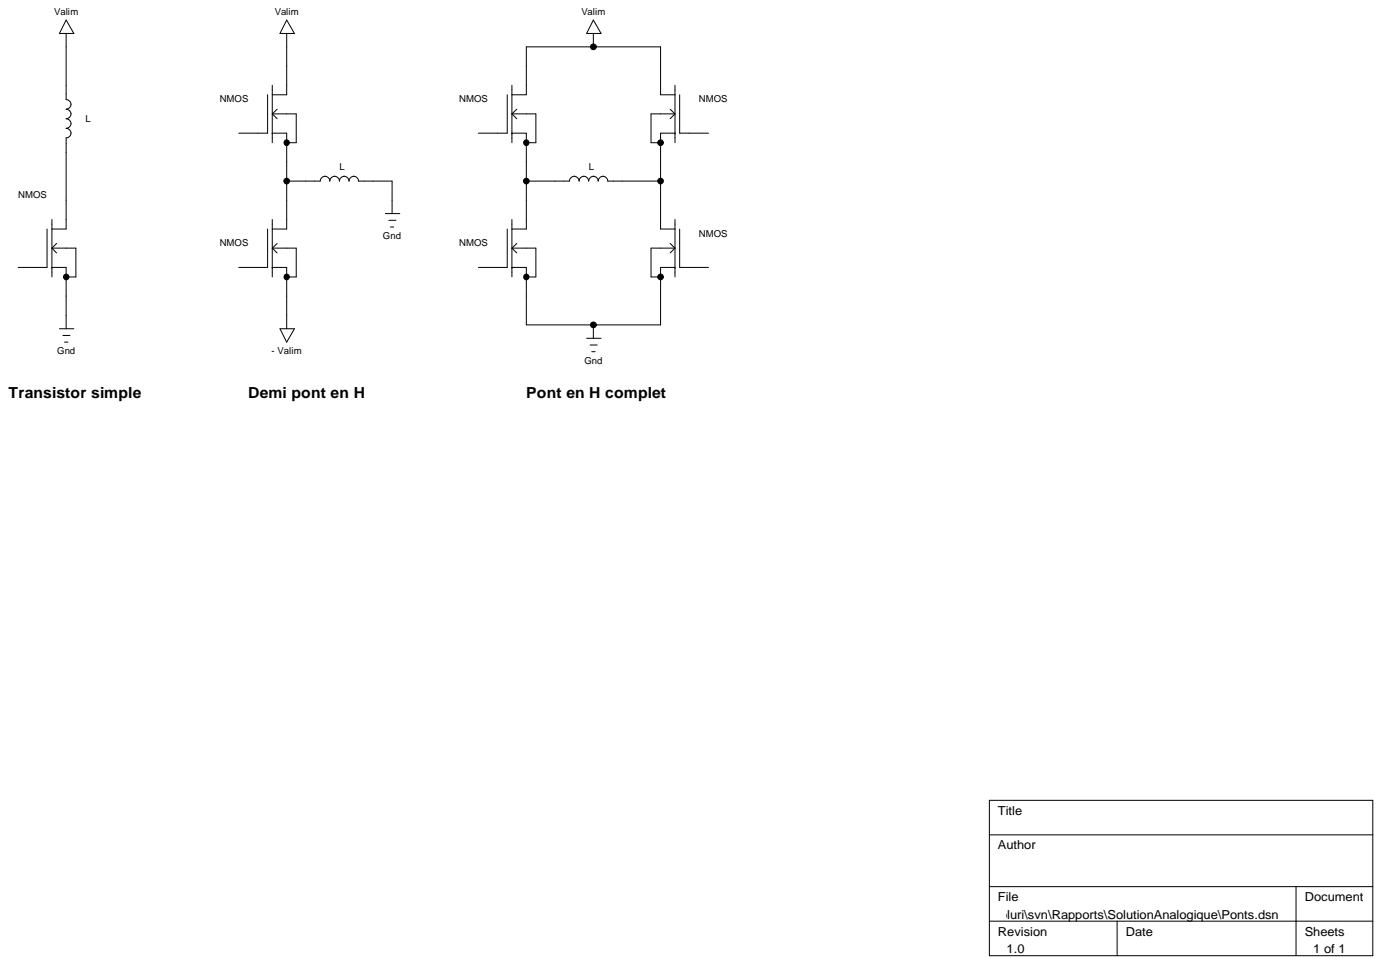
[picture p111: page 1]
NMOS; Valim; - Valim; Gnd; Demi pont en H; Pont en H complet; Transistor simple; Title; Author

File | Document

D:\INSA\Projet pluri\svn\Rapports\SolutionAnalogique\Ponts.dsn

Revision 1.0 | Date | Sheets 1 of 1
