Kyklas/projet-plury-4eii-2012/Rapports/SolutionAnalogique/AmpInstCons.pdf

H

1

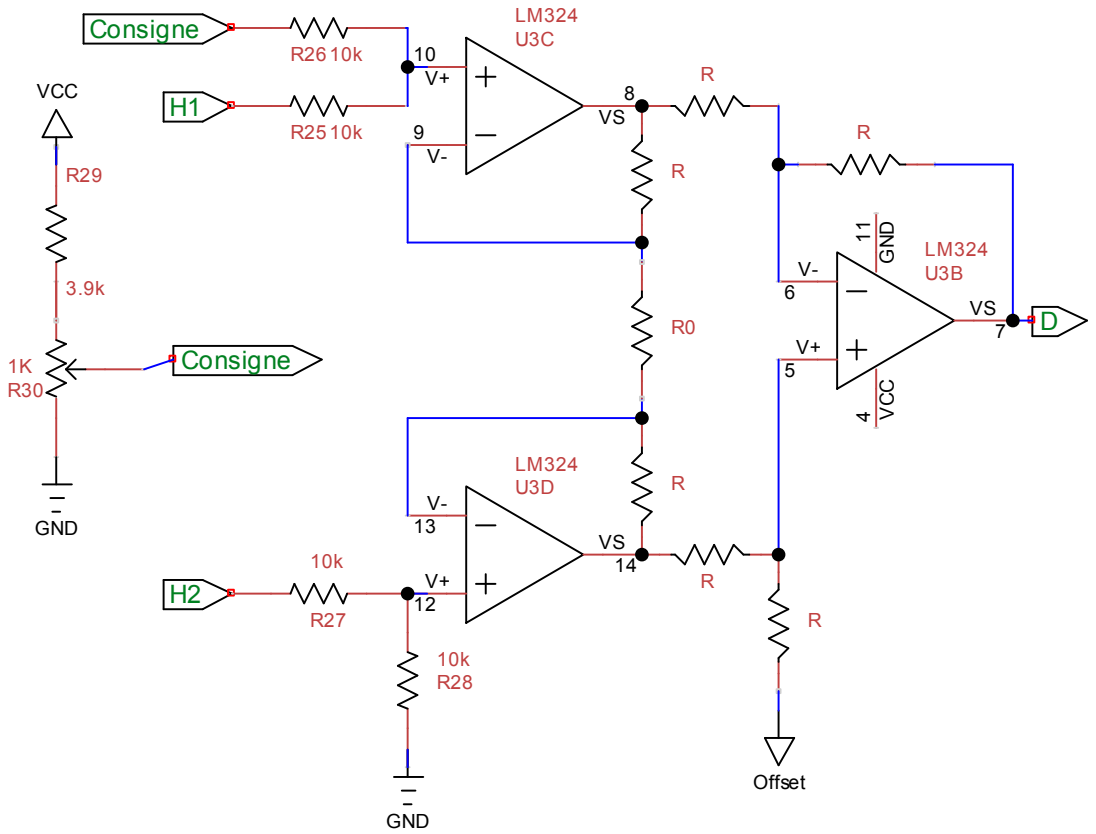
[picture p112: page 1]
RRR; VCC; GND
