Kyklas/projet-plury-4eii-2012/Rapports/SolutionAnalogique/AvPhase.pdf

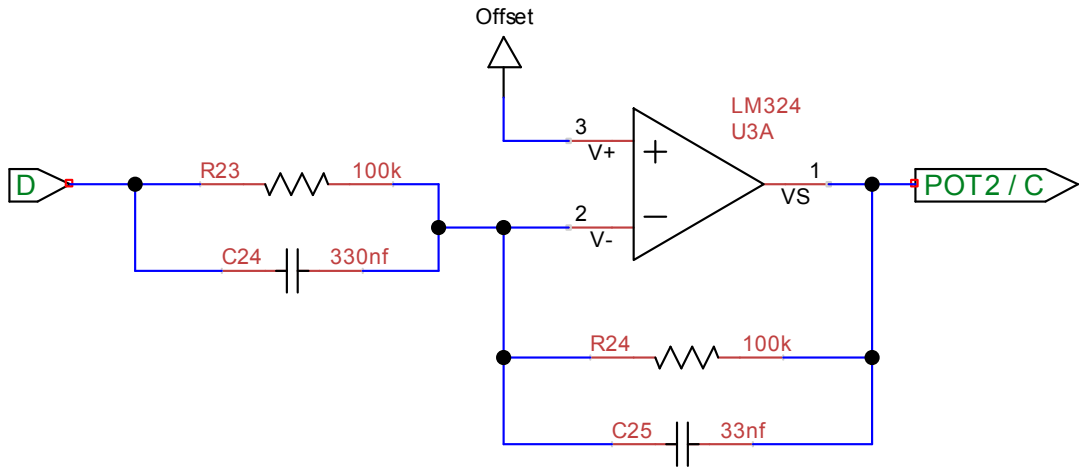
[picture p113: page 1]
