Kyklas/projet-plury-4eii-2012/Automatique/MatBlackFredValues.pdf

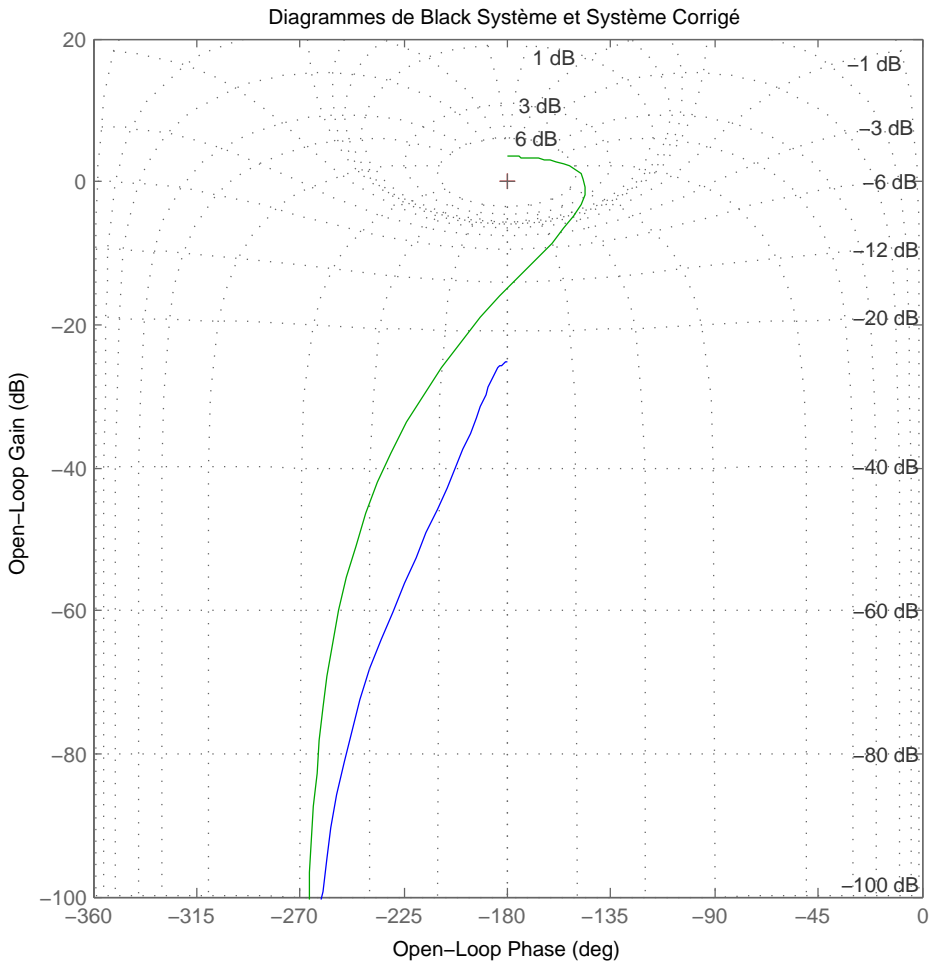
[picture p114: page 1]

Diagrammes de Black Système et Système Corrigé

Open−Loop Gain (dB)

Open−Loop Phase (deg)
