Kyklas/projet-plury-4eii-2012/Automatique/MatBlack.pdf

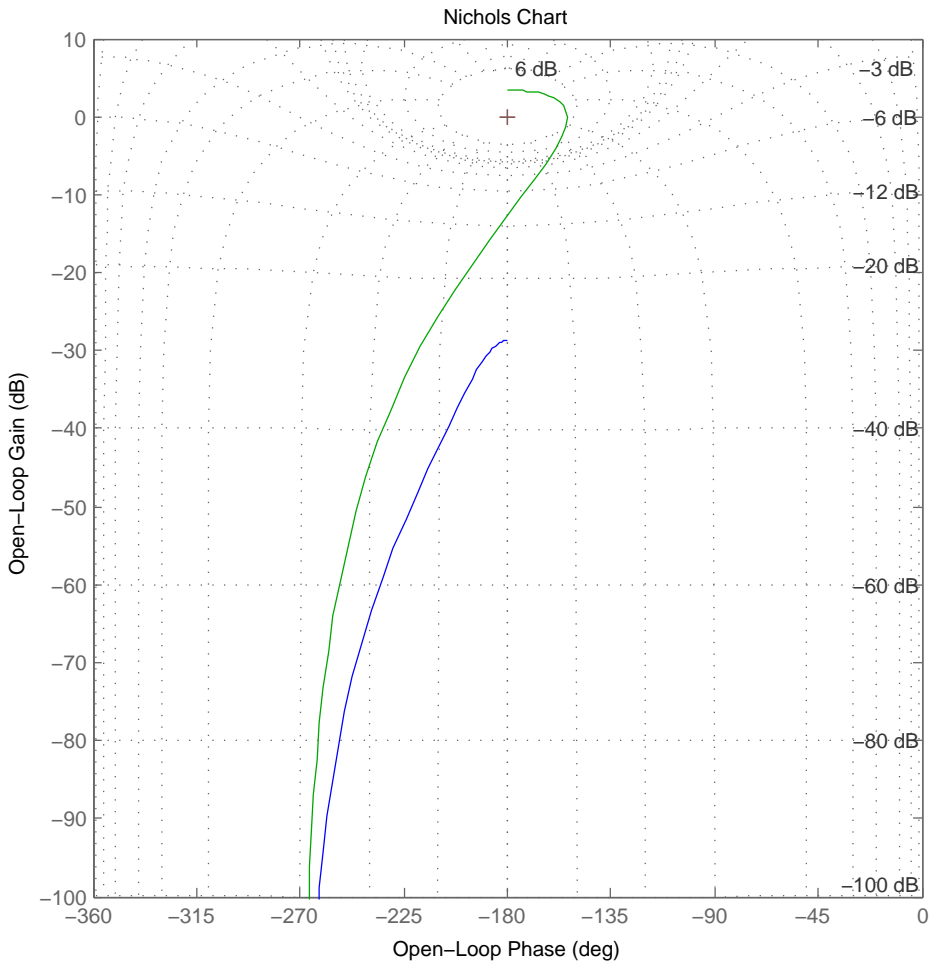
[picture p115: page 1]
Nichols Chart

Open−Loop Gain (dB)

Open−Loop Phase (deg)
