Kyklas/projet-plury-4eii-2012/Carte/PCB/PCB.pdf

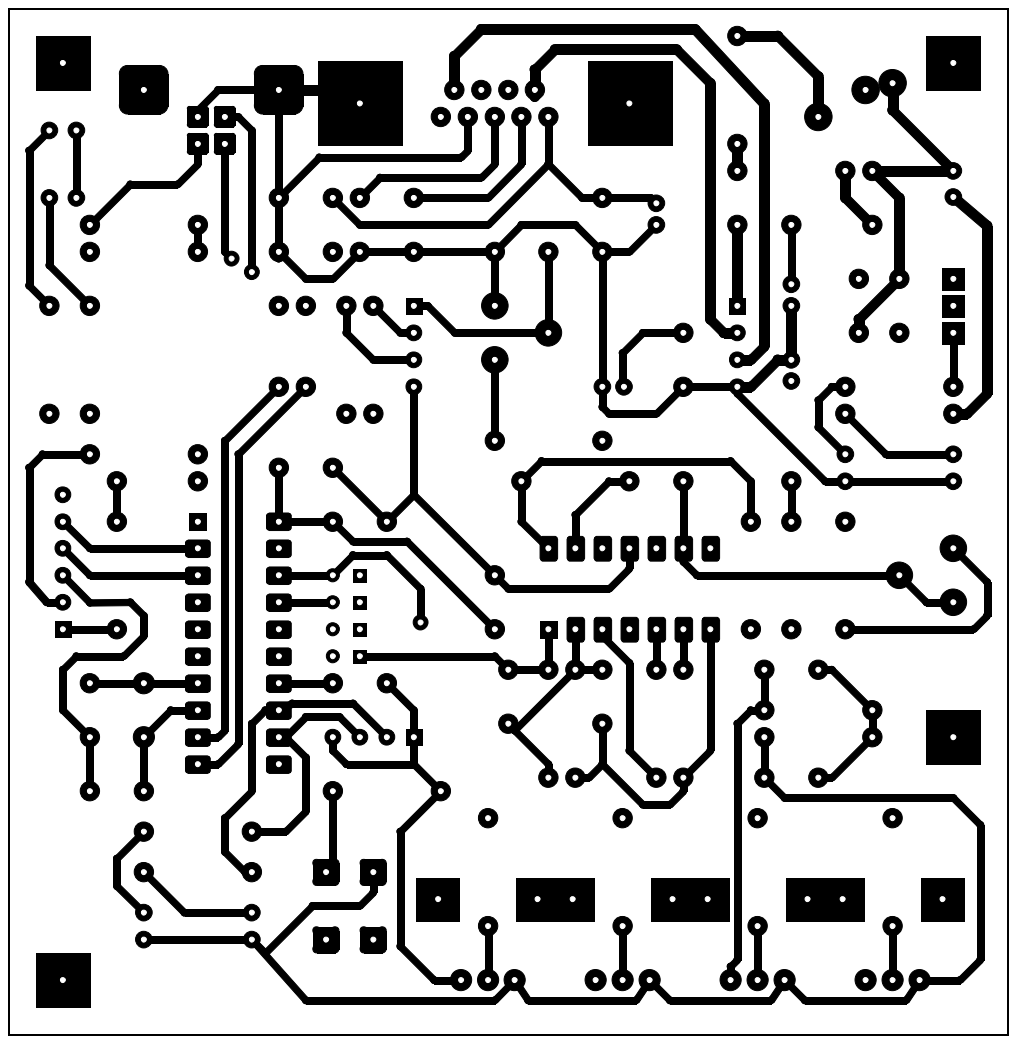
[picture p116: page 1]

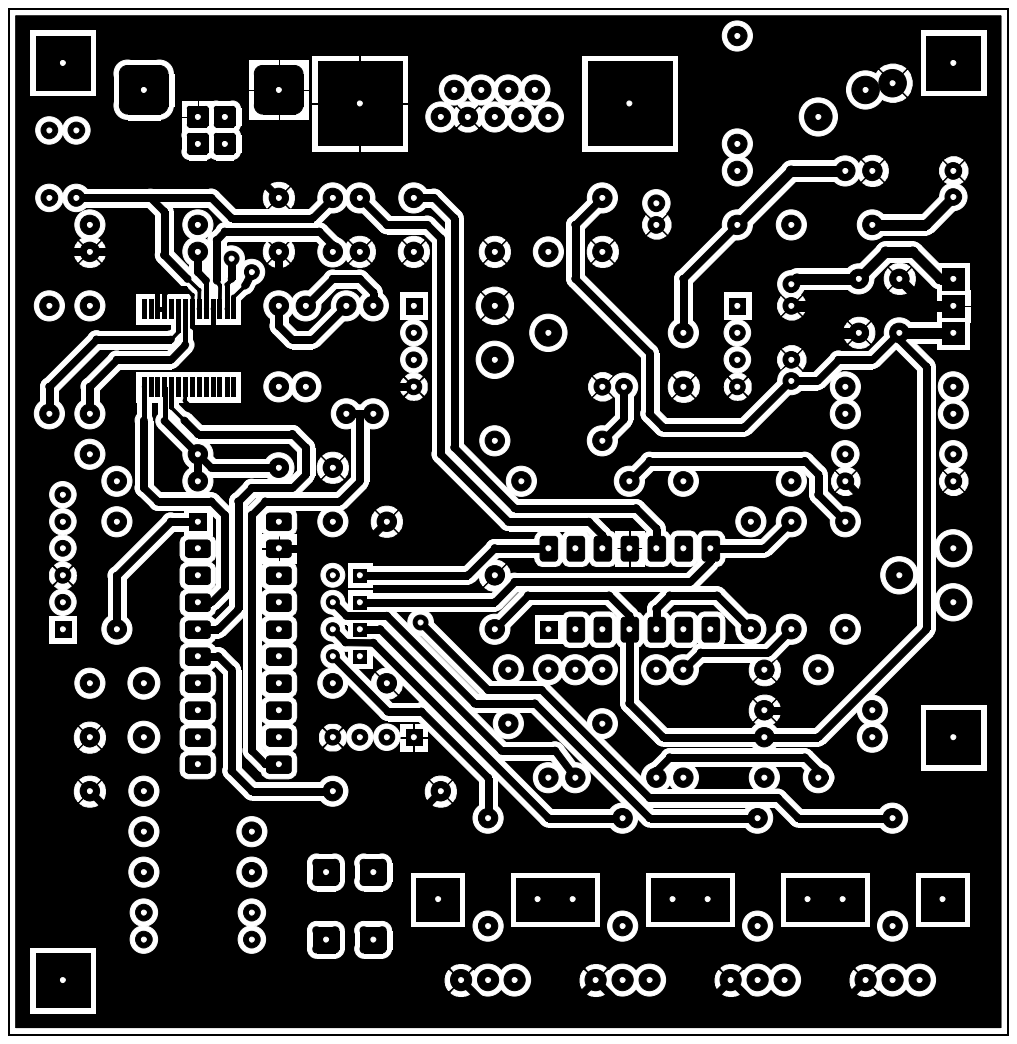
[picture p117: page 2]
