Kyklas/projet-plury-4eii-2012/(list of files, drawings)

Other design files:
Carte/PCB/Pluri.dsn
Carte/PCB/Pluri_unrouted.dsn
Carte/Schematique/Carte.dsn
Carte/Simulations/PP.DSN
Carte/Simulations/PP.opj
Rapports/SolutionAnalogique/Ponts.dsn
