Kyklas/projet-plury-4eii-2012/Carte/Mesures/Mesure Diff.txt

Test différentiel :
14 mm :
Sans Courant : 0.9V
Courant 1.28 : 0.95 V
courant 1.6  : 0.94V

15mm :
Sans Courant : 1.072 V
Courant 1.28 : 1.043 V
Courant 1.6 : 1.04 V

16mm :
Sans courant : 1.19 V
Courant 1.28 : 1.189 V
Courant 1.6 : 1.19 V
