Kyklas/projet-plury-4eii-2012/Micro/ProjetAnalogique.X/IO.c

/**
 * \file IO.c
 * \brief Entrées Sorties
 * \author Xavier & Romain
 * \version 0.1
 * \date 28 mars 2012
 */

#include "IO.h"

/**
 * \fn void IO_Init ()
 * \brief Initialisation du E/S
 */
void IO_Init()
{
    // ======================================
    // Direction des E/S
    // ======================================

    TRISAbits.TRISA0 = 1; // PGEC
    TRISAbits.TRISA1 = 1; // PGED
    TRISAbits.TRISA2 = 0; // OscO
    TRISAbits.TRISA3 = 1; // OscI
    TRISAbits.TRISA4 = 0; // Mode 2
    // Mclr & Vcap : Réglage hardware


    //TRISBbits.TRISB0 = 0; // Tx
    //TRISBbits.TRISB1 = 1; // Rx
    TRISBbits.TRISB2 = 1; // Button

    TRISBbits.TRISB4 = 0; // MODE 1

    TRISBbits.TRISB7 = 0; // PWM
    TRISBbits.TRISB8 = 0; // SCL
    TRISBbits.TRISB9 = 1; // SDA
    TRISBbits.TRISB12 = 1; // Pot1/C
    TRISBbits.TRISB13 = 1; // Pot2/D
    TRISBbits.TRISB14 = 1; // Pot3/H2
    TRISBbits.TRISB15 = 1; // Pot4/H1

    // ======================================
    // Analogique
    // ======================================

    ANSAbits.ANSA0 = 0;
    ANSAbits.ANSA1 = 0;
    ANSAbits.ANSA2 = 0;
    ANSAbits.ANSA3 = 0;

    ANSBbits.ANSB0 = 0;
    ANSBbits.ANSB1 = 0;
    ANSBbits.ANSB2 = 0;
    ANSBbits.ANSB4 = 0;
            
    ANSBbits.ANSB12 = 1;
    ANSBbits.ANSB13 = 1;
    ANSBbits.ANSB14 = 1;
    ANSBbits.ANSB15 = 1;
}
