Kyklas/projet-plury-4eii-2012/(commit log)

2012-02-12 Ajout du début du rapport Automatique de Fred
2012-02-12 - Renomage du répertoire Rapport en Rapports - Ajout d'une feuille de calcul reprenant les données "automatiques" du problème + estimation de certains paramètres et étude rapide du point de fonctionn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
    [etude_systeme.ods]
2012-02-12 Ajout du travail fait sous Matlab et début des diagrams
2012-02-13 - Mise à jour du rapport - Ajout d'une figure inkscape pour la maquette
2012-02-13 Ajout des modifications suite à la réunion, prise en compte des nouvelles constantes
2012-02-13 On laisse tomber bodegraph et on fait avec des exports pdf depuis Matlab. Début du schéma bloc. Constantes placées dans Constantes.m pour inclusion dans latex à voir
2012-02-14 - Ajout d'une feuille de calculs physique dans le classeur de données
    [etude_systeme.ods]
2012-02-14 - Ajout du calcul de Kx et Ki et de Kbob - Mise en équations (incomplète) du système
    [etude_systeme.ods]
2012-02-14 - Nouveau Kx et Ki
    [etude_systeme.ods]
2012-02-14 Systèmes avec les valeurs de Fred
2012-02-14 Ajoute des exports depuis matlab ( root locus analogique et numérique )
2012-02-15 Définition des style pour les schemas
2012-02-15 Modification de graph et ajustement dans MCSE.tex
2012-02-16 fin de test
2012-02-16 - Mise à jour du raport : ajout de la figure
    [etude_systeme.ods]
2012-02-27 Ajout des moficiations pour le rapport d'automatique, figures matlab
2012-02-27 Modification des digrammes d'evans en numérique
2012-02-27 - Actualisation de la modélisation mathématique avec nouvelle méthode de détermination des constantes
    [etude_systeme.ods]
2012-02-27 Prise en compte du vrai KHall, modification des figures en conséquence.
2012-02-27 Modification sur les schémas
2012-02-27 Correction des modifications de Xavier
2012-02-29 modification des diagrammes
2012-02-29 Commit pour ajout de style MCSE
2012-02-29 Styles dans un fichier séparé Avancement sur les diagrammes
2012-02-29 Ajout de Transmition.tex et Reception.tex
2012-03-06 Modification des styles pour avoir quelque chose de plus petit
2012-03-06 - Ajout des datasheets composants - Ajout de lib personnalisée
    [Carte.dsn]
2012-03-06 Fin des schema
2012-03-07 fin de séance 2
2012-03-07 - 3 / 4 schéma carte d'asservissement - ajout de la datasheet des capteurs - nouveaux modèles de composants (FT232RL, AT..)
    [Carte.dsn]
2012-03-08 modification, proche de la fin !!!
2012-03-08 modification de quelques schema
2012-03-09 made by Xavier (pour une fois, faut le noter !) MAJ et fin (espérée) du rapport de MCSE
2012-03-11 - Schéma carte complet (à vérifier avec du recul) - Calculs à faire sur le correcteur
    [Carte.dsn]
2012-03-13 - Mise à jour de la carte - Correction erreurs de nommage - Correction de la structure du correcteur analogique
    [Carte.dsn]
2012-03-15 - Dernière version de la carte avant routage
    [Carte.dsn]
2012-03-18 MAJ programme de test: clignotement de led + test du µc
2012-03-18 - Finitions sur schéma carte - Optimisation schéma pour routage - Routage de la carte - Empreintes vérifiées
    [Carte.dsn, Pluri.dsn, Pluri_unrouted.dsn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]
2012-03-18 - Ajout des layers en PDF - Quelques corrections pour améliorer la qualité du PCB
    [drill_file.drl]
2012-03-19 Etude de l'avance de phase : validation du modèle et valeurs de composants
2012-03-27 Ajout des modifications et des simulations orcade
    [PP.DSN, PP.opj]
2012-03-27 Ajout des mesures effectuées sur le montage différentiel pour les capteurs hall.
2012-03-27 Modification de l'extention du fichier
    [Mesure Diff.txt]
2012-03-28 fin de scéance du 28 mars : PWM, PLL & IO
2012-03-29 Création ADC.c et ADC.h , bugs avec inclusion .h
    [IO.c, IO.h, main.c]
2012-04-01 Ecriture des codes pour ADC et TIMER, compréhension et résolution du bug sur l'inclusion de p24fv32ka301.h Impossible de tester car bugs sur toutes les fonctions ==> multiple définition assez peu com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
    [ADC.c, PLL.c, PLL.h, PWM.h, TIMER1.c, TIMER1.h]
2012-04-01 Programme de test ADC+ TIMER1 Conclusion : échec, tentative ultérieure Build et implantation avec succès cependant
2012-04-01 Test du timer : fonctionnel avec quelques détails à vérifier Test de l'adc : manque connexion du potentiomètre1 au µc pour tester
2012-04-02 - Modifications mineures du plan de la carte - Correction d'erreurs dans le code du projet micro
    [Carte.dsn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]
2012-04-03 MAJ programme, ADc en mode auto, toujours pas fonctionnel....
2012-04-03 PWM piloté par ADC : OK
2012-04-04 Ce que j'ai fait, je vais le rajouter dans le rapport
2012-04-17 Modification du schema pour prendre en compte la consigne
    [Carte.dsn]
2012-04-24 Ajouts du plan du rapport pour la Solution Analogique, modification de fichier existant.
2012-04-27 Avancement sur le rapport, partie différentiel
    [EffetHall.skp]
2012-04-28 Ajout du PCB de la carte puissance.
2012-04-28 - Corrections et précisions sur la partie conditionnement (Stanislas)
2012-04-28 Finalisation de la partie differentiel
2012-04-29 Image pour l'avance de phase ( pdf ) Ajout d'une partie protocole de test / mise en fonctionnement en premiere partie de la conclusion
2012-04-29 avancement de la partie Correcteur à avance de phase dans le rapport sur la partie analogique
2012-04-29 Image Simulation Orcad Avance de phase
    [PP.DSN, PP.opj]
2012-04-29 Rapport : - partie avance de phase (précisions à voir avec stan pour la fin) - partie microcontrolleur : choix du µc
2012-04-29 commentaire dans les .c
2012-04-29 Avancement de la partie puissance
    [Ponts.dsn]
2012-04-29 Ajout de Photos
2012-04-29 Rapport : -modifications dans la partie correcteur à avance de phase (ordonnancement des paragraphes plus logique) -écriture de la partie sur le CAN annexe pour le code ?? histoire de gain de l'avanc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
    [ADC.c]
2012-05-01 Ajout de la partie PWM et modification du choix de micro
2012-05-02 MAJ Rapport, Correction dans la partie avance de phase
2012-05-02 Rapport : partie avance de phase termine (mise en page améliorable) Photos avance de phase
2012-05-02 Réduction de poids de l'image avph_reel (6mo ==> 700ko)
2012-05-03 Commit de Xavier (faut rendre à César ce qui est à César quand même) Etude du prix de la carte (excel)
    [prix carte.xlsx]
2012-05-03 Modification de la page de garde. Ajout d'une référence bibliographique
2012-05-03 Mise à jour du rapport : - Ajout de la partie prix de la Carte - légende de toutes les figures qui ne l'étaient pas (vérifier que la légende vous convient bien... et légendez vos futures figures, ça 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
    [prix carte.xlsx]
2012-05-03 Ajout des photos thermique
2012-05-04 - Avancement de la partie thermique
2012-05-04 Rapport : évaluation du prix de la solution pour 1seule pièce modification de la partie du rapport en conséquence
    [prix carte.xlsx]
2012-05-04 Ajout des images manquantes pour la partie thermique
2012-05-04 - Ajout de l'image de la camera thermique
2012-05-04 Ajout de la dernière partie : Conclusion
2012-05-04 - Avancement du rapport (mais pas fini) - Il reste les images à caler et faire l'intro (je m'en occupe) - Je vais ajouter certaines images en annexe
2012-05-05 Routage de la partie puissance V1(vérifiée, doit être correcte même si peut être améliorable)
2012-05-05 Routage de la nouvelle carte de puissance, autre possibilité Avantages : il n'y a plus de fil qui passe entre les pattes du pont en H Inconvénients : il faut agrandir un peu la carte
2012-05-05 Aml mineure de la V1 création de la V3 : V améliorée car ne nécessite plus que agrandissement selon 1 côté (contrepartie : piste de masse longue...)
2012-05-05 Descriptif des versions de la puissance2
2012-05-06 Amélioration de la v3 du routage (plus d'agrandissement nécessaire)
2012-05-08 Ajout de la partie numérique
2012-05-09 UART.c et UART.h fonctionnel
2012-05-16 Correction numérique qui marchouille !!
    [PWM.c, PWM.h, TIMER1.c, UART.c]
2012-05-21 Une com qui marche avec tt les fonctionnalités : Log Read Write
    Les code est pas commenté mais il est 0h30 et je vais faire dodo ^^ !
2012-05-22 Modification des fichiers matlab pour les tests d'asservissement numérique
2012-05-22 Base du Rapports de la Solution Numerique
2012-05-22 - Ajout de la partie communication - Manque encore l'implémentation du protocole sur le micro
2012-05-23 Printscreen IHM.png
2012-05-23 - Complétage du protocole - Ajout du début de la partie interface - Ajout d'un schéma pour illustrer la répartition des gains
2012-05-23 Mise à jour du rapport numérique
    Premier jet pour intro, changement de puissance et gimmicks
2012-05-23 Modification pendant la seance
2012-05-23 Rapport numérique - ajout de la conclusion - correction orthographique de la partie correcteur numérique
    revoir mise en page correcteur numérique ??? (figure et texte placés bizarrement)
2012-05-24 Ajustement de l'image et quelques corrections
2012-05-24 - Quelques corrections de français
2012-05-24 ??? - il parait que c'est pas à jour ???
2012-05-24 - Ajout de la présentation - Ajout des images
